jemiliano2001-blip/SMV-VISION/TOOL CRIB/PUNZONES-DE-MARCA_HOT-STAMPS/PUNZONES DE MARCA.iso.pdf

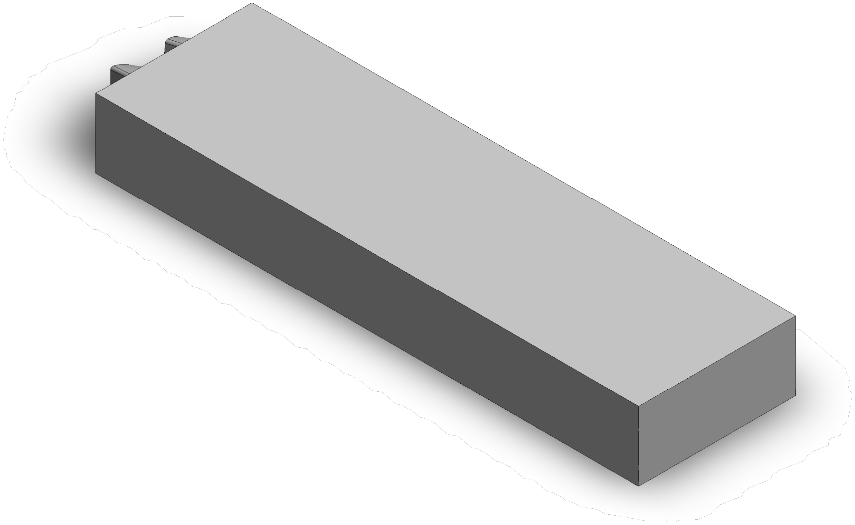
[picture p2: figure]
