jemiliano2001-blip/SMV-VISION/TOOL CRIB/SCREW-GOLDEN_CUTTING-BLADE-PORTUGUESA/SCREW GOLDEN FOR CUTTING BLADE.iso.pdf

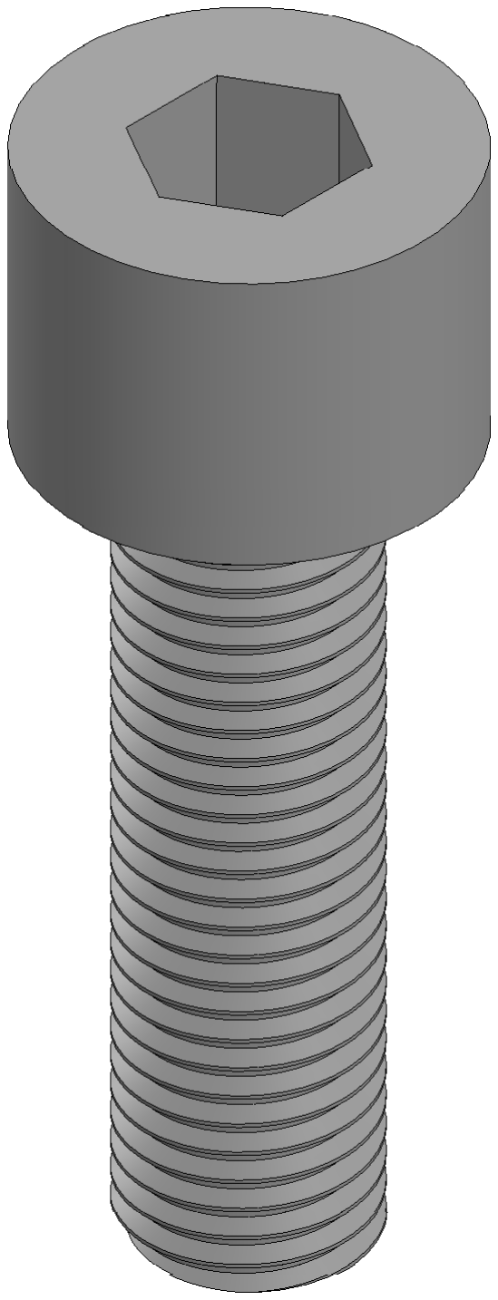
[picture p3: figure]
