jemiliano2001-blip/SMV-VISION/TOOL CRIB/_SIN-CLASIFICAR/14259-63-20-93/14259-63-20-93.iso.pdf

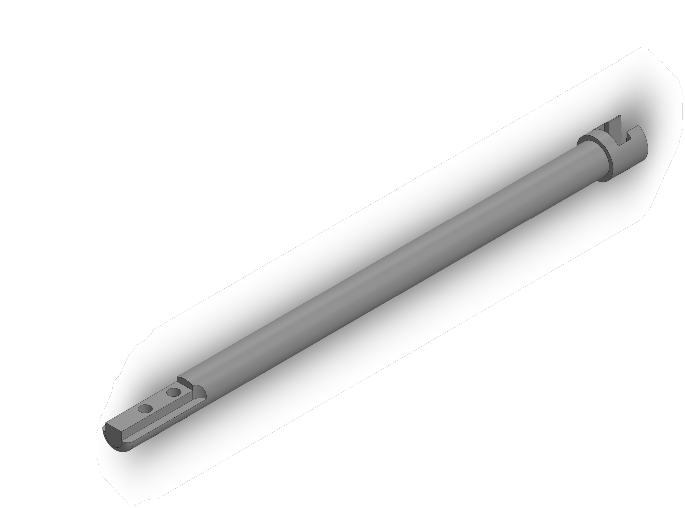
[picture p4: page 1]
