jemiliano2001-blip/SMV-VISION/TOOL CRIB/_SIN-CLASIFICAR/386306/386306.iso.pdf

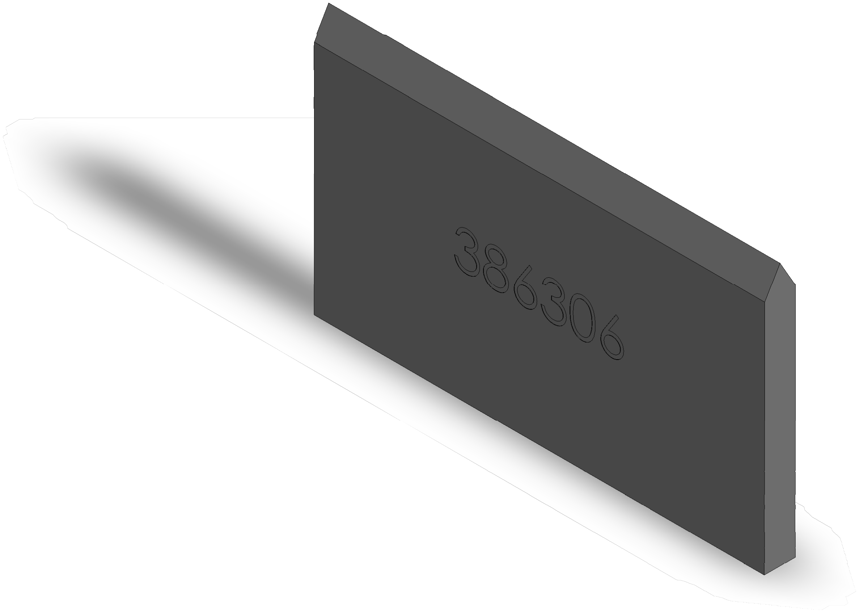
[picture p5: figure]
