jemiliano2001-blip/SMV-VISION/TOOL CRIB/_SIN-CLASIFICAR/90-1216/90-1216.iso.pdf

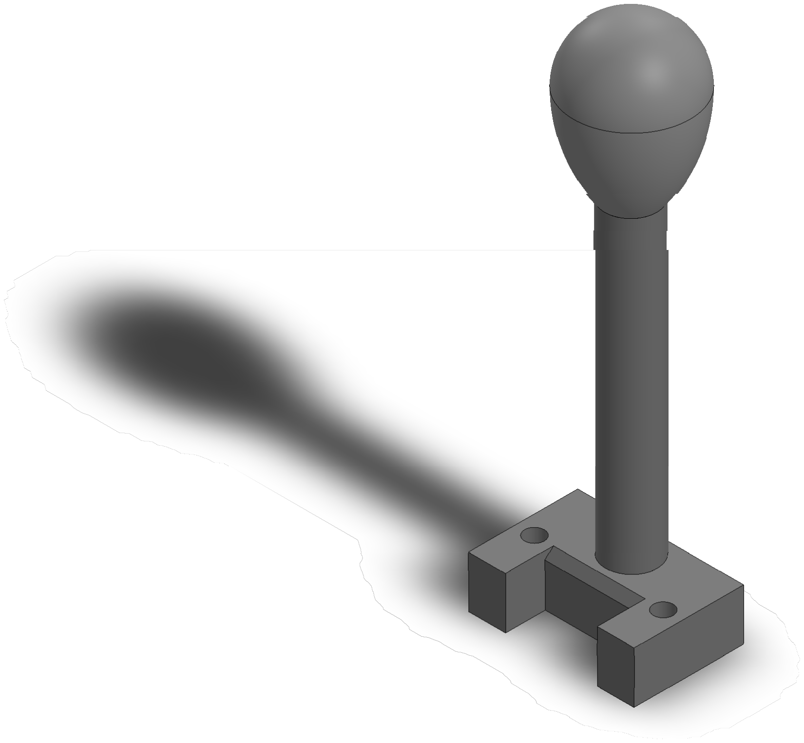
[picture p6: figure]
