jemiliano2001-blip/SMV-VISION/TOOL CRIB/_SIN-CLASIFICAR/90-3262_Rev4_UPSET-CONDUIT-CLAMP/upset-conduit-clamp.iso.pdf

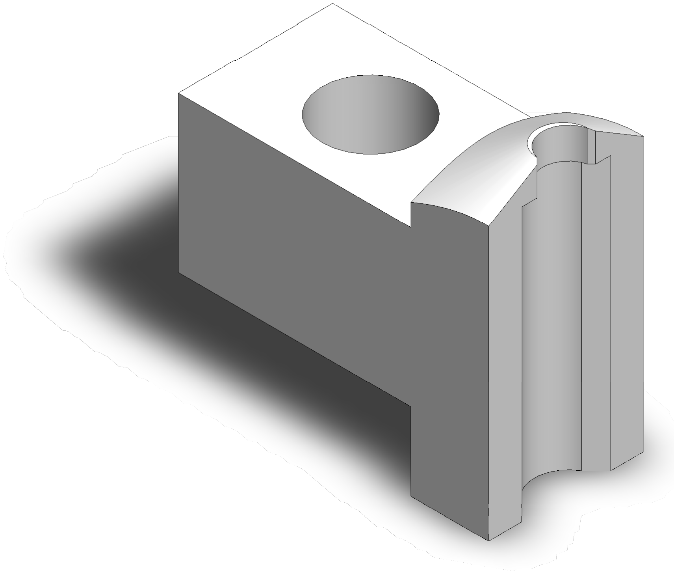
[picture p7: figure]
