jemiliano2001-blip/SMV-VISION/TOOL CRIB/_SIN-CLASIFICAR/90-3342_PIN-STRIPPER/pin stripper 90-3342.iso.pdf

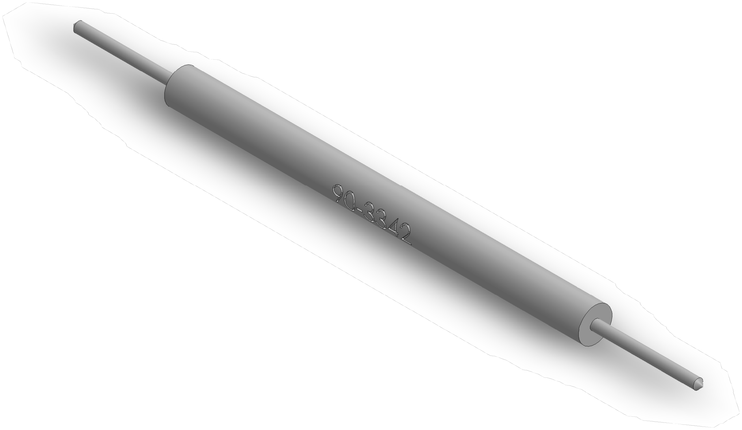
[picture p8: figure]
