jemiliano2001-blip/SMV-VISION/TOOL CRIB/BLOCKS/BLOCK-1135-2/block 1135-2.iso.pdf

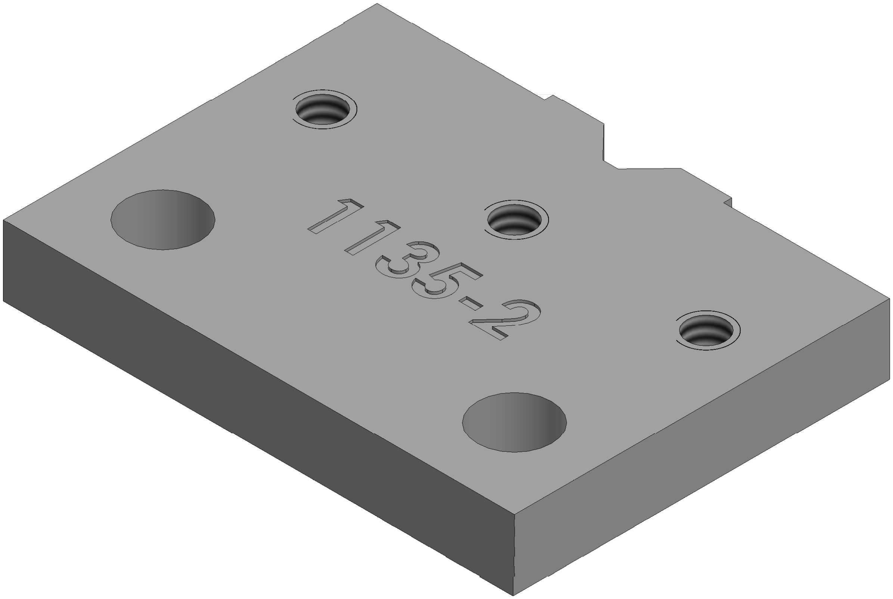
[picture p9: figure]
