jemiliano2001-blip/SMV-VISION/TOOL CRIB/BLOCKS/SWAGE-BLOCK/BLOCK-UT2035RB.iso.pdf

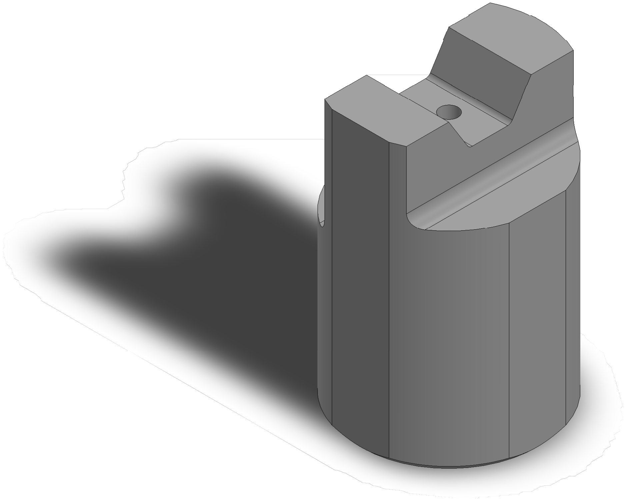
[picture p10: figure]
