jemiliano2001-blip/SMV-VISION/TOOL CRIB/BLOCKS/T-8762_BLOCK/BLOCK T-8762.iso.pdf

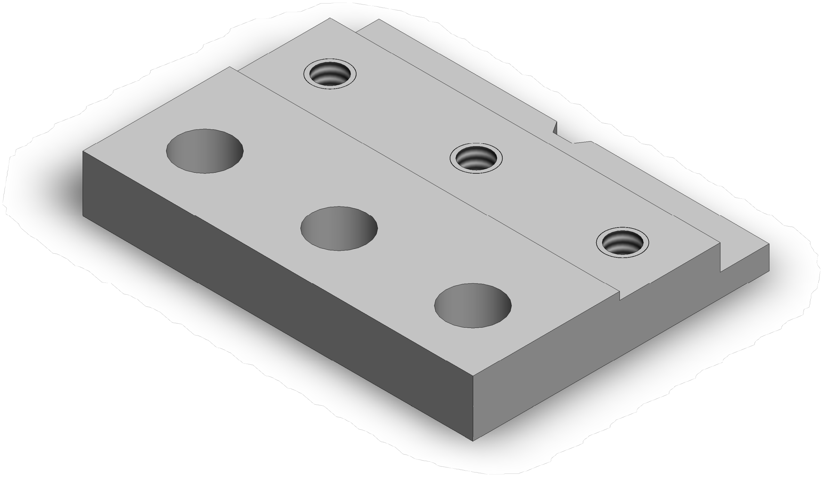
[picture p11: figure]
