jemiliano2001-blip/SMV-VISION/TOOL CRIB/NAVAJAS-SEGUNDO-CORTE/90-1012-05_Rev3_NAVAJAS-SEGUNDO-CORTE/1012-05.iso.pdf

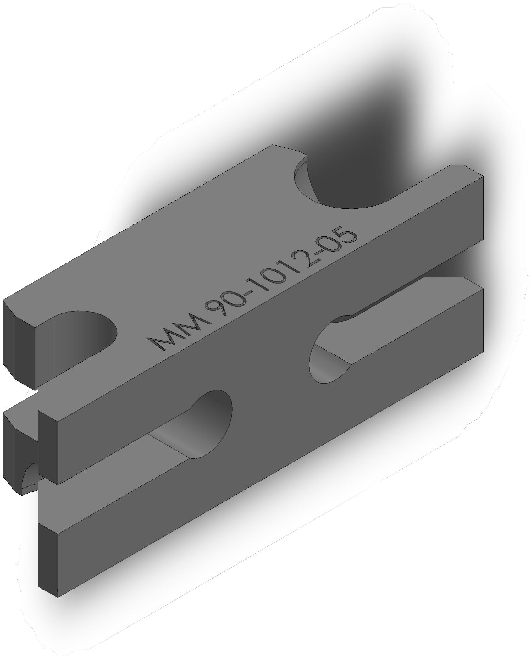
[picture p12: figure]
