jemiliano2001-blip/SMV-VISION/TOOL CRIB/NAVAJAS-SEGUNDO-CORTE/90-1012-06_NAVAJAS-SEGUNDO-CORTE/1012-06.iso.pdf

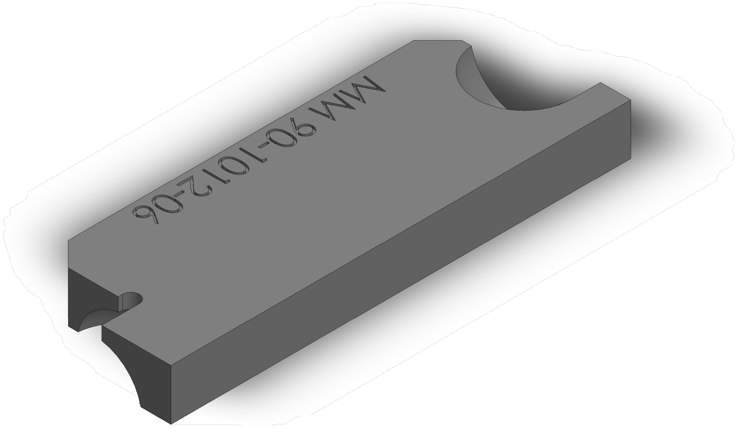
[picture p13: figure]
