jemiliano2001-blip/SMV-VISION/TOOL CRIB/NAVAJAS-SEGUNDO-CORTE/90-4150-06_NAVAJAS-SEGUNDO-CORTE/4150-06.iso.pdf

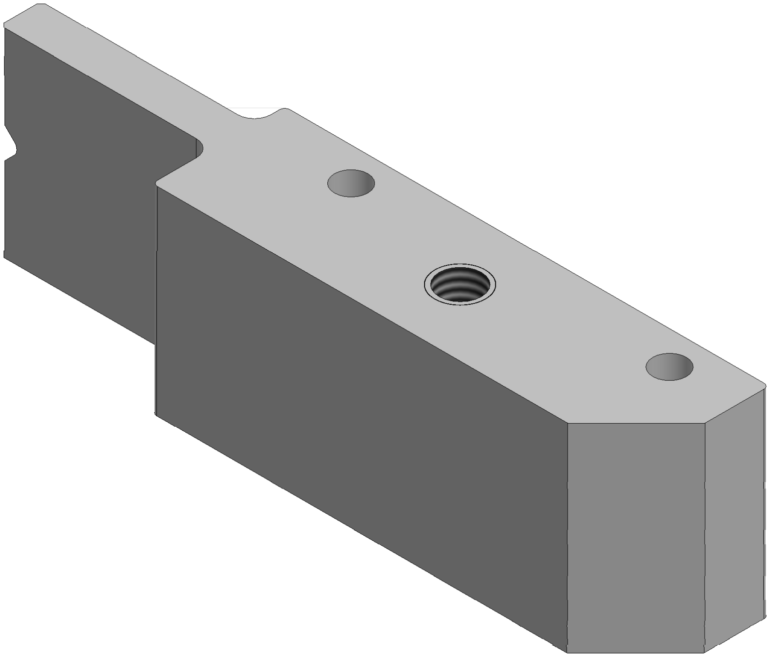
[picture p14: figure]
