jemiliano2001-blip/SMV-VISION/TOOL CRIB/WCD/WCD01-1745/WCD 01-1745-101.iso.pdf

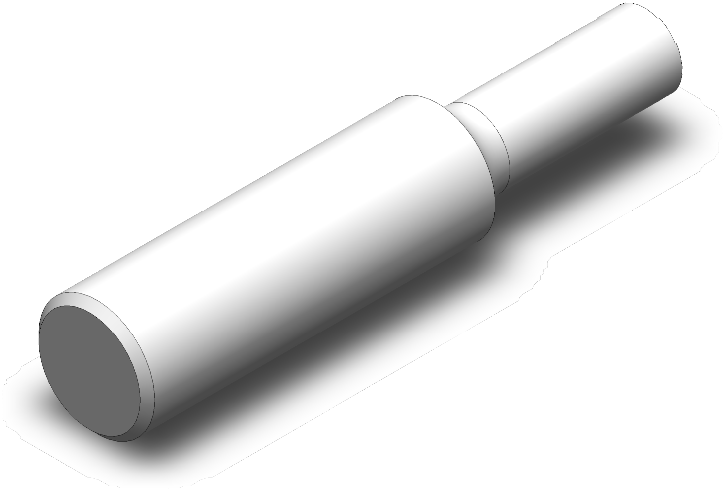
[picture p15: figure]
