jemiliano2001-blip/SMV-VISION/TOOL CRIB/WCD/WCD01-1745/WCD 01-1745-102.iso.pdf

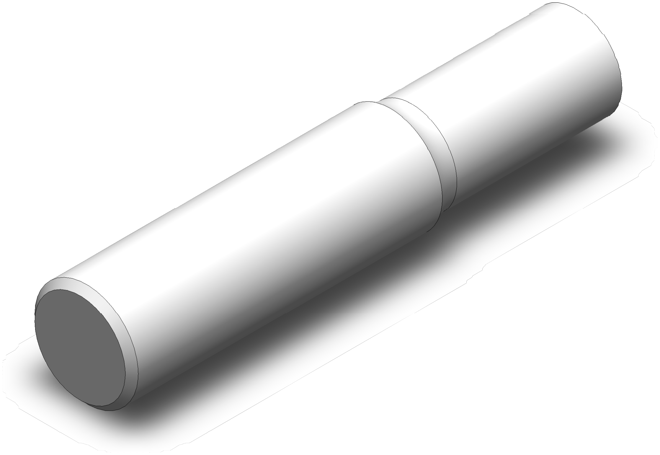
[picture p16: figure]
