jemiliano2001-blip/SMV-VISION/TOOL CRIB/WCD/WCD01-1745/WCD 01-1745-104.iso.pdf

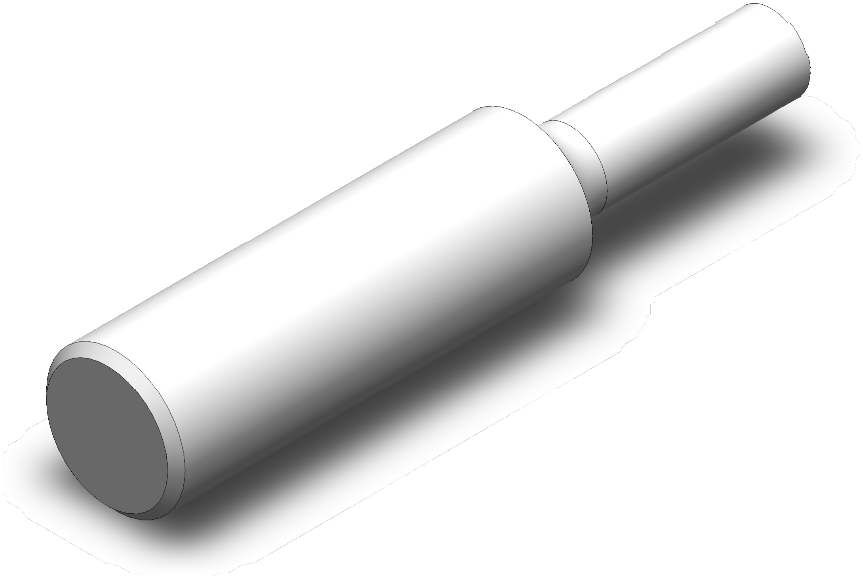
[picture p17: figure]
