jemiliano2001-blip/SMV-VISION/TOOL CRIB/WCD/WCD01-573-101/WCD 01-573-101.iso.pdf

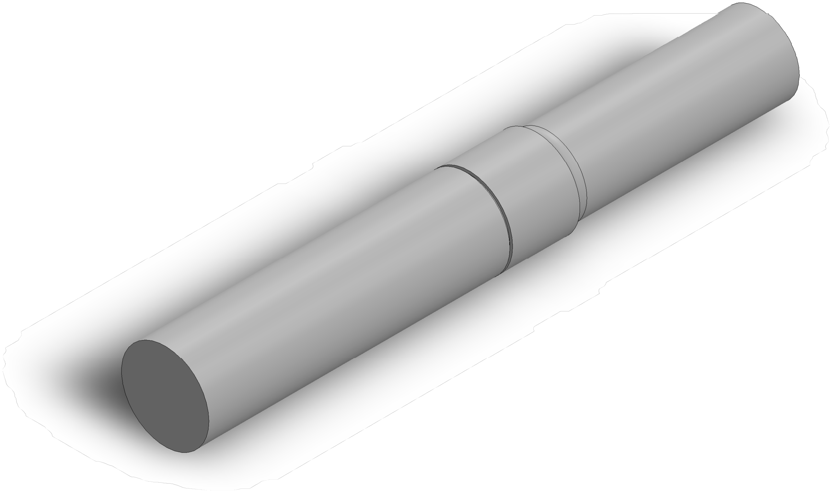
[picture p18: figure]
