jemiliano2001-blip/SMV-VISION/TOOL CRIB/WCD/WCD01-573-101/WCD 01-573-103.iso.pdf

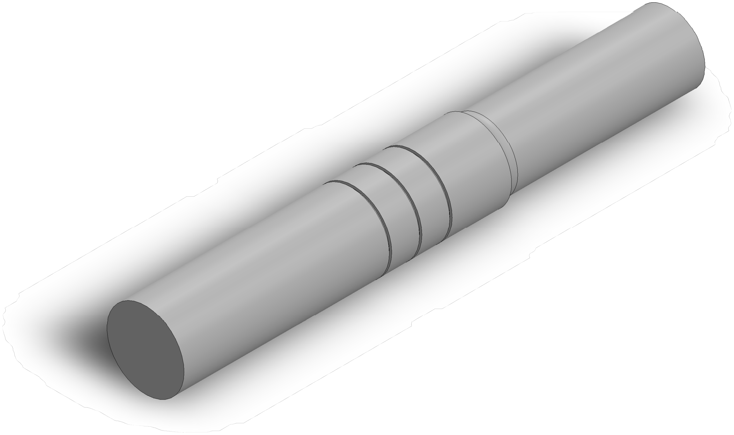
[picture p20: figure]
