jemiliano2001-blip/SMV-VISION/TOOL CRIB/WCD/WCD16-1452-01 BLOCKS/wcd16-1452-01.iso.pdf

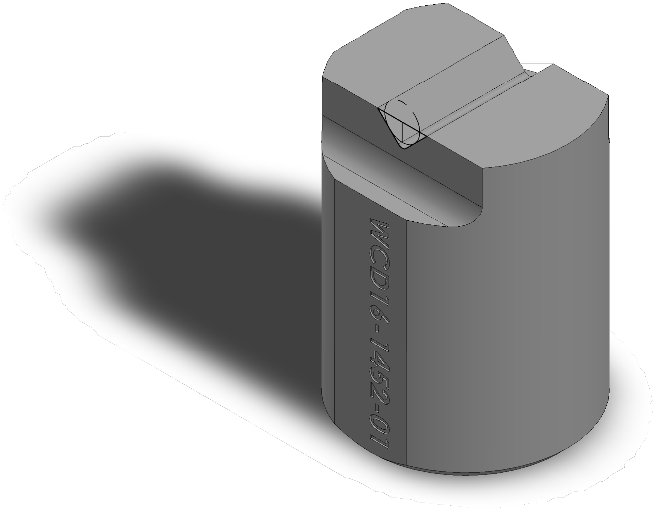
[picture p21: figure]
