jemiliano2001-blip/SMV-VISION/TOOL CRIB/_SIN-CLASIFICAR/90-0541-01B_Rev1/90-0541-01Brev1.pdf

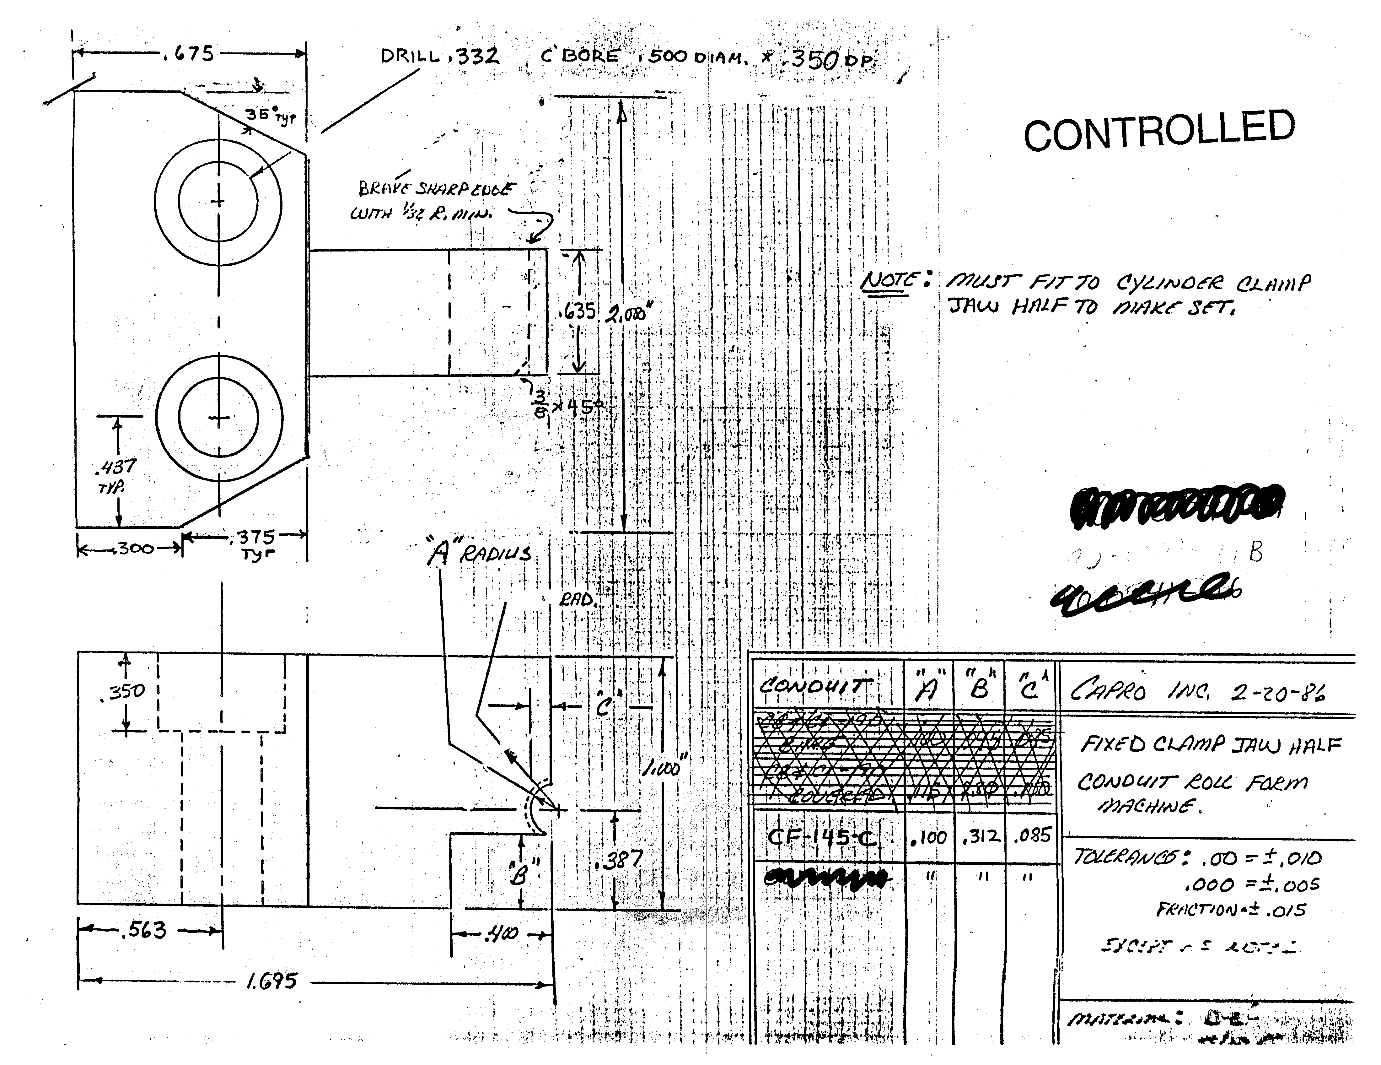
[picture p22: page 1]
