jemiliano2001-blip/SMV-VISION/TOOL CRIB/_SIN-CLASIFICAR/90-1105-01_Rev2/90-1105-01rev2.pdf

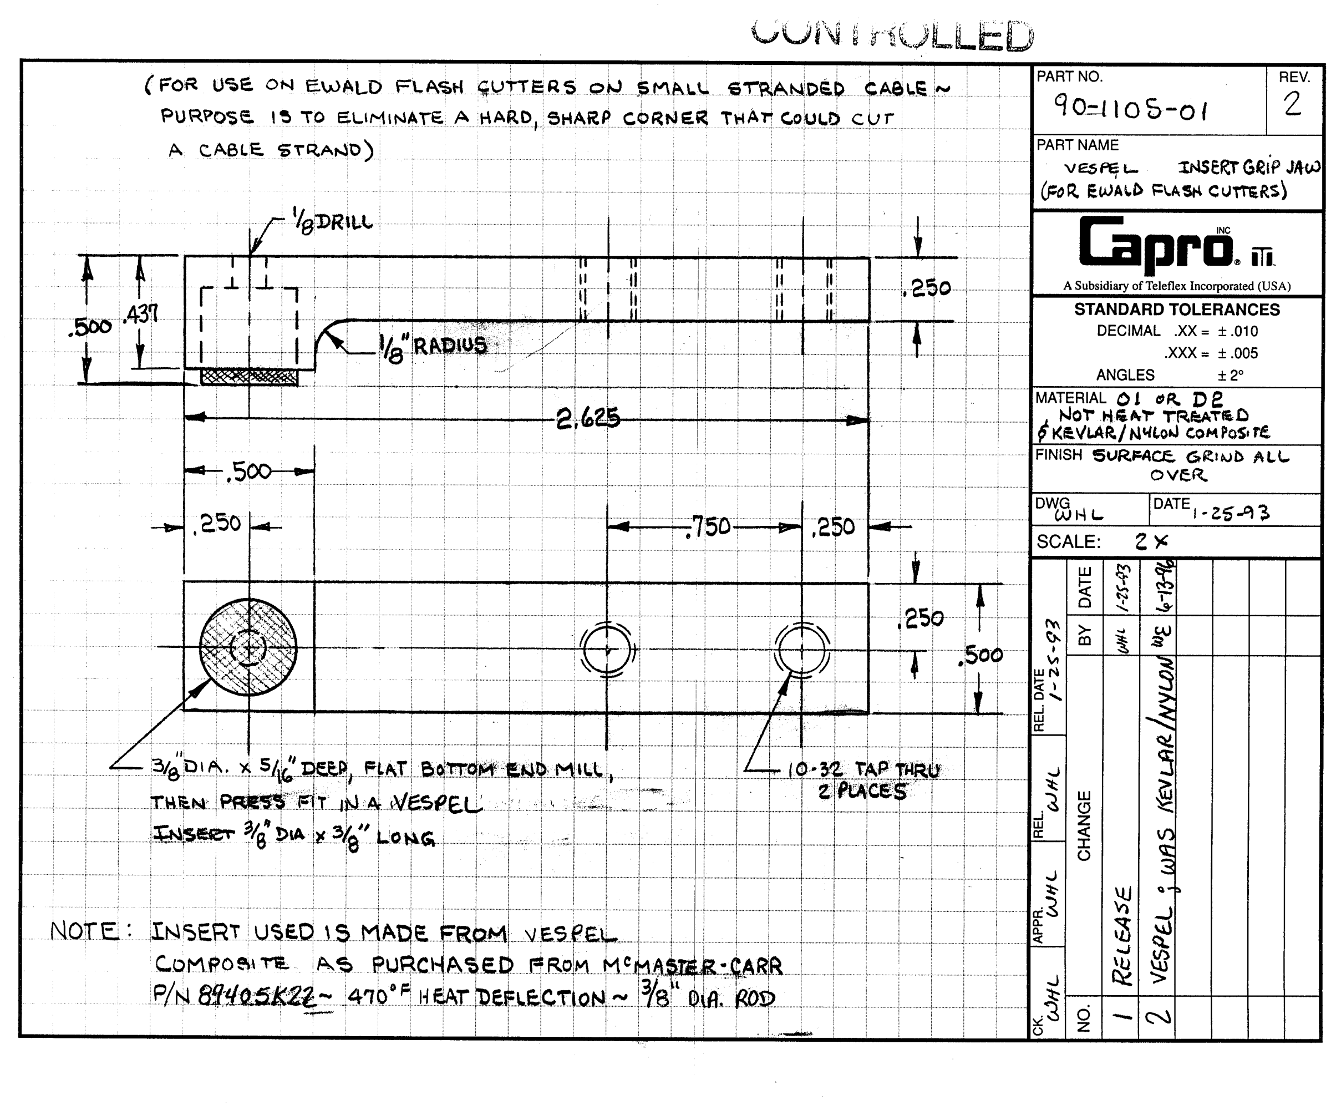
[picture p23: page 1]
