jemiliano2001-blip/SMV-VISION/TOOL CRIB/_SIN-CLASIFICAR/90-5492_90-5493/PDF Images/90-5492rev1f4b98a53.png

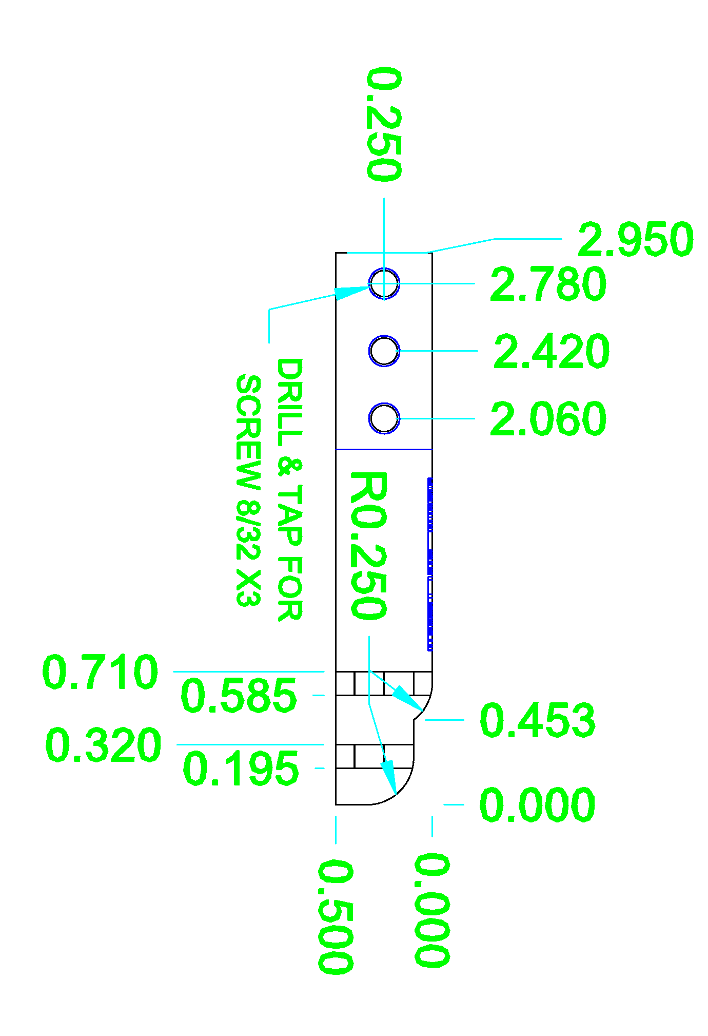
TOOL CRIB/_SIN-CLASIFICAR/90-5492_90-5493/PDF Images/90-5492rev1f4b98a53.png
