jemiliano2001-blip/SMV-VISION/TOOL CRIB/NAVAJAS-SEGUNDO-CORTE/90-4150-06_NAVAJAS-SEGUNDO-CORTE/Captura de pantalla 2024-11-08 162517.png

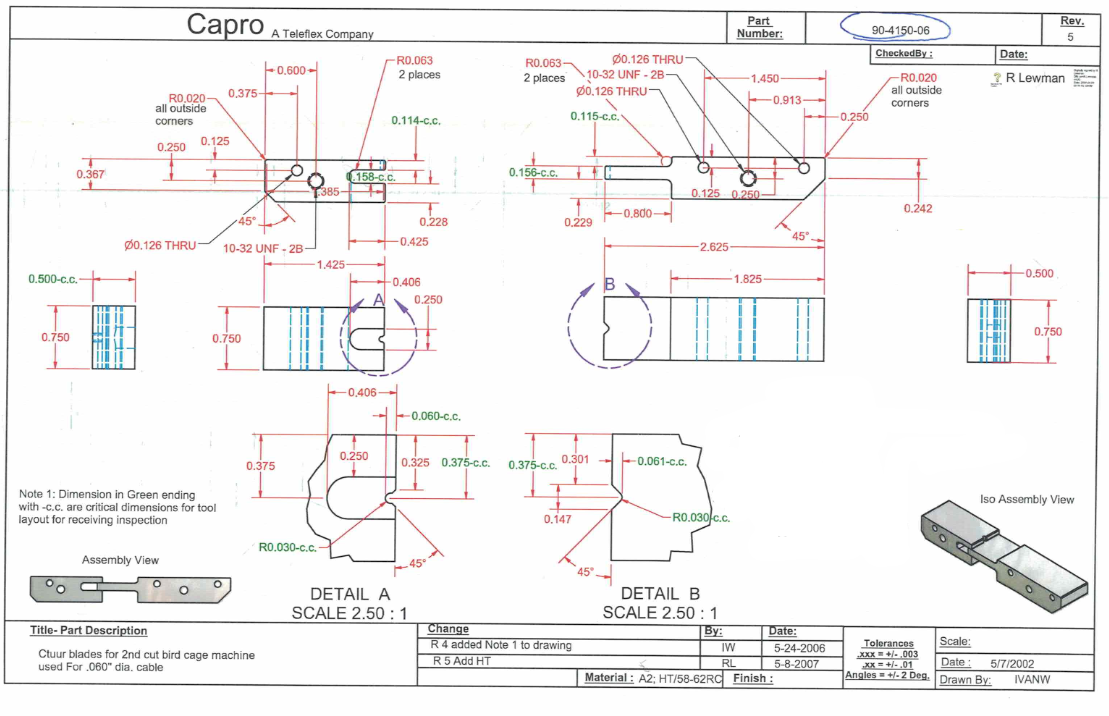
TOOL CRIB/NAVAJAS-SEGUNDO-CORTE/90-4150-06_NAVAJAS-SEGUNDO-CORTE/Captura de pantalla 2024-11-08 162517.png
