jemiliano2001-blip/SMV-VISION/TOOL CRIB/NAVAJAS-SEGUNDO-CORTE/90-4150-06_NAVAJAS-SEGUNDO-CORTE/TODAS LAS PIEZAS.SLDASM

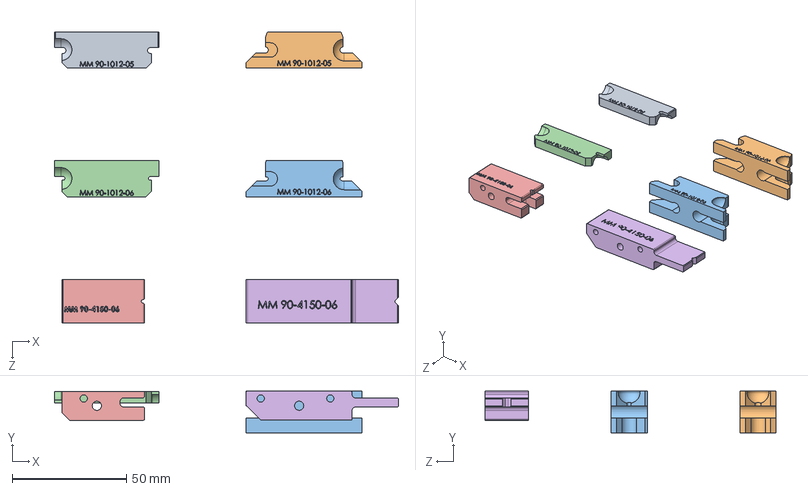
[picture p29: CAD file, 2026-05-04]
TOOL CRIB/NAVAJAS-SEGUNDO-CORTE/90-4150-06_NAVAJAS-SEGUNDO-CORTE/TODAS LAS PIEZAS.SLDASM
150.6 x 18.2 x 127.5 mm
90-4150-06 -B MOD 24-01-2025
90-4150-06 -A MOD 24-01-2025
