jemiliano2001-blip/SMV-VISION/TOOL CRIB/WCD/WCD01-1745/WCD 01-1745.SLDASM

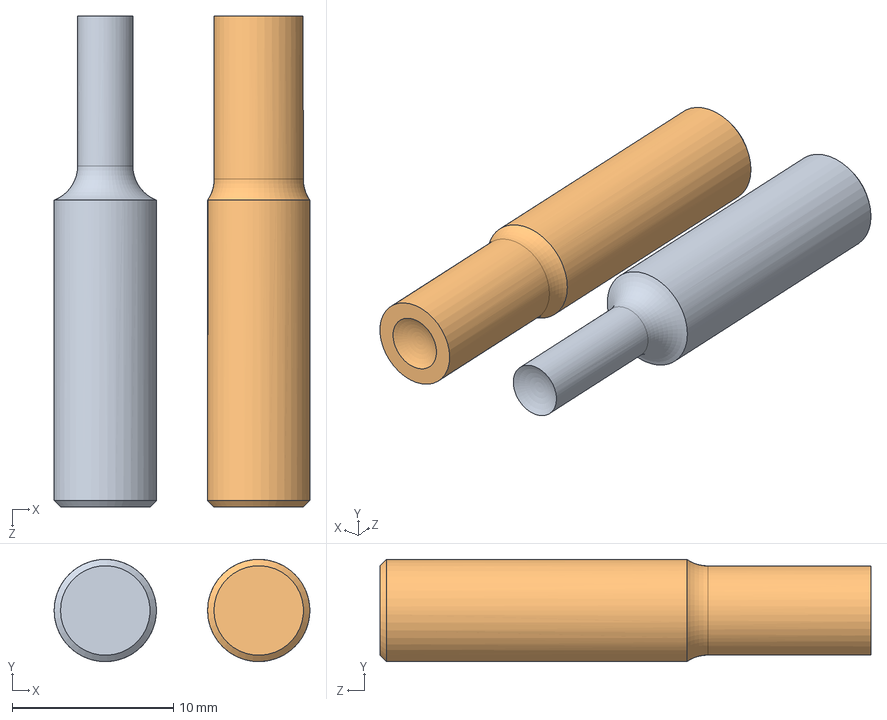
[picture p30: CAD file, 2026-05-04]
TOOL CRIB/WCD/WCD01-1745/WCD 01-1745.SLDASM
15.9 x 6.35 x 30.5 mm
WCD 01-1745-102
WCD 01-1745-104
