jemiliano2001-blip/SMV-VISION/TOOL CRIB/WCD/WCD01-573-101/WCD 01-573.SLDASM

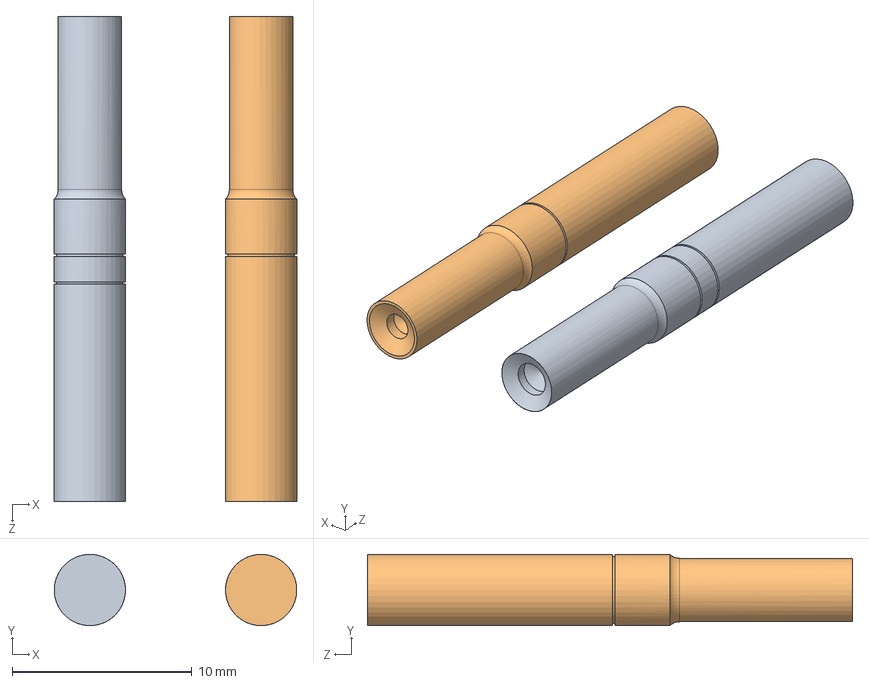
[picture p31: CAD file, 2026-05-04]
TOOL CRIB/WCD/WCD01-573-101/WCD 01-573.SLDASM
13.5 x 3.96 x 27.0 mm
WCD 01-573-101
WCD 01-573-102
