jemiliano2001-blip/SMV-VISION/TOOL CRIB/_REFERENCIA/DIBUJOS-PRACTICANTES/90+5518/90-5518.SLDPRT

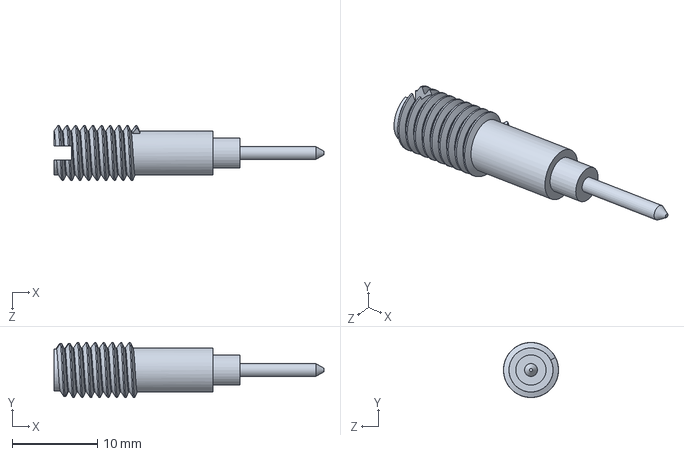
[picture p32: CAD file, 2026-06-08]
TOOL CRIB/_REFERENCIA/DIBUJOS-PRACTICANTES/90+5518/90-5518.SLDPRT
31.8 x 6.48 x 6.48 mm
