jemiliano2001-blip/SMV-VISION/TOOL CRIB/_REFERENCIA/DIBUJOS-PRACTICANTES/90-0900/90-0900.SLDPRT

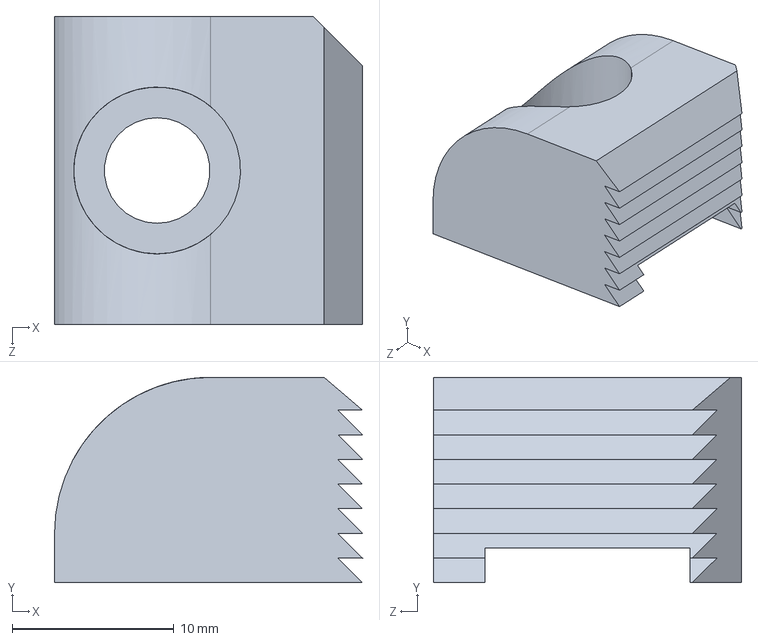
[picture p33: CAD file, 2026-06-08]
TOOL CRIB/_REFERENCIA/DIBUJOS-PRACTICANTES/90-0900/90-0900.SLDPRT
19.1 x 12.7 x 19.1 mm
