jemiliano2001-blip/SMV-VISION/TOOL CRIB/_REFERENCIA/DIBUJOS-PRACTICANTES/90-3305/90-3305.SLDPRT

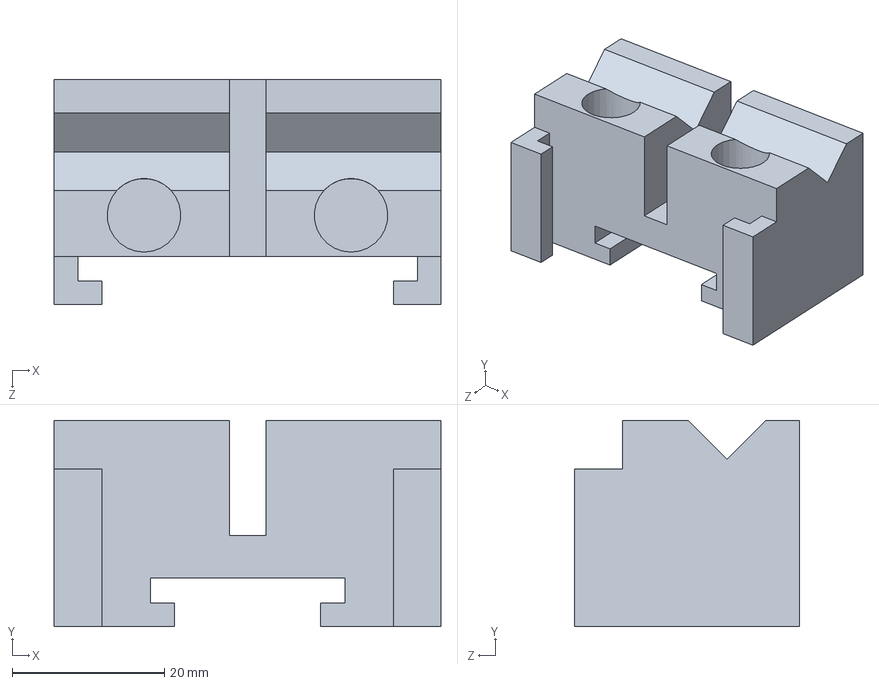
[picture p34: CAD file, 2026-06-08]
TOOL CRIB/_REFERENCIA/DIBUJOS-PRACTICANTES/90-3305/90-3305.SLDPRT
50.8 x 27.1 x 29.6 mm
