jemiliano2001-blip/SMV-VISION/TOOL CRIB/_REFERENCIA/DIBUJOS-PRACTICANTES/UT2033/UT2033.SLDPRT

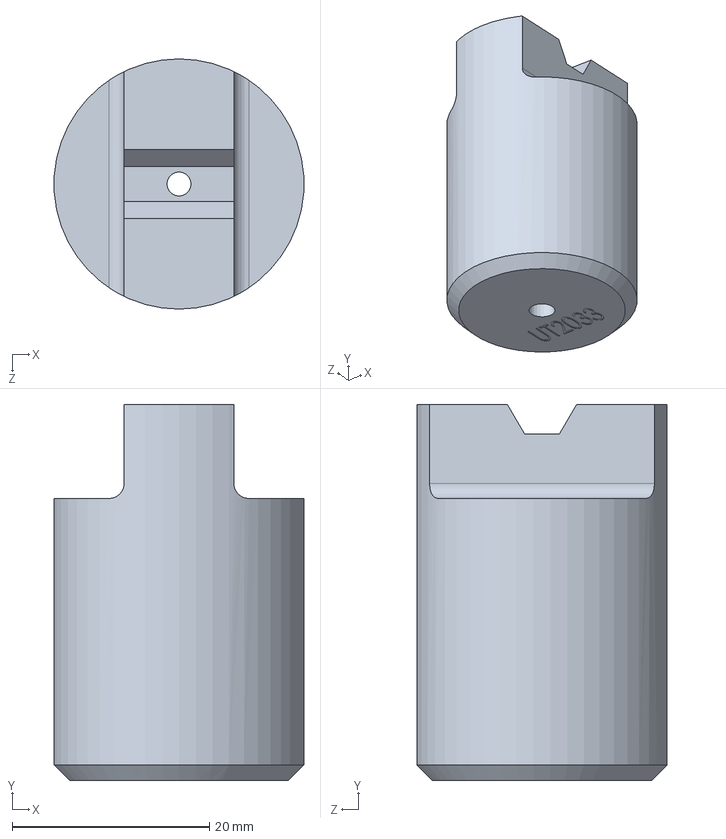
[picture p35: CAD file, 2026-06-08]
TOOL CRIB/_REFERENCIA/DIBUJOS-PRACTICANTES/UT2033/UT2033.SLDPRT
25.3 x 38.1 x 25.3 mm
