jemiliano2001-blip/SMV-VISION/TOOL CRIB/_SIN-CLASIFICAR/273-17-04167/273-17-04167.SLDPRT

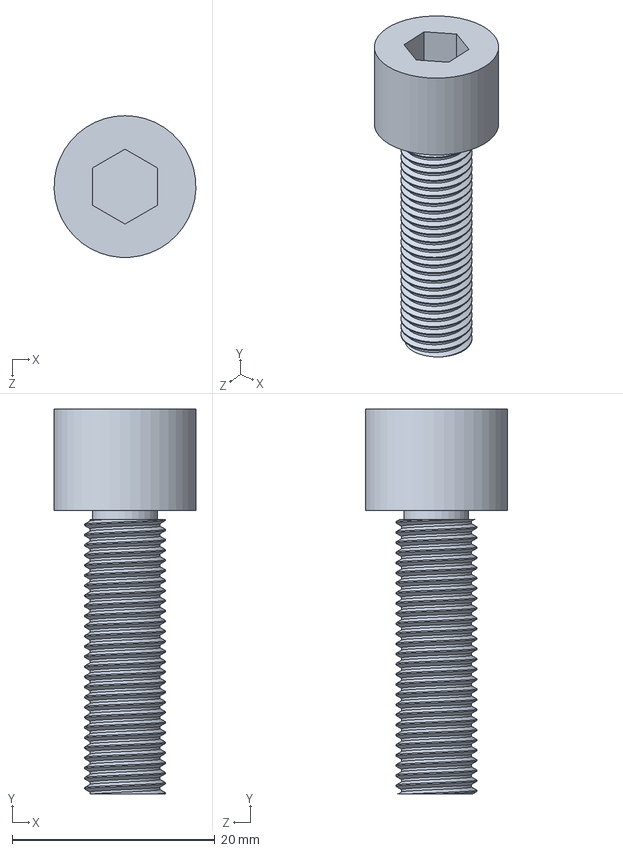
[picture p36: CAD file, 2026-05-04]
TOOL CRIB/_SIN-CLASIFICAR/273-17-04167/273-17-04167.SLDPRT
14.0 x 38.0 x 14.0 mm
