jemiliano2001-blip/SMV-VISION/TOOL CRIB/_SIN-CLASIFICAR/90-3262_Rev4_UPSET-CONDUIT-CLAMP/90-3262-Rev4.SLDPRT

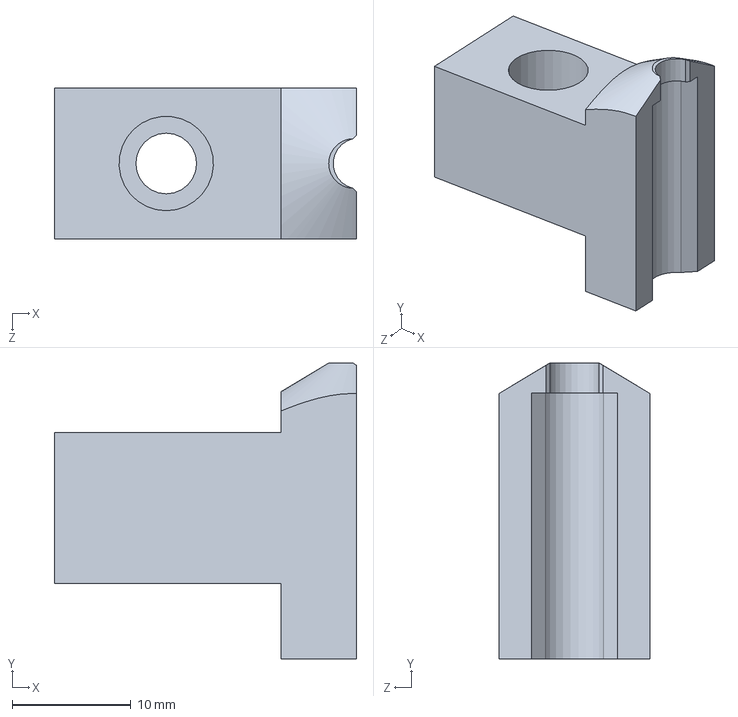
[picture p37: CAD file, 2026-05-04]
TOOL CRIB/_SIN-CLASIFICAR/90-3262_Rev4_UPSET-CONDUIT-CLAMP/90-3262-Rev4.SLDPRT
25.4 x 24.9 x 12.7 mm
