jemiliano2001-blip/SMV-VISION/TOOL CRIB/_SIN-CLASIFICAR/90-3342_PIN-STRIPPER/90-3342.SLDPRT

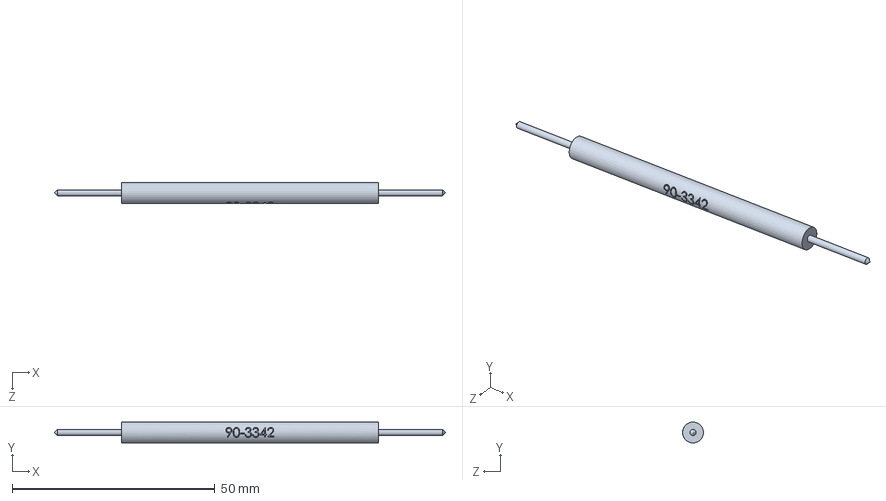
[picture p38: CAD file, 2026-05-04]
TOOL CRIB/_SIN-CLASIFICAR/90-3342_PIN-STRIPPER/90-3342.SLDPRT
96.5 x 5.16 x 5.14 mm
