jemiliano2001-blip/SMV-VISION/TOOL CRIB/_SIN-CLASIFICAR/90-5317_Rev2_BLADE-PIN/90-5317Rev2.SLDPRT

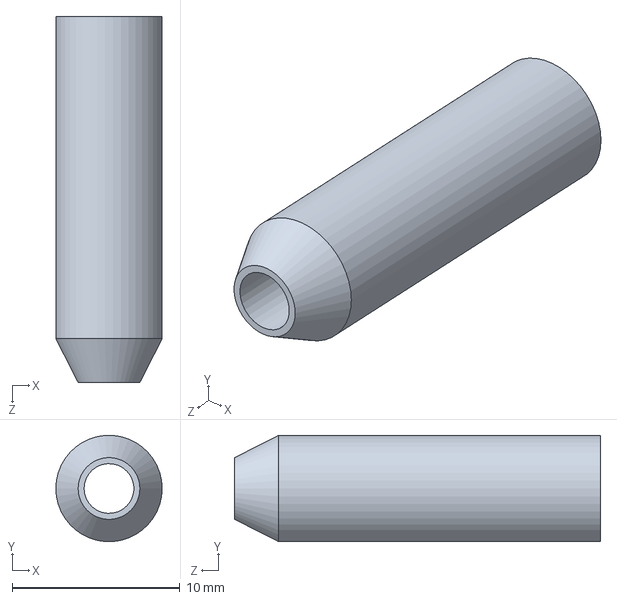
[picture p39: CAD file, 2026-06-02]
TOOL CRIB/_SIN-CLASIFICAR/90-5317_Rev2_BLADE-PIN/90-5317Rev2.SLDPRT
6.35 x 6.33 x 21.8 mm
