jemiliano2001-blip/SMV-VISION/TOOL CRIB/BLOCKS/BLOCK-1135-2/block 1135-2.SLDPRT

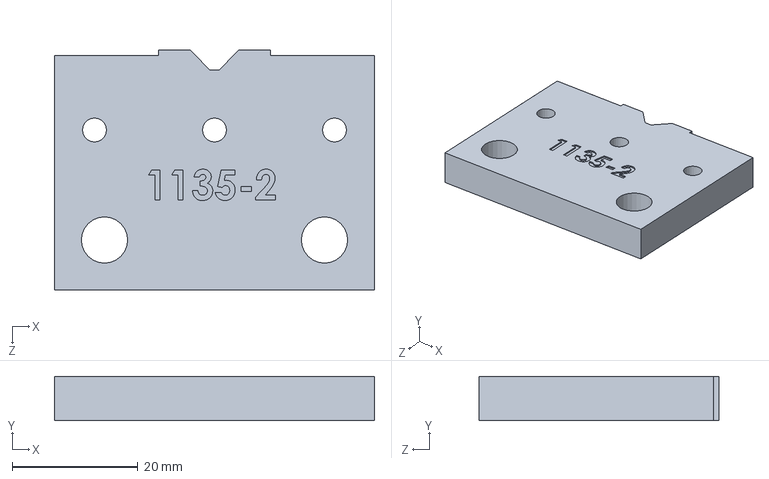
[picture p41: CAD file, 2026-05-04]
TOOL CRIB/BLOCKS/BLOCK-1135-2/block 1135-2.SLDPRT
50.8 x 6.98 x 38.1 mm
