jemiliano2001-blip/SMV-VISION/TOOL CRIB/BLOCKS/T-8762_BLOCK/BLOCK T-8762.SLDPRT

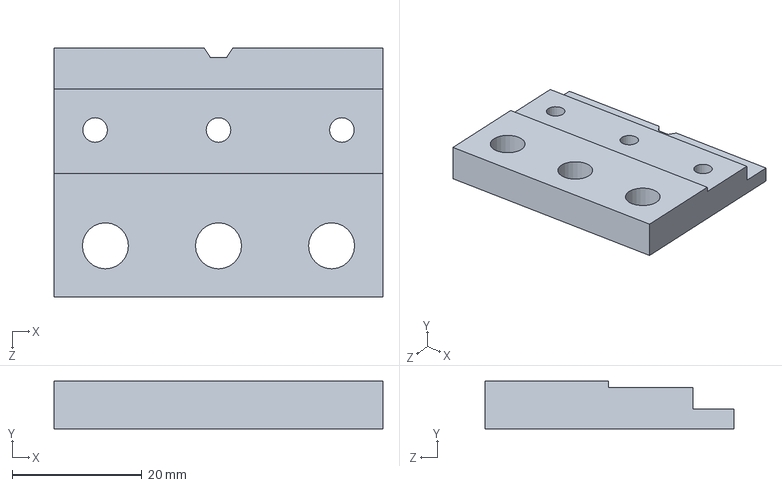
[picture p42: CAD file, 2026-05-04]
TOOL CRIB/BLOCKS/T-8762_BLOCK/BLOCK T-8762.SLDPRT
50.8 x 7.37 x 38.5 mm
