jemiliano2001-blip/SMV-VISION/TOOL CRIB/NAVAJAS-SEGUNDO-CORTE/90-1012-05_Rev3_NAVAJAS-SEGUNDO-CORTE/90-1012-05-001.SLDPRT

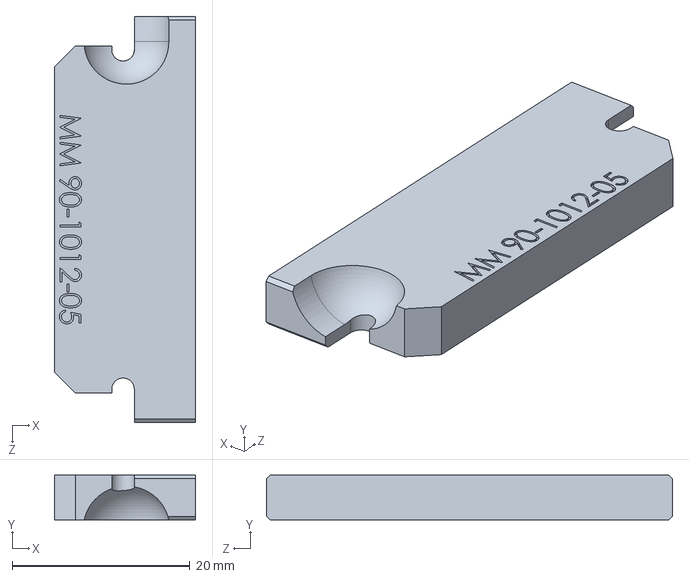
[picture p43: CAD file, 2026-05-04]
TOOL CRIB/NAVAJAS-SEGUNDO-CORTE/90-1012-05_Rev3_NAVAJAS-SEGUNDO-CORTE/90-1012-05-001.SLDPRT
15.9 x 5.05 x 45.7 mm
