jemiliano2001-blip/SMV-VISION/TOOL CRIB/PUNZONES-DE-MARCA_HOT-STAMPS/PUNZONES DE MARCA-SUPRAJIT SMV-003.SLDPRT

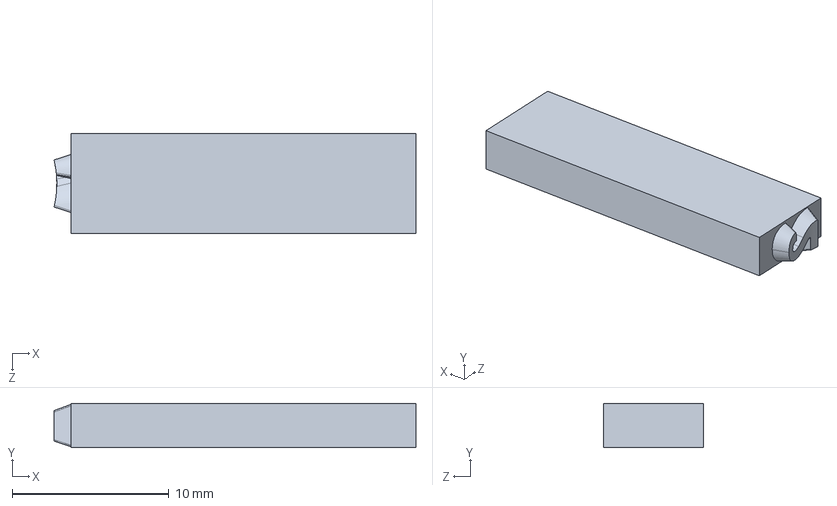
[picture p45: CAD file, 2026-05-04]
TOOL CRIB/PUNZONES-DE-MARCA_HOT-STAMPS/PUNZONES DE MARCA-SUPRAJIT SMV-003.SLDPRT
23.1 x 2.81 x 6.35 mm
