jemiliano2001-blip/SMV-VISION/TOOL CRIB/WCD/WCD01-1745/WCD 01-1745-104.SLDPRT

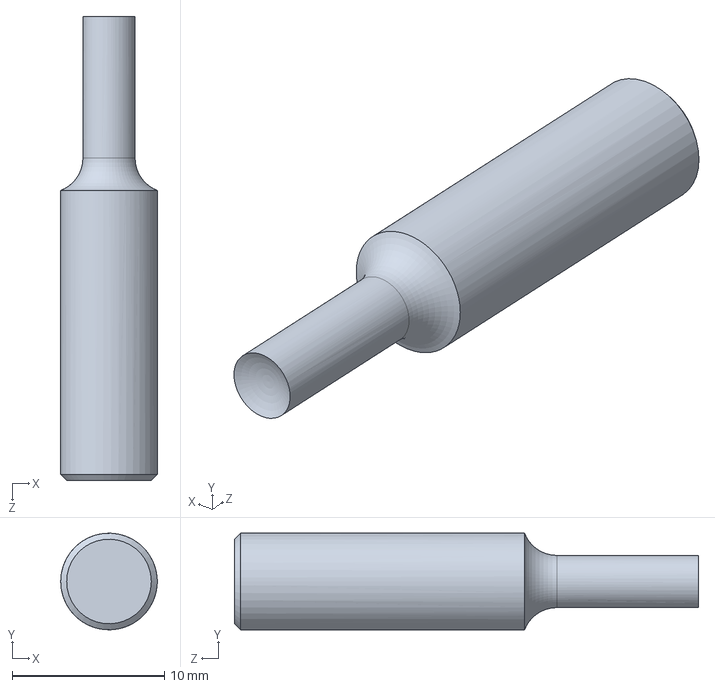
[picture p48: CAD file, 2026-05-04]
TOOL CRIB/WCD/WCD01-1745/WCD 01-1745-104.SLDPRT
6.35 x 6.35 x 30.5 mm
