jemiliano2001-blip/SMV-VISION/TOOL CRIB/WCD/WCD01-573-101/WCD 01-573-101.SLDPRT

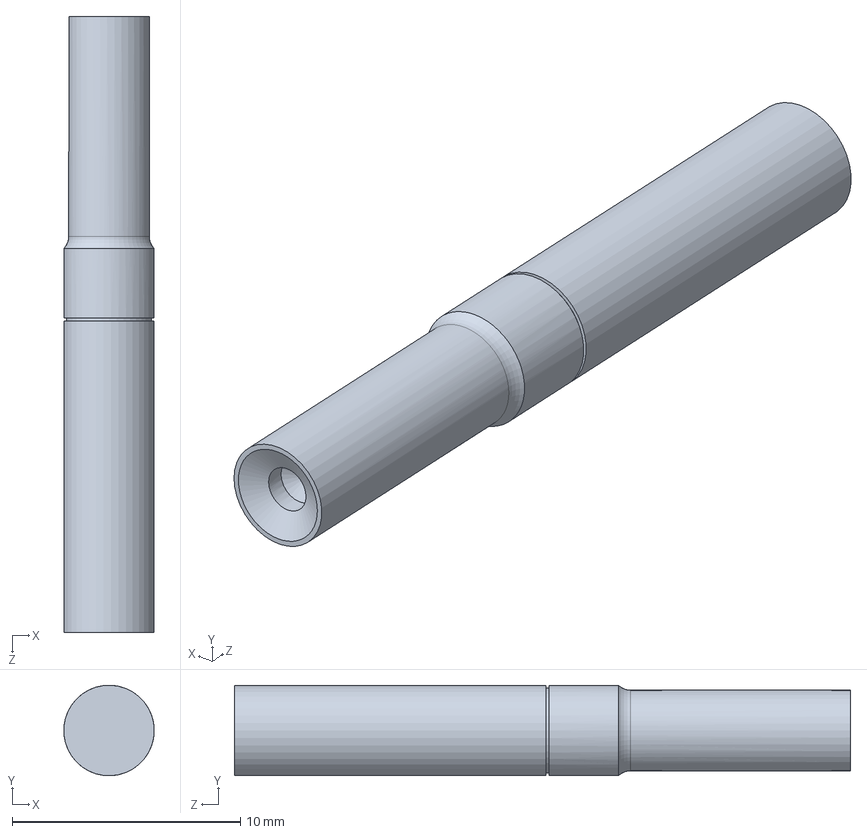
[picture p49: CAD file, 2026-05-04]
TOOL CRIB/WCD/WCD01-573-101/WCD 01-573-101.SLDPRT
3.96 x 3.96 x 27.0 mm
