jemiliano2001-blip/SMV-VISION/TOOL CRIB/WCD/WCD16-1452-01 BLOCKS/wcd16-1452-01.SLDPRT

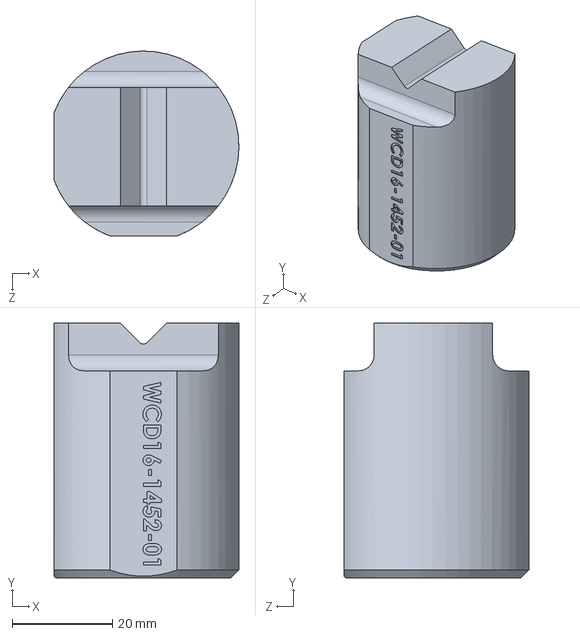
[picture p50: CAD file, 2026-06-02]
TOOL CRIB/WCD/WCD16-1452-01 BLOCKS/wcd16-1452-01.SLDPRT
36.8 x 50.8 x 36.8 mm
