jemiliano2001-blip/SMV-VISION/TOOL CRIB/WCD03-1797/WCD03-1797/ORIGINAL NO TOCAR/WCD03-1797.SLDPRT

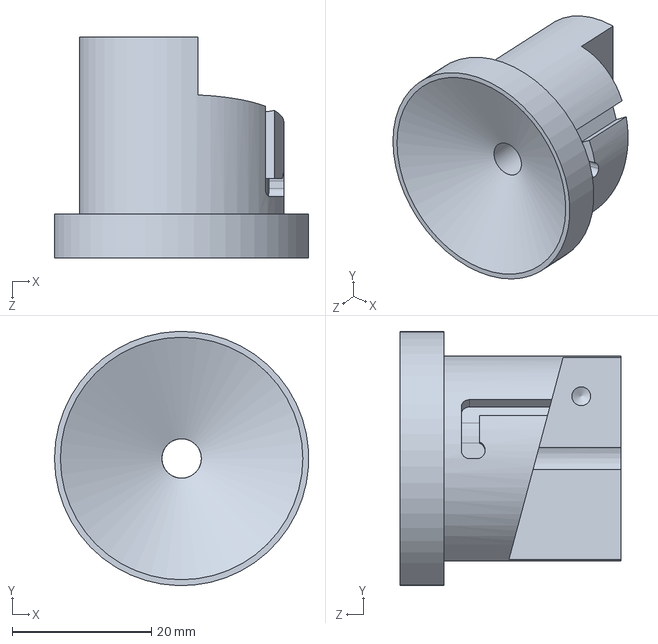
[picture p51: CAD file, 2026-06-08]
TOOL CRIB/WCD03-1797/WCD03-1797/ORIGINAL NO TOCAR/WCD03-1797.SLDPRT
36.5 x 36.5 x 31.8 mm
