jemiliano2001-blip/SMV-VISION/TOOL CRIB/WCD16-1452/ORIGINAL NO TOCAR/WCD16-1452.SLDPRT

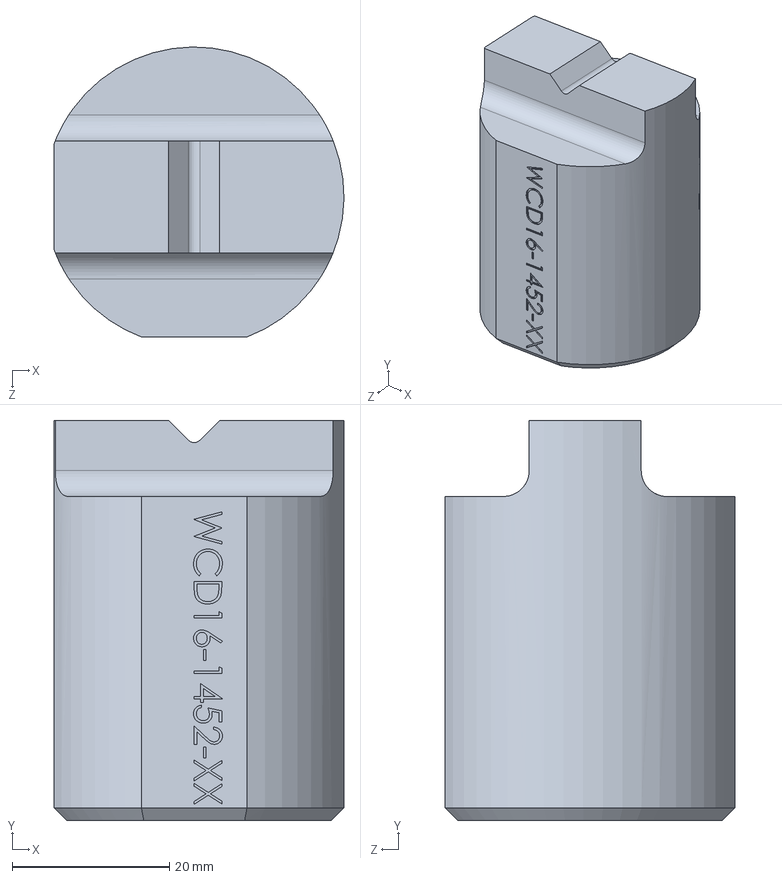
[picture p52: CAD file, 2026-06-02]
TOOL CRIB/WCD16-1452/ORIGINAL NO TOCAR/WCD16-1452.SLDPRT
36.8 x 50.8 x 36.8 mm
