jemiliano2001-blip/SMV-VISION/TOOL CRIB/_SIN-CLASIFICAR/90-1216/90-1216-01.SLDPRT

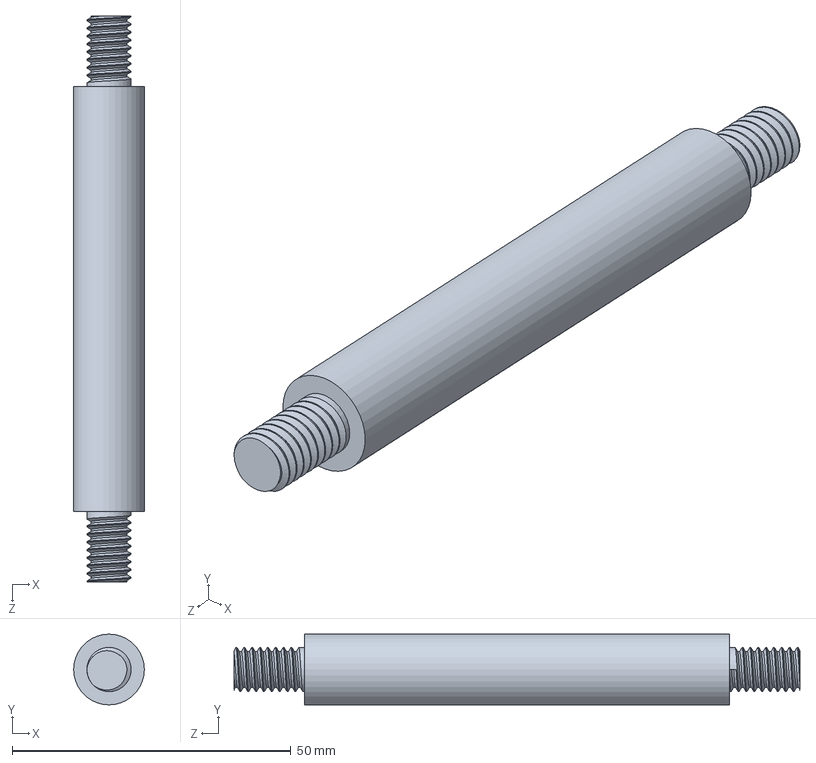
[picture p53: CAD file, 2026-05-04]
TOOL CRIB/_SIN-CLASIFICAR/90-1216/90-1216-01.SLDPRT
12.7 x 12.7 x 101.6 mm
