jemiliano2001-blip/SMV-VISION/TOOL CRIB/_SIN-CLASIFICAR/90-5492_90-5493/90-5492rev1.SLDPRT

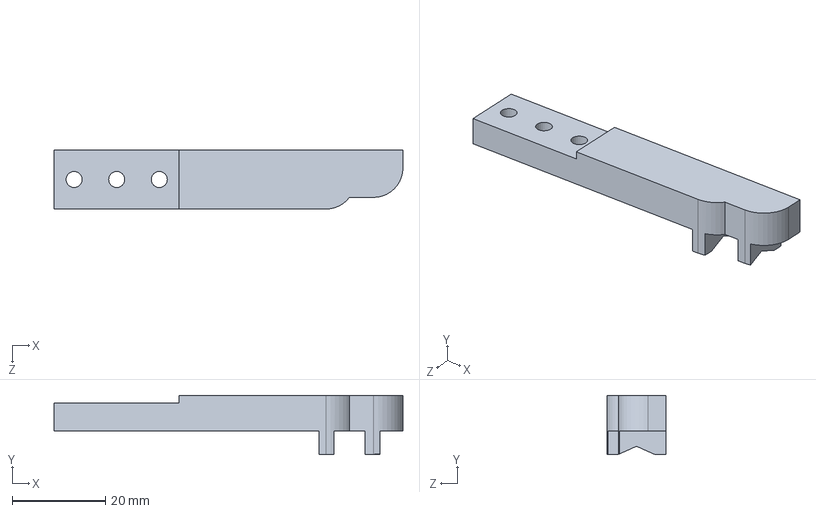
[picture p55: CAD file, 2026-05-04]
TOOL CRIB/_SIN-CLASIFICAR/90-5492_90-5493/90-5492rev1.SLDPRT
74.9 x 12.7 x 12.7 mm
