jemiliano2001-blip/SMV-VISION/TOOL CRIB/BLOCKS/SWAGE-BLOCK/PIN UT BLOCKS.SLDPRT

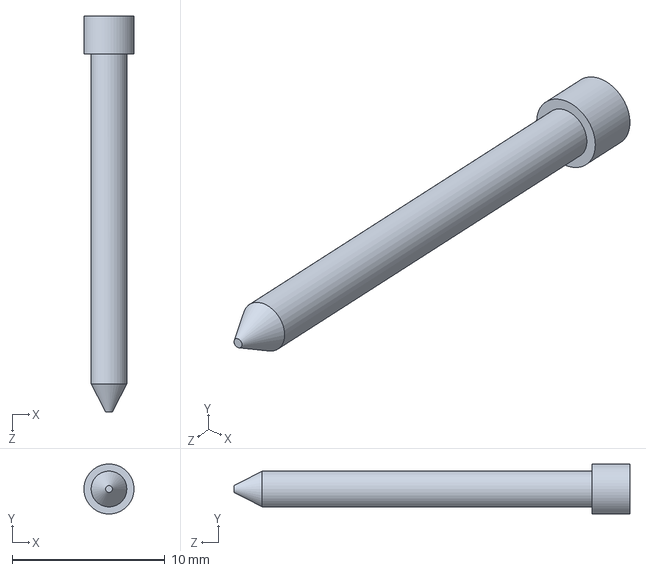
[picture p56: CAD file, 2026-05-04]
TOOL CRIB/BLOCKS/SWAGE-BLOCK/PIN UT BLOCKS.SLDPRT
3.28 x 3.27 x 25.9 mm
