jemiliano2001-blip/SMV-VISION/TOOL CRIB/NAVAJAS-SEGUNDO-CORTE/90-1012-05_Rev3_NAVAJAS-SEGUNDO-CORTE/90-1012-05.SLDPRT

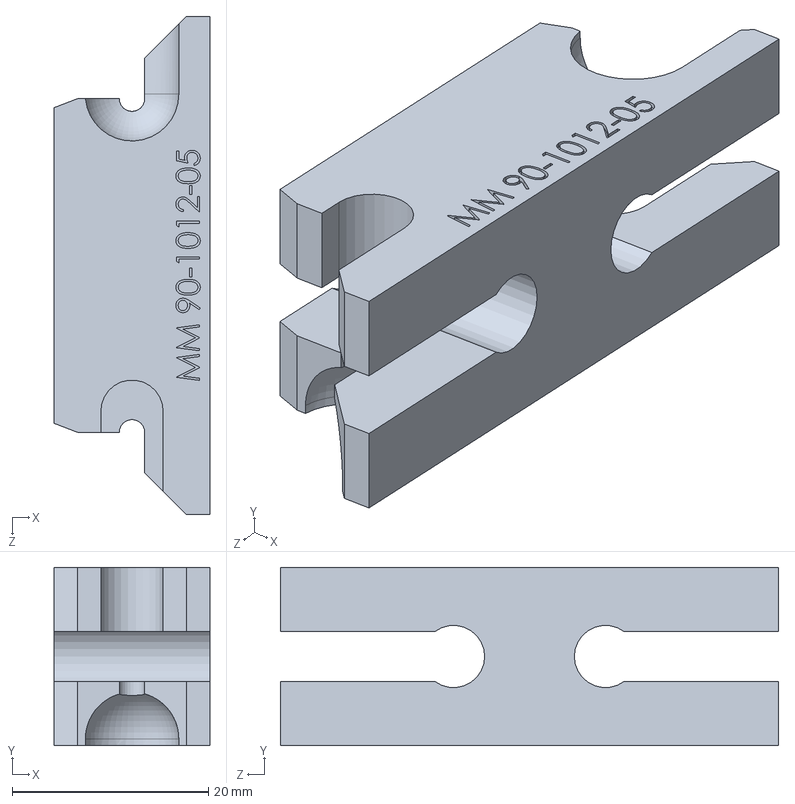
[picture p57: CAD file, 2026-05-04]
TOOL CRIB/NAVAJAS-SEGUNDO-CORTE/90-1012-05_Rev3_NAVAJAS-SEGUNDO-CORTE/90-1012-05.SLDPRT
15.9 x 18.2 x 50.8 mm
