jemiliano2001-blip/SMV-VISION/TOOL CRIB/NAVAJAS-SEGUNDO-CORTE/90-4150-06_NAVAJAS-SEGUNDO-CORTE/90-4150-06 -A MOD 24-01-2025.SLDPRT

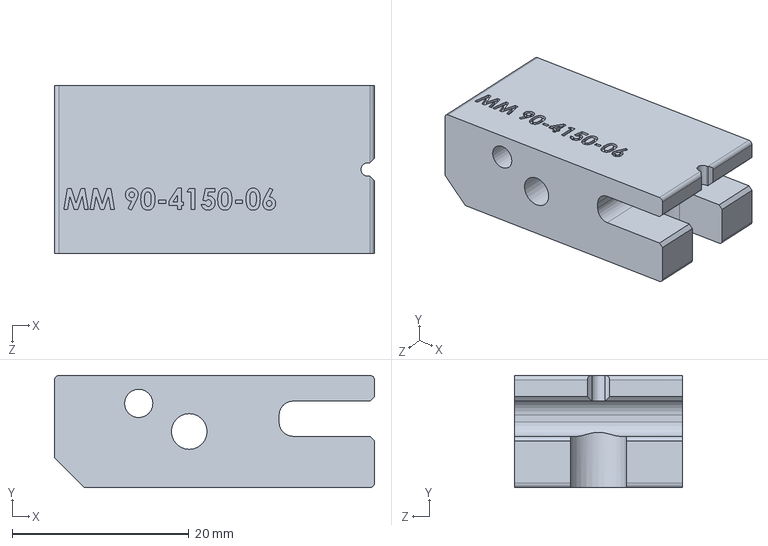
[picture p58: CAD file, 2026-05-04]
TOOL CRIB/NAVAJAS-SEGUNDO-CORTE/90-4150-06_NAVAJAS-SEGUNDO-CORTE/90-4150-06 -A MOD 24-01-2025.SLDPRT
36.2 x 12.7 x 19.1 mm
