jemiliano2001-blip/SMV-VISION/TOOL CRIB/UT2001/UT2001-041.SLDPRT

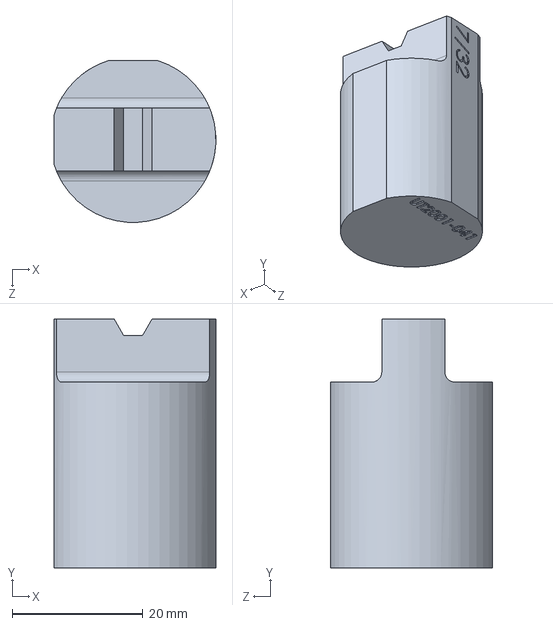
[picture p59: CAD file, 2026-06-02]
TOOL CRIB/UT2001/UT2001-041.SLDPRT
24.8 x 38.1 x 24.7 mm
