jemiliano2001-blip/SMV-VISION/TOOL CRIB/_SIN-CLASIFICAR/90-1216/90-1216-02.SLDPRT

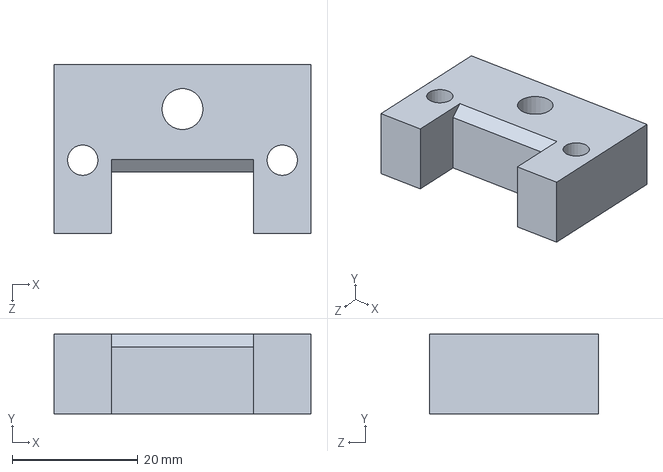
[picture p63: CAD file, 2026-05-04]
TOOL CRIB/_SIN-CLASIFICAR/90-1216/90-1216-02.SLDPRT
40.9 x 12.7 x 26.9 mm
