jemiliano2001-blip/SMV-VISION/TOOL CRIB/_SIN-CLASIFICAR/90-4516/90-4516-05/90-4516-XX SUPRAJIT-001.SLDPRT

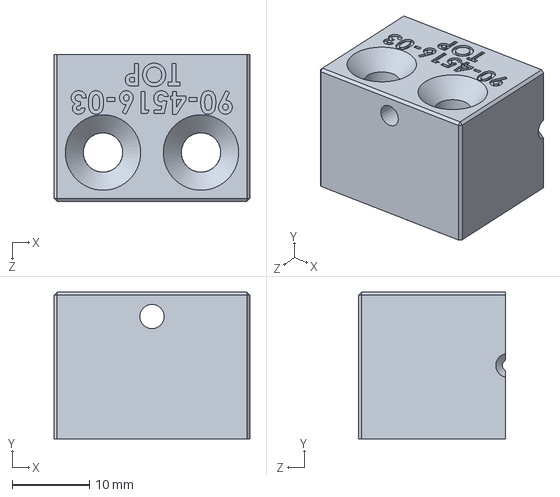
[picture p64: CAD file, 2026-05-04]
TOOL CRIB/_SIN-CLASIFICAR/90-4516/90-4516-05/90-4516-XX SUPRAJIT-001.SLDPRT
25.4 x 19.1 x 19.1 mm
