jemiliano2001-blip/SMV-VISION/TOOL CRIB/PUNZONES-DE-MARCA_HOT-STAMPS/PUNZONES DE MARCA/PUNZONES DE MARCA-SUPRAJIT SMV-033.SLDPRT

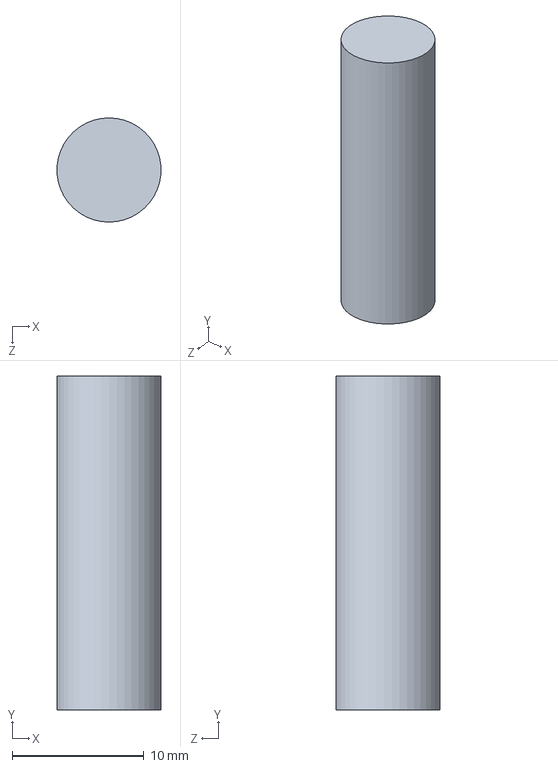
[picture p67: CAD file, 2026-05-04]
TOOL CRIB/PUNZONES-DE-MARCA_HOT-STAMPS/PUNZONES DE MARCA/PUNZONES DE MARCA-SUPRAJIT SMV-033.SLDPRT
7.90 x 25.4 x 7.92 mm
