jemiliano2001-blip/SMV-VISION/TOOL CRIB/_SIN-CLASIFICAR/90-4516/90-4516-03/90-4516-03.SLDASM

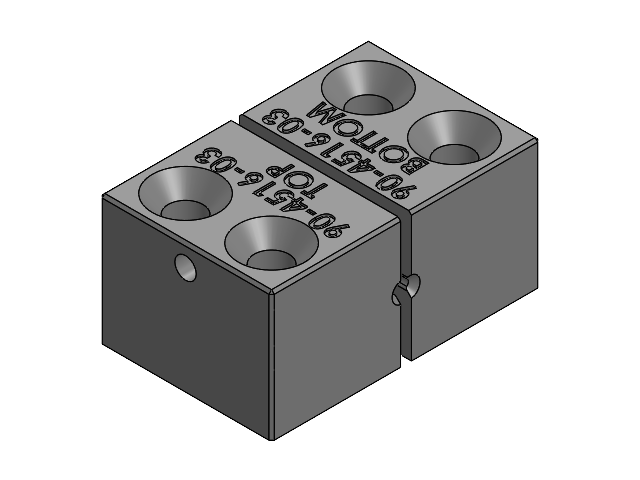
[picture p68: CAD file, 2026-05-04]
TOOL CRIB/_SIN-CLASIFICAR/90-4516/90-4516-03/90-4516-03.SLDASM
90-4516-XX SUPRAJIT-001
90-4516-XX SUPRAJIT-003
