jemiliano2001-blip/SMV-VISION/TOOL CRIB/_SIN-CLASIFICAR/90-4516/90-4516-05/90-4516-05.SLDASM

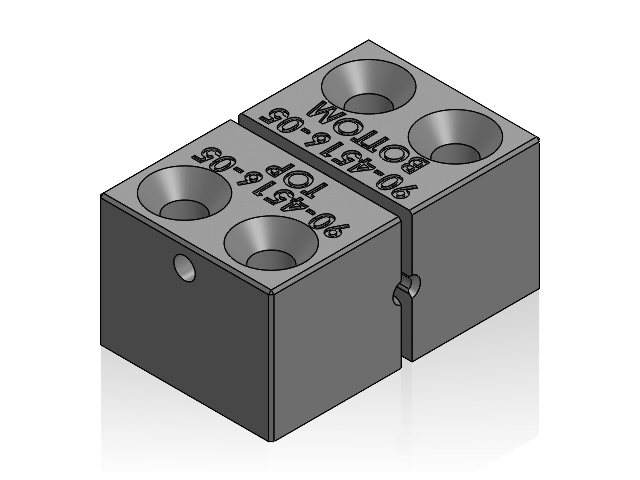
[picture p69: CAD file, 2026-05-04]
TOOL CRIB/_SIN-CLASIFICAR/90-4516/90-4516-05/90-4516-05.SLDASM
90-4516-XX SUPRAJIT-004
90-4516-XX SUPRAJIT-005
