jemiliano2001-blip/SMV-VISION/TOOL CRIB/NAVAJAS-SEGUNDO-CORTE/90-5523_TOOLING-SECOND-CUT/TOOLING FOR SECOND CUT 90-5523.SLDASM

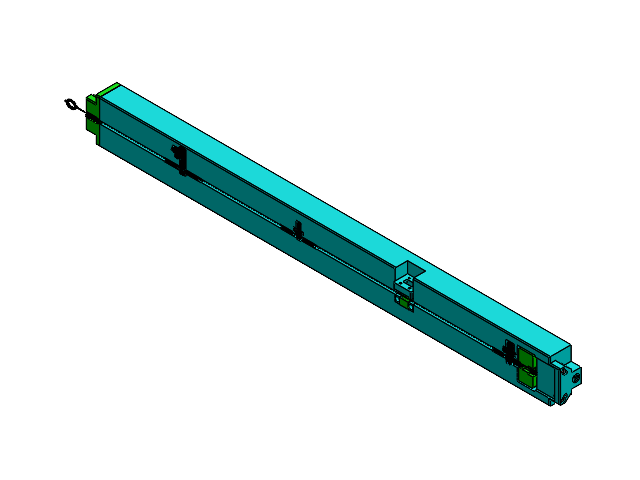
[picture p70: CAD file, 2026-06-08]
TOOL CRIB/NAVAJAS-SEGUNDO-CORTE/90-5523_TOOLING-SECOND-CUT/TOOLING FOR SECOND CUT 90-5523.SLDASM
eBom-FreeParts.dwg
28-0704.dwg
28-1051-04_PCP_000.dwg
40-5163_PCP_000.dwg
27-0001-02.dwg
10-4051_AF0.dwg
1000865276_INSTALL_PCP_000.dwg
30-0466-01_PCP_000.dwg
28-3449_INST_PCP_000.dwg
30-0466-01_PCP_000_AF0.dwg
30-0466-01_PCP_000_AF1.dwg
28-5834_INSTALLED_PCP_000.dwg
30-0466-01_PCP_000_AF2.dwg
30-0466-01_PCP_000_AF3.dwg
_U217.dwg
