jemiliano2001-blip/SMV-VISION/TOOL CRIB/_SIN-CLASIFICAR/90-1216/90-1216.SLDASM

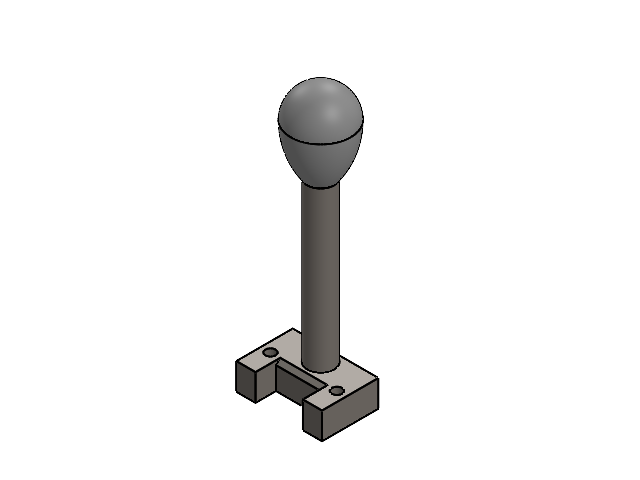
[picture p71: CAD file, 2026-05-04]
TOOL CRIB/_SIN-CLASIFICAR/90-1216/90-1216.SLDASM
6050K14_Black Phenolic Plastic Ball Knob (1)
