jemiliano2001-blip/SMV-VISION/TOOL CRIB/PUNZONES-DE-MARCA_HOT-STAMPS/PUNZONES DE MARCA.SLDASM

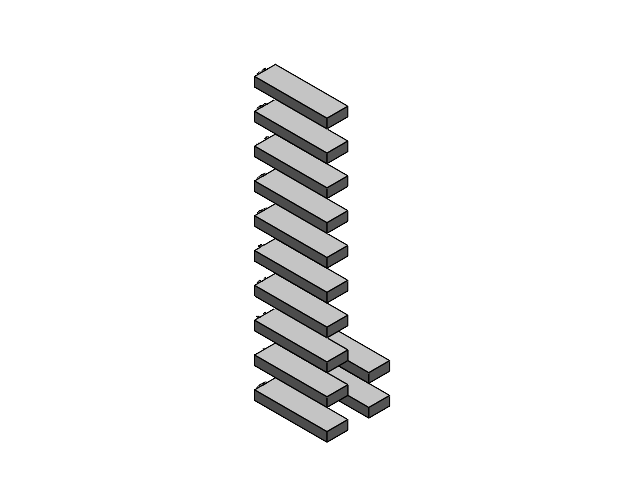
[picture p73: CAD file, 2026-05-04]
TOOL CRIB/PUNZONES-DE-MARCA_HOT-STAMPS/PUNZONES DE MARCA.SLDASM
PUNZONES DE MARCA-SUPRAJIT SMV-001
PUNZONES DE MARCA-SUPRAJIT SMV-002
PUNZONES DE MARCA-SUPRAJIT SMV-016
PUNZONES DE MARCA-SUPRAJIT SMV-007
PUNZONES DE MARCA-SUPRAJIT SMV-011
PUNZONES DE MARCA-SUPRAJIT SMV-006
PUNZONES DE MARCA-SUPRAJIT SMV-010
PUNZONES DE MARCA-SUPRAJIT SMV-009
PUNZONES DE MARCA-SUPRAJIT SMV-008
PUNZONES DE MARCA-SUPRAJIT SMV-005
PUNZONES DE MARCA-SUPRAJIT SMV-004
PUNZONES DE MARCA-SUPRAJIT SMV-003
