jemiliano2001-blip/SMV-VISION/TOOL CRIB/PUNZONES-DE-MARCA_HOT-STAMPS/PUNZONES DE MARCA/PUNZONES DE MARCA.SLDASM

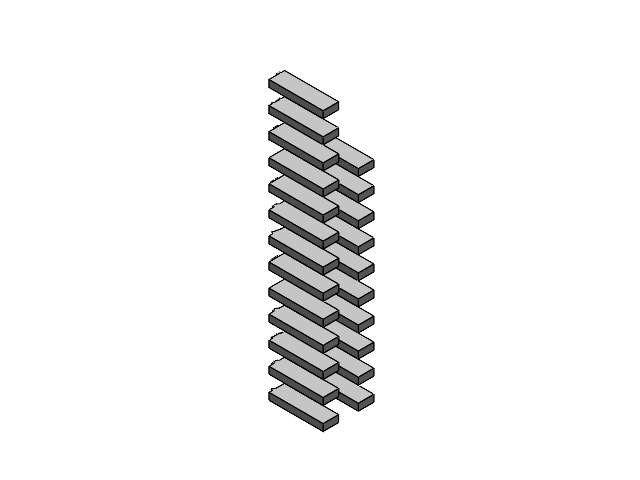
[picture p74: CAD file, 2026-05-04]
TOOL CRIB/PUNZONES-DE-MARCA_HOT-STAMPS/PUNZONES DE MARCA/PUNZONES DE MARCA.SLDASM
PUNZONES DE MARCA-SUPRAJIT SMV-011
PUNZONES DE MARCA-SUPRAJIT SMV-015
PUNZONES DE MARCA-SUPRAJIT SMV-007
PUNZONES DE MARCA-SUPRAJIT SMV-016
PUNZONES DE MARCA-SUPRAJIT SMV-020
PUNZONES DE MARCA-SUPRAJIT SMV-021
PUNZONES DE MARCA-SUPRAJIT SMV-025
PUNZONES DE MARCA-SUPRAJIT SMV-028
PUNZONES DE MARCA-SUPRAJIT SMV-027
PUNZONES DE MARCA-SUPRAJIT SMV-026
PUNZONES DE MARCA-SUPRAJIT SMV-024
PUNZONES DE MARCA-SUPRAJIT SMV-023
PUNZONES DE MARCA-SUPRAJIT SMV-022
PUNZONES DE MARCA-SUPRAJIT SMV-019
PUNZONES DE MARCA-SUPRAJIT SMV-018
PUNZONES DE MARCA-SUPRAJIT SMV-017
PUNZONES DE MARCA-SUPRAJIT SMV-006
PUNZONES DE MARCA-SUPRAJIT SMV-010
PUNZONES DE MARCA-SUPRAJIT SMV-009
PUNZONES DE MARCA-SUPRAJIT SMV-008
PUNZONES DE MARCA-SUPRAJIT SMV-013
PUNZONES DE MARCA-SUPRAJIT SMV-004
PUNZONES DE MARCA-SUPRAJIT SMV-003
