jemiliano2001-blip/SMV-VISION/TOOL CRIB/PUNZONES-DE-MARCA_HOT-STAMPS/PUNZONES DE MARCA/PUNZO DE MARCA -LETRAS -.SLDASM

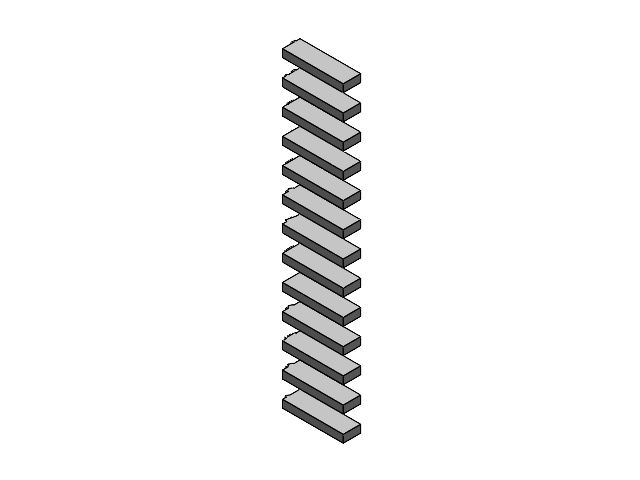
[picture p75: CAD file, 2026-05-04]
TOOL CRIB/PUNZONES-DE-MARCA_HOT-STAMPS/PUNZONES DE MARCA/PUNZO DE MARCA -LETRAS -.SLDASM
PUNZONES DE MARCA-SUPRAJIT SMV-016
PUNZONES DE MARCA-SUPRAJIT SMV-020
PUNZONES DE MARCA-SUPRAJIT SMV-021
PUNZONES DE MARCA-SUPRAJIT SMV-025
PUNZONES DE MARCA-SUPRAJIT SMV-028
PUNZONES DE MARCA-SUPRAJIT SMV-027
PUNZONES DE MARCA-SUPRAJIT SMV-026
PUNZONES DE MARCA-SUPRAJIT SMV-024
PUNZONES DE MARCA-SUPRAJIT SMV-023
PUNZONES DE MARCA-SUPRAJIT SMV-022
PUNZONES DE MARCA-SUPRAJIT SMV-019
PUNZONES DE MARCA-SUPRAJIT SMV-018
PUNZONES DE MARCA-SUPRAJIT SMV-017
