jemiliano2001-blip/SMV-VISION/(list of files, cad)

Other CAD files:
TOOL CRIB/BLOCKS/SWAGE-BLOCK/BLOCK-UT2035RB.SLDPRT
TOOL CRIB/NAVAJAS-SEGUNDO-CORTE/90-1012-06_NAVAJAS-SEGUNDO-CORTE/90-1012-06.SLDPRT
TOOL CRIB/PUNZONES-DE-MARCA_HOT-STAMPS/PUNZONES DE MARCA/PUNZONES DE MARCA-SUPRAJIT SMV-004.SLDPRT
TOOL CRIB/UT2001/ORIGINAL NO TOCAR/UT2001.SLDPRT
TOOL CRIB/UT2033/UT2033.SLDPRT
TOOL CRIB/WCD03-1797/WCD03-1797/WCD03-1797-02.SLDPRT
TOOL CRIB/WCD16-1452/WCD16-1452-02.SLDPRT
TOOL CRIB/NAVAJAS-SEGUNDO-CORTE/90-1012-06_NAVAJAS-SEGUNDO-CORTE/90-1012-06-2.SLDPRT
TOOL CRIB/PUNZONES-DE-MARCA_HOT-STAMPS/PUNZONES DE MARCA-SUPRAJIT SMV-005.SLDPRT
TOOL CRIB/PUNZONES-DE-MARCA_HOT-STAMPS/PUNZONES DE MARCA/PUNZONES DE MARCA-SUPRAJIT SMV-011.SLDPRT
TOOL CRIB/WCD03-1797/WCD03-1797/WCD03-1797-08.SLDPRT
TOOL CRIB/WCD16-1452/WCD16-1452-01.SLDPRT
TOOL CRIB/_SIN-CLASIFICAR/90-4516/90-4516-05/90-4516-XX SUPRAJIT-003.SLDPRT
TOOL CRIB/PUNZONES-DE-MARCA_HOT-STAMPS/PUNZONES DE MARCA-SUPRAJIT SMV-004.SLDPRT
TOOL CRIB/PUNZONES-DE-MARCA_HOT-STAMPS/PUNZONES DE MARCA/PUNZONES DE MARCA-SUPRAJIT SMV-012.SLDPRT
TOOL CRIB/WCD/WCD01-573-101/WCD 01-573-103.SLDPRT
TOOL CRIB/WCD03-1797/WCD03-1797/WCD03-1797-09.SLDPRT
TOOL CRIB/WCD16-1452/WCD16-1452-05.SLDPRT
TOOL CRIB/PUNZONES-DE-MARCA_HOT-STAMPS/PUNZONES DE MARCA-SUPRAJIT SMV-009.SLDPRT
TOOL CRIB/PUNZONES-DE-MARCA_HOT-STAMPS/PUNZONES DE MARCA/PUNZONES DE MARCA-SUPRAJIT SMV-032.SLDPRT
TOOL CRIB/UT2001/UT2001-082.SLDPRT
TOOL CRIB/WCD03-1797/WCD03-1797/WCD03-1797-06.SLDPRT
TOOL CRIB/_SIN-CLASIFICAR/90-4516/90-4516-05/90-4516-XX SUPRAJIT-004.SLDPRT
TOOL CRIB/PUNZONES-DE-MARCA_HOT-STAMPS/PUNZONES DE MARCA-SUPRAJIT SMV-007.SLDPRT
TOOL CRIB/UT2001/UT2001-061.SLDPRT
TOOL CRIB/WCD03-1797/WCD03-1797/WCD03-1797-03.SLDPRT
TOOL CRIB/PUNZONES-DE-MARCA_HOT-STAMPS/PUNZONES DE MARCA-SUPRAJIT SMV-010.SLDPRT
TOOL CRIB/PUNZONES-DE-MARCA_HOT-STAMPS/PUNZONES DE MARCA/PUNZONES DE MARCA-SUPRAJIT SMV-025.SLDPRT
TOOL CRIB/UT2001/UT2001-123.SLDPRT
TOOL CRIB/PUNZONES-DE-MARCA_HOT-STAMPS/PUNZONES DE MARCA-SUPRAJIT SMV-002.SLDPRT
TOOL CRIB/PUNZONES-DE-MARCA_HOT-STAMPS/PUNZONES DE MARCA/PUNZONES DE MARCA-SUPRAJIT SMV-022.SLDPRT
TOOL CRIB/UT2001/UT2001-125.SLDPRT
TOOL CRIB/PUNZONES-DE-MARCA_HOT-STAMPS/PUNZONES DE MARCA/PUNZONES DE MARCA-SUPRAJIT SMV-021.SLDPRT
TOOL CRIB/UT2001/UT2001-124.SLDPRT
TOOL CRIB/PUNZONES-DE-MARCA_HOT-STAMPS/PUNZONES DE MARCA-SUPRAJIT SMV-006.SLDPRT
TOOL CRIB/PUNZONES-DE-MARCA_HOT-STAMPS/PUNZONES DE MARCA/PUNZONES DE MARCA-SUPRAJIT SMV-031.SLDPRT
TOOL CRIB/PUNZONES-DE-MARCA_HOT-STAMPS/PUNZONES DE MARCA-SUPRAJIT SMV-016.SLDPRT
TOOL CRIB/PUNZONES-DE-MARCA_HOT-STAMPS/PUNZONES DE MARCA/PUNZONES DE MARCA-SUPRAJIT SMV-013.SLDPRT
TOOL CRIB/PUNZONES-DE-MARCA_HOT-STAMPS/PUNZONES DE MARCA-SUPRAJIT SMV-011.SLDPRT
TOOL CRIB/PUNZONES-DE-MARCA_HOT-STAMPS/PUNZONES DE MARCA/PUNZONES DE MARCA-SUPRAJIT SMV-019.SLDPRT
TOOL CRIB/PUNZONES-DE-MARCA_HOT-STAMPS/PUNZONES DE MARCA-SUPRAJIT SMV-008.SLDPRT
TOOL CRIB/PUNZONES-DE-MARCA_HOT-STAMPS/PUNZONES DE MARCA-SUPRAJIT SMV-001.SLDPRT
TOOL CRIB/PUNZONES-DE-MARCA_HOT-STAMPS/PUNZONES DE MARCA/PUNZONES DE MARCA-SUPRAJIT SMV-029.SLDPRT
TOOL CRIB/PUNZONES-DE-MARCA_HOT-STAMPS/PUNZONES DE MARCA/PUNZONES DE MARCA-SUPRAJIT SMV-007.SLDPRT
TOOL CRIB/PUNZONES-DE-MARCA_HOT-STAMPS/PUNZONES DE MARCA/PUNZONES DE MARCA-SUPRAJIT SMV-008.SLDPRT
TOOL CRIB/PUNZONES-DE-MARCA_HOT-STAMPS/PUNZONES DE MARCA/PUNZONES DE MARCA-SUPRAJIT SMV-028.SLDPRT
TOOL CRIB/PUNZONES-DE-MARCA_HOT-STAMPS/PUNZONES DE MARCA/PUNZONES DE MARCA-SUPRAJIT SMV-015.SLDPRT
TOOL CRIB/PUNZONES-DE-MARCA_HOT-STAMPS/PUNZONES DE MARCA/PUNZONES DE MARCA-SUPRAJIT SMV-016.SLDPRT
TOOL CRIB/PUNZONES-DE-MARCA_HOT-STAMPS/PUNZONES DE MARCA/PUNZONES DE MARCA-SUPRAJIT SMV-030.SLDPRT
TOOL CRIB/PUNZONES-DE-MARCA_HOT-STAMPS/PUNZONES DE MARCA/PUNZONES DE MARCA-SUPRAJIT SMV-027.SLDPRT
TOOL CRIB/PUNZONES-DE-MARCA_HOT-STAMPS/PUNZONES DE MARCA/PUNZONES DE MARCA-SUPRAJIT SMV-006.SLDPRT
TOOL CRIB/PUNZONES-DE-MARCA_HOT-STAMPS/PUNZONES DE MARCA/PUNZONES DE MARCA-SUPRAJIT SMV-001.SLDPRT
TOOL CRIB/PUNZONES-DE-MARCA_HOT-STAMPS/PUNZONES DE MARCA/PUNZONES DE MARCA-SUPRAJIT SMV-026.SLDPRT
TOOL CRIB/PUNZONES-DE-MARCA_HOT-STAMPS/PUNZONES DE MARCA/PUNZONES DE MARCA-SUPRAJIT SMV-003.SLDPRT
TOOL CRIB/PUNZONES-DE-MARCA_HOT-STAMPS/PUNZONES DE MARCA/PUNZONES DE MARCA-SUPRAJIT SMV-018.SLDPRT
TOOL CRIB/PUNZONES-DE-MARCA_HOT-STAMPS/PUNZONES DE MARCA/PUNZONES DE MARCA-SUPRAJIT SMV-023.SLDPRT
TOOL CRIB/PUNZONES-DE-MARCA_HOT-STAMPS/PUNZONES DE MARCA/PUNZONES DE MARCA-SUPRAJIT SMV-009.SLDPRT
TOOL CRIB/PUNZONES-DE-MARCA_HOT-STAMPS/PUNZONES DE MARCA/PUNZONES DE MARCA-SUPRAJIT SMV-005.SLDPRT
TOOL CRIB/PUNZONES-DE-MARCA_HOT-STAMPS/PUNZONES DE MARCA/PUNZONES DE MARCA-SUPRAJIT SMV-024.SLDPRT
TOOL CRIB/PUNZONES-DE-MARCA_HOT-STAMPS/PUNZONES DE MARCA/PUNZONES DE MARCA-SUPRAJIT SMV-017.SLDPRT
TOOL CRIB/PUNZONES-DE-MARCA_HOT-STAMPS/PUNZONES DE MARCA/PUNZONES DE MARCA-SUPRAJIT SMV-010.SLDPRT
TOOL CRIB/PUNZONES-DE-MARCA_HOT-STAMPS/PUNZONES DE MARCA/PUNZONES DE MARCA-SUPRAJIT SMV-002.SLDPRT
TOOL CRIB - copia/BLOCKS/BLOCK-1135-2/block 1135-2.SLDDRW
TOOL CRIB - copia/BLOCKS/SWAGE-BLOCK/BLOCK-UT2035RB.SLDDRW
TOOL CRIB - copia/BLOCKS/SWAGE-BLOCK/BLOCK-UT2035RB.SLDPRT
TOOL CRIB - copia/BLOCKS/SWAGE-BLOCK/PIN UT BLOCKS.SLDDRW
TOOL CRIB - copia/BLOCKS/T-8762_BLOCK/BLOCK T-8762.SLDDRW
TOOL CRIB - copia/NAVAJAS-SEGUNDO-CORTE/90-1012-05_Rev3_NAVAJAS-SEGUNDO-CORTE/90-1012-05-001.SLDDRW
TOOL CRIB - copia/NAVAJAS-SEGUNDO-CORTE/90-1012-05_Rev3_NAVAJAS-SEGUNDO-CORTE/90-1012-05.SLDDRW
TOOL CRIB - copia/NAVAJAS-SEGUNDO-CORTE/90-1012-06_NAVAJAS-SEGUNDO-CORTE/90-1012-06-2.SLDDRW
TOOL CRIB - copia/NAVAJAS-SEGUNDO-CORTE/90-1012-06_NAVAJAS-SEGUNDO-CORTE/90-1012-06-2.SLDPRT
TOOL CRIB - copia/NAVAJAS-SEGUNDO-CORTE/90-1012-06_NAVAJAS-SEGUNDO-CORTE/90-1012-06.SLDDRW
TOOL CRIB - copia/NAVAJAS-SEGUNDO-CORTE/90-1012-06_NAVAJAS-SEGUNDO-CORTE/90-1012-06.SLDPRT
TOOL CRIB - copia/NAVAJAS-SEGUNDO-CORTE/90-4150-06_NAVAJAS-SEGUNDO-CORTE/90-4150-06 -A MOD 24-01-2025.SLDDRW
TOOL CRIB - copia/NAVAJAS-SEGUNDO-CORTE/90-4150-06_NAVAJAS-SEGUNDO-CORTE/90-4150-06 -B MOD 24-01-2025.SLDDRW
TOOL CRIB - copia/NAVAJAS-SEGUNDO-CORTE/90-4150-06_NAVAJAS-SEGUNDO-CORTE/OLD/90-4150-06 -A.SLDDRW
TOOL CRIB - copia/NAVAJAS-SEGUNDO-CORTE/90-4150-06_NAVAJAS-SEGUNDO-CORTE/OLD/90-4150-06 -A.SLDPRT
TOOL CRIB - copia/NAVAJAS-SEGUNDO-CORTE/90-4150-06_NAVAJAS-SEGUNDO-CORTE/OLD/90-4150-06 -B.SLDDRW
TOOL CRIB - copia/NAVAJAS-SEGUNDO-CORTE/90-4150-06_NAVAJAS-SEGUNDO-CORTE/OLD/90-4150-06 -B.SLDPRT
TOOL CRIB - copia/NAVAJAS-SEGUNDO-CORTE/90-4150-06_NAVAJAS-SEGUNDO-CORTE/piezas.SLDDRW
TOOL CRIB - copia/PUNZONES-DE-MARCA_HOT-STAMPS/PUNZONES DE MARCA-SUPRAJIT SMV-001.SLDDRW
TOOL CRIB - copia/PUNZONES-DE-MARCA_HOT-STAMPS/PUNZONES DE MARCA-SUPRAJIT SMV-001.SLDPRT
TOOL CRIB - copia/PUNZONES-DE-MARCA_HOT-STAMPS/PUNZONES DE MARCA-SUPRAJIT SMV-002.SLDDRW
TOOL CRIB - copia/PUNZONES-DE-MARCA_HOT-STAMPS/PUNZONES DE MARCA-SUPRAJIT SMV-002.SLDPRT
TOOL CRIB - copia/PUNZONES-DE-MARCA_HOT-STAMPS/PUNZONES DE MARCA-SUPRAJIT SMV-004.SLDPRT
TOOL CRIB - copia/PUNZONES-DE-MARCA_HOT-STAMPS/PUNZONES DE MARCA-SUPRAJIT SMV-005.SLDPRT
TOOL CRIB - copia/PUNZONES-DE-MARCA_HOT-STAMPS/PUNZONES DE MARCA-SUPRAJIT SMV-006.SLDPRT
TOOL CRIB - copia/PUNZONES-DE-MARCA_HOT-STAMPS/PUNZONES DE MARCA-SUPRAJIT SMV-007.SLDPRT
TOOL CRIB - copia/PUNZONES-DE-MARCA_HOT-STAMPS/PUNZONES DE MARCA-SUPRAJIT SMV-008.SLDPRT
TOOL CRIB - copia/PUNZONES-DE-MARCA_HOT-STAMPS/PUNZONES DE MARCA-SUPRAJIT SMV-009.SLDPRT
TOOL CRIB - copia/PUNZONES-DE-MARCA_HOT-STAMPS/PUNZONES DE MARCA-SUPRAJIT SMV-010.SLDPRT
TOOL CRIB - copia/PUNZONES-DE-MARCA_HOT-STAMPS/PUNZONES DE MARCA-SUPRAJIT SMV-011.SLDPRT
TOOL CRIB - copia/PUNZONES-DE-MARCA_HOT-STAMPS/PUNZONES DE MARCA-SUPRAJIT SMV-016.SLDPRT
TOOL CRIB - copia/PUNZONES-DE-MARCA_HOT-STAMPS/PUNZONES DE MARCA.SLDDRW
TOOL CRIB - copia/PUNZONES-DE-MARCA_HOT-STAMPS/PUNZONES DE MARCA/PUNZO DE MARCA -LETRAS -.SLDDRW
TOOL CRIB - copia/PUNZONES-DE-MARCA_HOT-STAMPS/PUNZONES DE MARCA/PUNZONES DE MARCA-SUPRAJIT SMV-001.SLDDRW
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
