jemiliano2001-blip/SMV-VISION/TOOL CRIB/UT2001/UT2001-041.pdf

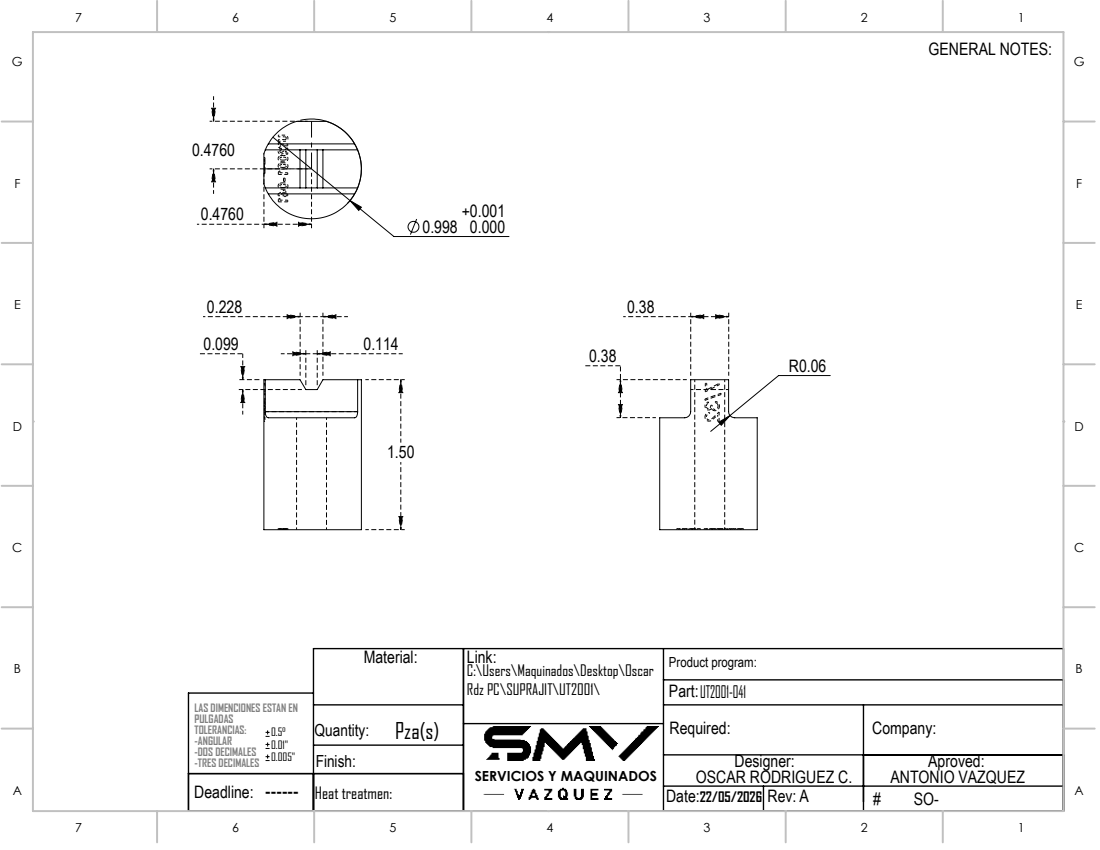
[picture p77: page 1]
Product program:; SERVICIOS Y MAQUINADOS; GENERAL NOTES:

Link:
C:\Users\Maquinados\Desktop\Oscar
Rdz PC\SUPRAJIT\UT2001\
Pza(s)

LAS DIMENCIONES ESTAN EN
PULGADAS
TOLERANCIAS:
-ANGULAR
-DOS DECIMALES
-TRES DECIMALES

Designer: OSCAR RODRIGUEZ C. | Aproved: ANTONIO VAZQUEZ

22/05/2026 Date: | A Rev: | # SO-

Deadline: ------ | Heat treatmen:
