jemiliano2001-blip/SMV-VISION/TOOL CRIB/SCREW-GOLDEN_CUTTING-BLADE-PORTUGUESA/SCREW GOLDEN FOR CUTTING BLADE.pdf

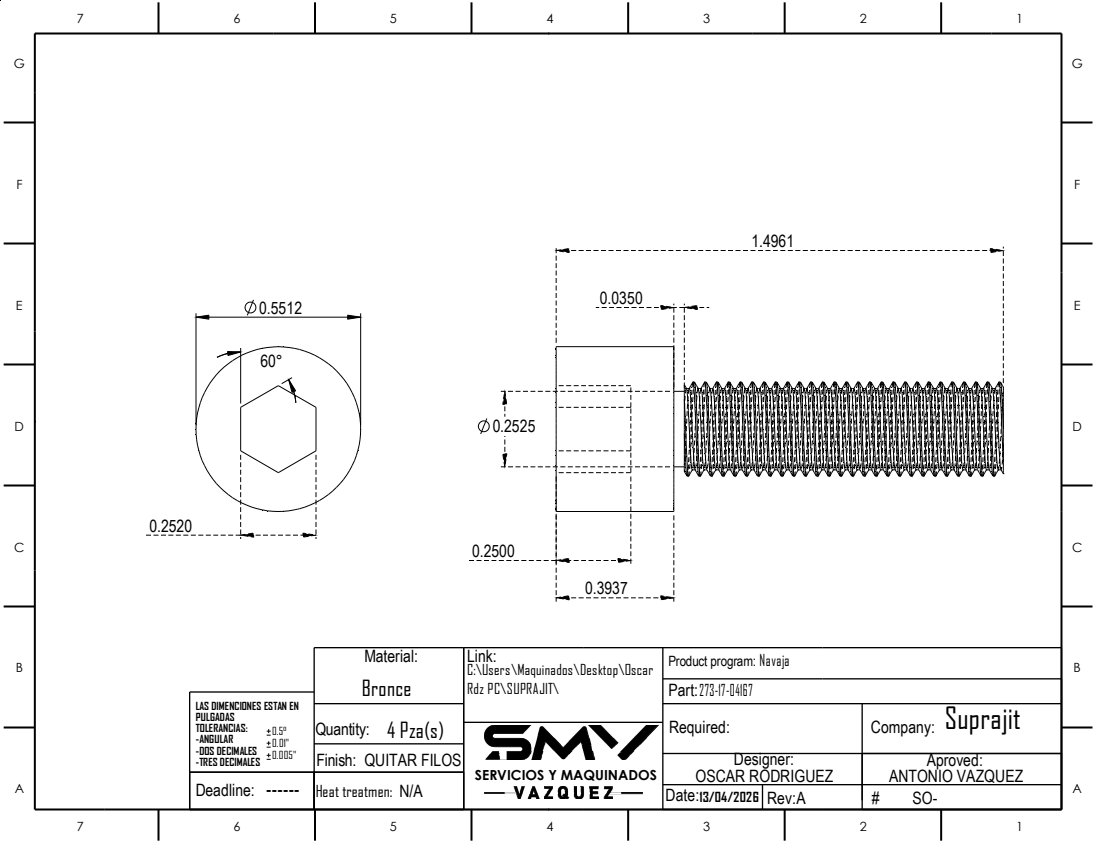
[picture p79: page 1]
QUITAR FILOS; Material:; Required:; Part:; Company:; Product program:; Suprajit; Finish:; Quantity:; Navaja; 4 Pza(s); Bronce; SERVICIOS Y MAQUINADOS

Link:
C:\Users\Maquinados\Desktop\Oscar
Rdz PC\SUPRAJIT\

LAS DIMENCIONES ESTAN EN
PULGADAS
TOLERANCIAS:
-ANGULAR
-DOS DECIMALES
-TRES DECIMALES

Designer: OSCAR RODRIGUEZ | Aproved: ANTONIO VAZQUEZ

Deadline: ------ | Heat treatmen:

Date: 13/04/2026 | Rev: A | # SO- N/A
