jemiliano2001-blip/SMV-VISION/TOOL CRIB/_SIN-CLASIFICAR/90-5317_Rev2_BLADE-PIN/90-5317Rev2.pdf

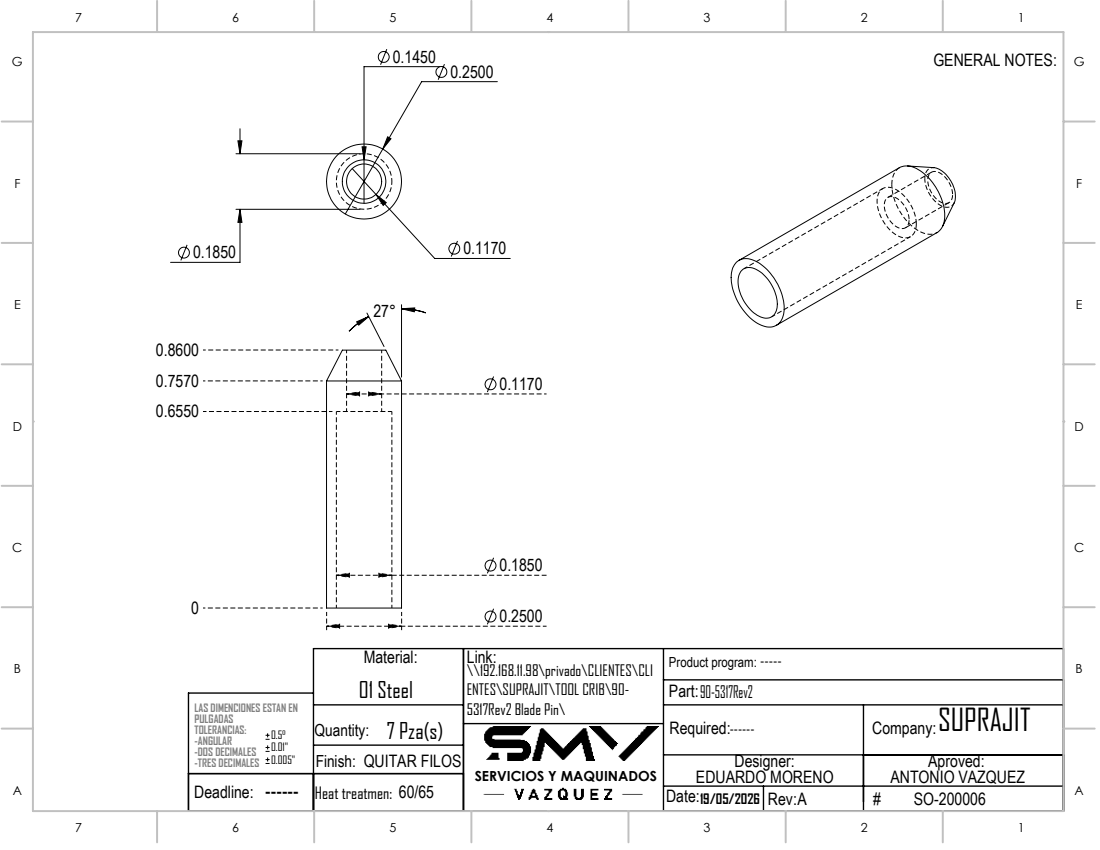
[picture p80: page 1]
Product program:; SERVICIOS Y MAQUINADOS; GENERAL NOTES:; O1 Steel; QUITAR FILOS; 7 Pza(s)

Link:
\\192.168.11.98\privado\CLIENTES\CLI
ENTES\SUPRAJIT\TOOL CRIB\90-
5317Rev2 Blade Pin\

LAS DIMENCIONES ESTAN EN
PULGADAS
TOLERANCIAS:
-ANGULAR
-DOS DECIMALES
-TRES DECIMALES

Designer: EDUARDO MORENO | Aproved: ANTONIO VAZQUEZ

19/05/2026 Date: | A Rev: | # SO-200006

Deadline: ------ | 60/65 Heat treatmen:
