jemiliano2001-blip/SMV-VISION/TOOL CRIB/_SIN-CLASIFICAR/90-5492_90-5493/90-5492rev1.pdf

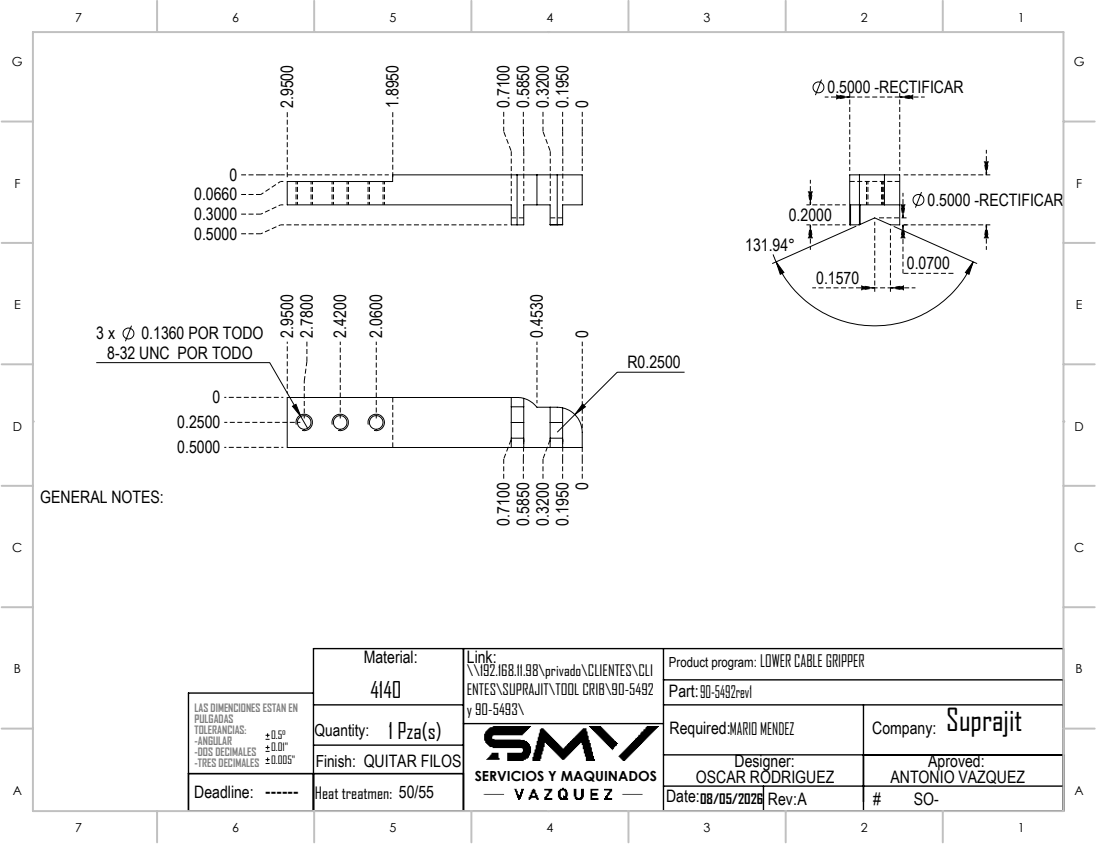
[picture p81: page 1]
0.5000 -RECTIFICAR; Product program:; SERVICIOS Y MAQUINADOS; GENERAL NOTES:; MARIO MENDEZ

3 x 0.1360 POR TODO
8-32 UNC POR TODO

Link:
\\192.168.11.98\privado\CLIENTES\CLI
ENTES\SUPRAJIT\TOOL CRIB\90-5492
1 Pza(s)
QUITAR FILOS
Finish:

LOWER CABLE GRIPPER

LAS DIMENCIONES ESTAN EN
PULGADAS
TOLERANCIAS:
-ANGULAR
-DOS DECIMALES
-TRES DECIMALES

Designer: OSCAR RODRIGUEZ | Aproved: ANTONIO VAZQUEZ

08/05/2026 Date: | A Rev: | # SO-

Deadline: ------ | 50/55 Heat treatmen:
