jemiliano2001-blip/SMV-VISION/TOOL CRIB/WCD/WCD101-308-1_CUTTER-BLOCK-NAVAJAS/CUTTER-BLOCK-NAVAJAS.pdf

0.2490 ⁰ ⁰.1170 0.1245 0.1320 0.2490

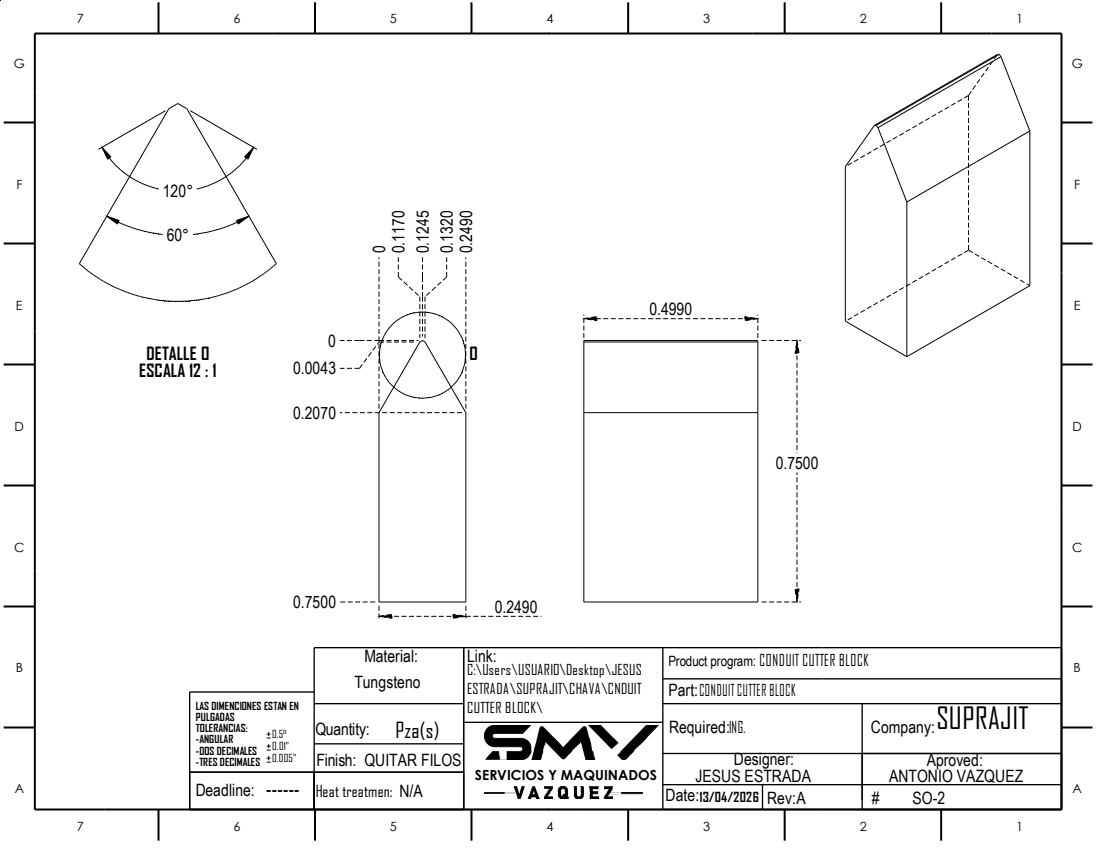
[picture p82: page 1]
QUITAR FILOS; Material:; Company:; SUPRAJIT; Finish:; Quantity:; Pza(s); SERVICIOS Y MAQUINADOS; ING.; Tungsteno; ESCALA 12 : 1; DETALLE O

Link:
C:\Users\USUARIO\Desktop\JESUS
ESTRADA\SUPRAJIT\CHAVA\CNDUIT
CUTTER BLOCK\

Product program:
Part:
CONDUIT CUTTER BLOCK
Required:

LAS DIMENCIONES ESTAN EN
PULGADAS
TOLERANCIAS:
-ANGULAR
-DOS DECIMALES
-TRES DECIMALES

Designer: JESUS ESTRADA | Aproved: ANTONIO VAZQUEZ

Deadline: ------ | Heat treatmen:

Date: 13/04/2026 | Rev: A | # SO-2 N/A
