jemiliano2001-blip/SMV-VISION/TOOL CRIB/_SIN-CLASIFICAR/14259-63-20-93/14259-63-20-93.pdf

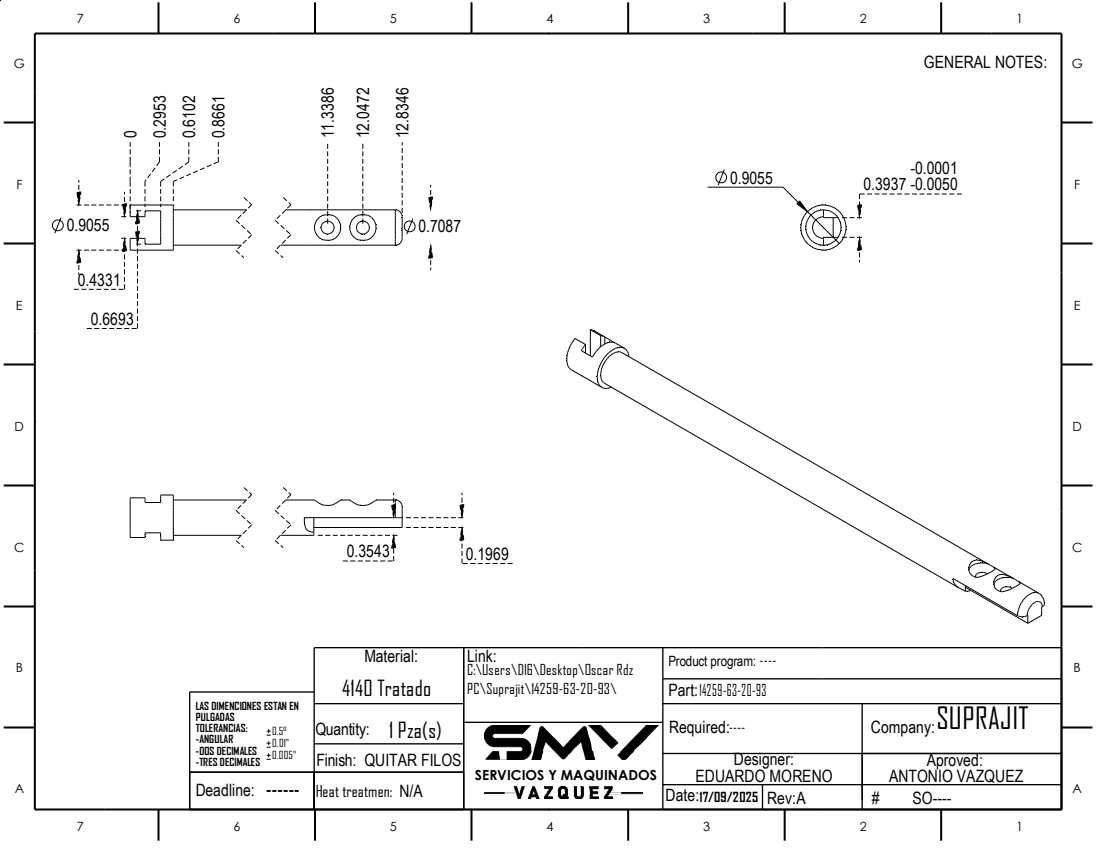
[picture p83: page 1]
QUITAR FILOS; GENERAL NOTES:; Material:; Required:; Link:; Part:; Company:; Product program:; SUPRAJIT; Finish:; Quantity:; 1 Pza(s); 4140 Tratado; SERVICIOS Y MAQUINADOS; PC\Suprajit\14259-63-20-93\; C:\Users\DI6\Desktop\Oscar Rdz

LAS DIMENCIONES ESTAN EN
PULGADAS
TOLERANCIAS:
-ANGULAR
-DOS DECIMALES
-TRES DECIMALES

Designer: EDUARDO MORENO | Aproved: ANTONIO VAZQUEZ

Deadline: ------ | Heat treatmen:

Date: 17/09/2025 | Rev: A | # SO---- N/A
