jemiliano2001-blip/SMV-VISION/TOOL CRIB/_SIN-CLASIFICAR/90-3262_Rev4_UPSET-CONDUIT-CLAMP/upset-conduit-clamp.pdf

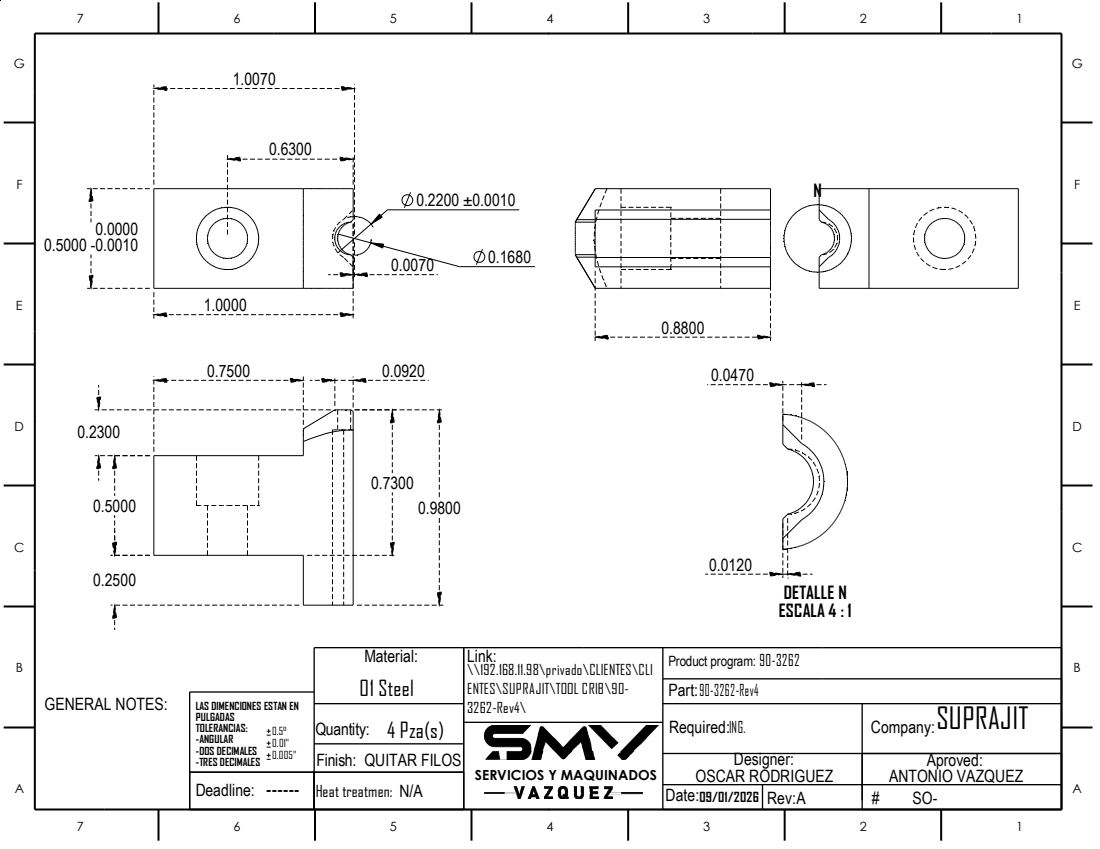
[picture p84: page 1]
QUITAR FILOS; GENERAL NOTES:; Material:; Required:; Part:; Company:; 90-3262-Rev4; Product program:; SUPRAJIT; Finish:; Quantity:; 4 Pza(s); O1 Steel; SERVICIOS Y MAQUINADOS; ING.; ESCALA 4 : 1; DETALLE N

Link:
\\192.168.11.98\privado\CLIENTES\CLI
ENTES\SUPRAJIT\TOOL CRIB\90-
3262-Rev4\

LAS DIMENCIONES ESTAN EN
PULGADAS
TOLERANCIAS:
-ANGULAR
-DOS DECIMALES
-TRES DECIMALES

Designer: OSCAR RODRIGUEZ | Aproved: ANTONIO VAZQUEZ

Deadline: ------ | Heat treatmen:

Date: 09/01/2026 | Rev: A | # SO- N/A
