jemiliano2001-blip/SMV-VISION/TOOL CRIB/_SIN-CLASIFICAR/90-3342_PIN-STRIPPER/pin stripper 90-3342.pdf

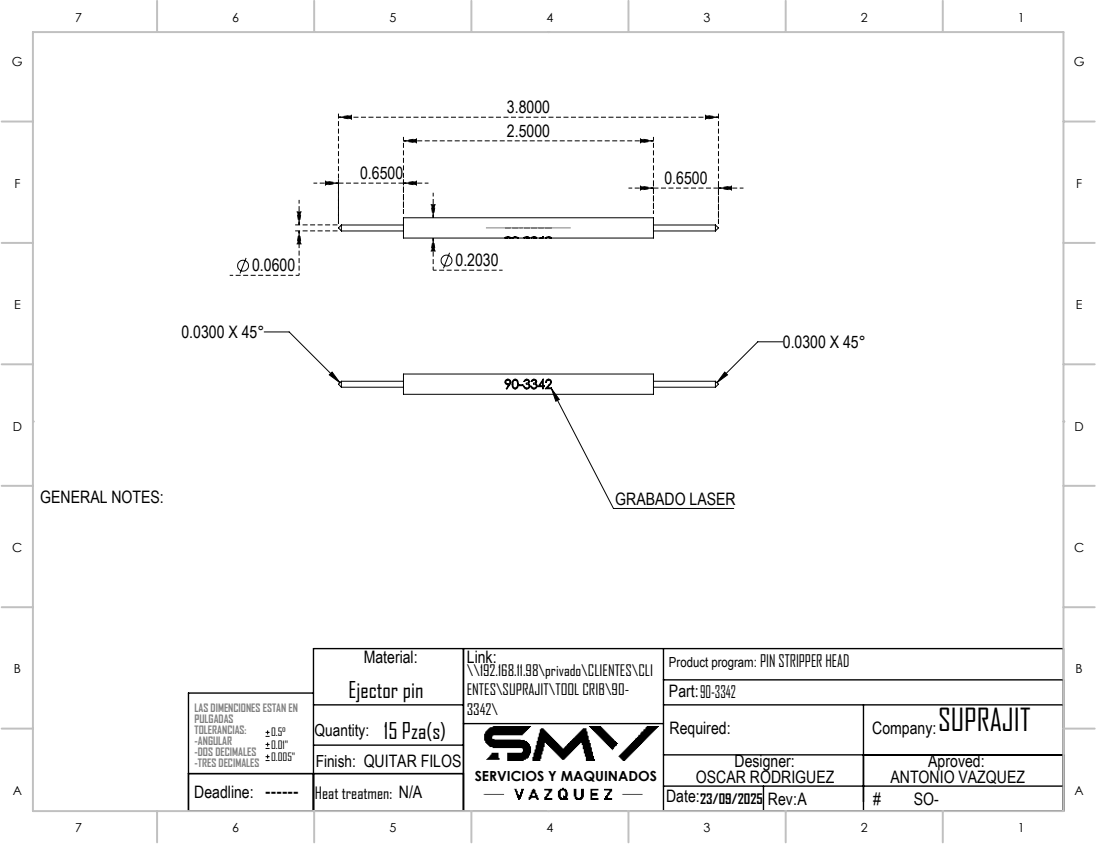
[picture p85: page 1]
GRABADO LASER; Product program:; SERVICIOS Y MAQUINADOS; GENERAL NOTES:; Ejector pin; QUITAR FILOS; 15 Pza(s)

Link:
\\192.168.11.98\privado\CLIENTES\CLI
ENTES\SUPRAJIT\TOOL CRIB\90-

PIN STRIPPER HEAD

LAS DIMENCIONES ESTAN EN
PULGADAS
TOLERANCIAS:
-ANGULAR
-DOS DECIMALES
-TRES DECIMALES

Designer: OSCAR RODRIGUEZ | Aproved: ANTONIO VAZQUEZ

23/09/2025 Date: | A Rev: | # SO-

Deadline: ------ | N/A Heat treatmen:
