jemiliano2001-blip/SMV-VISION/TOOL CRIB/BLOCKS/SWAGE-BLOCK/Block UT2033.pdf

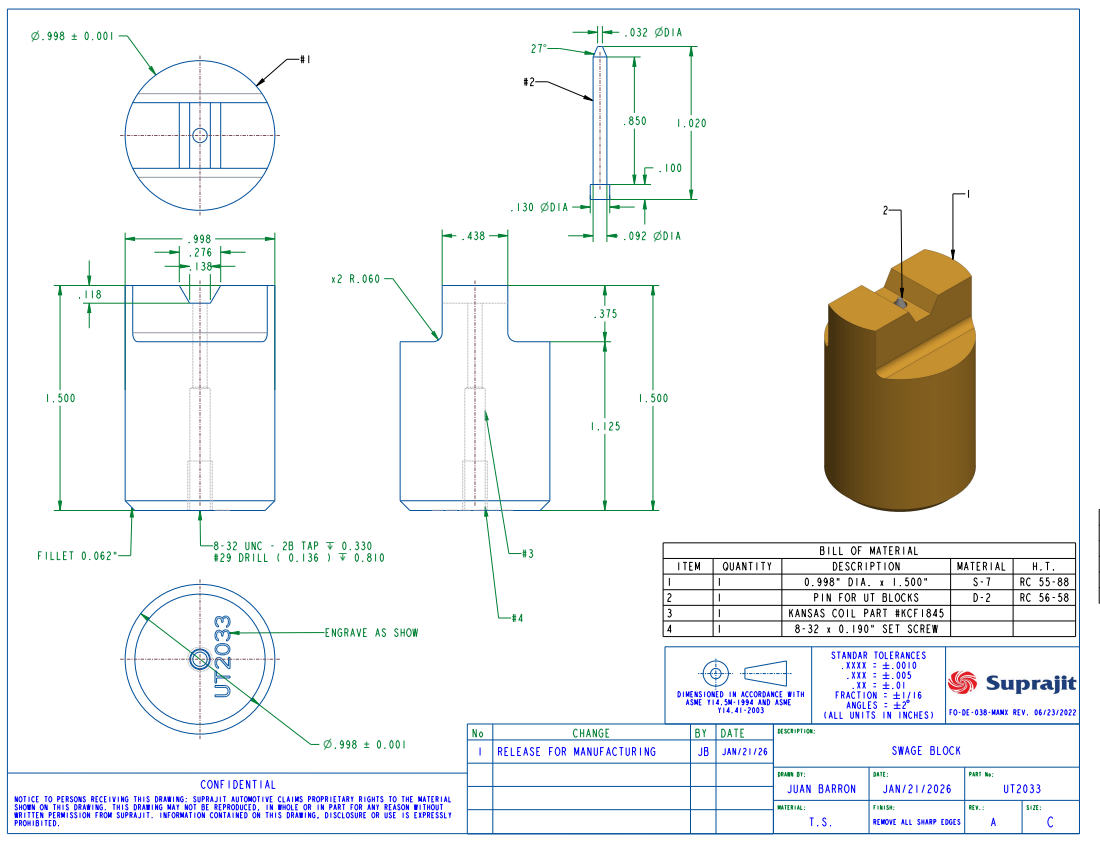
[picture p86: page 1]
.130 ⌀DIA; .032 ⌀DIA; .092 ⌀DIA; KANSAS COIL PART #KCF1845; 8-32 x 0.190" SET SCREW; 8-32 UNC - 2B TAP ↧ 0.330; FILLET 0.062"; #29 DRILL ( 0.136 ) ↧ 0.810; ENGRAVE; AS SHOW; NOTICE; TO PERSONS RECEIVING THIS DRAWING: SUPRAJIT; AUTOMOTIVE; CLAIMS PROPRIETARY RIGHTS TO THE; MATERIAL; SHOWN ON THIS DRAWING. THIS DRAWING MAY NOT; BE REPRODUCED, IN WHOLE; OR IN PART; FOR ANY REASON WITHOUT; WRITTEN PERMISSION FROM SUPRAJIT . INFORMATION CONTAINED ON THIS DRAWING, DISCLOSURE; OR USE; EXPRESSLY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

BILL OF MATERIAL

1 | | 1 | | 0.998" DIA. x 1.500" | S-7 | RC 55-88
2 | 1 | | PIN FOR UT BLOCKS | | | | D-2 | RC 56-58

STANDAR TOLERANCES (ALL UNITS IN INCHES)

ASME Y14.5M-1994 AND ASME

FO-DE-038-MAMX REV. 06/23/2022

DESCRIPTION: SWAGE BLOCK

DRAWN BY: JUAN BARRON | DATE: JAN/21/2026 | PART No: UT2033

T.S. | REMOVE ALL SHARP EDGES | A | C
