jemiliano2001-blip/SMV-VISION/TOOL CRIB/BLOCKS/SWAGE-BLOCK/PIN UT BLOCKS.pdf

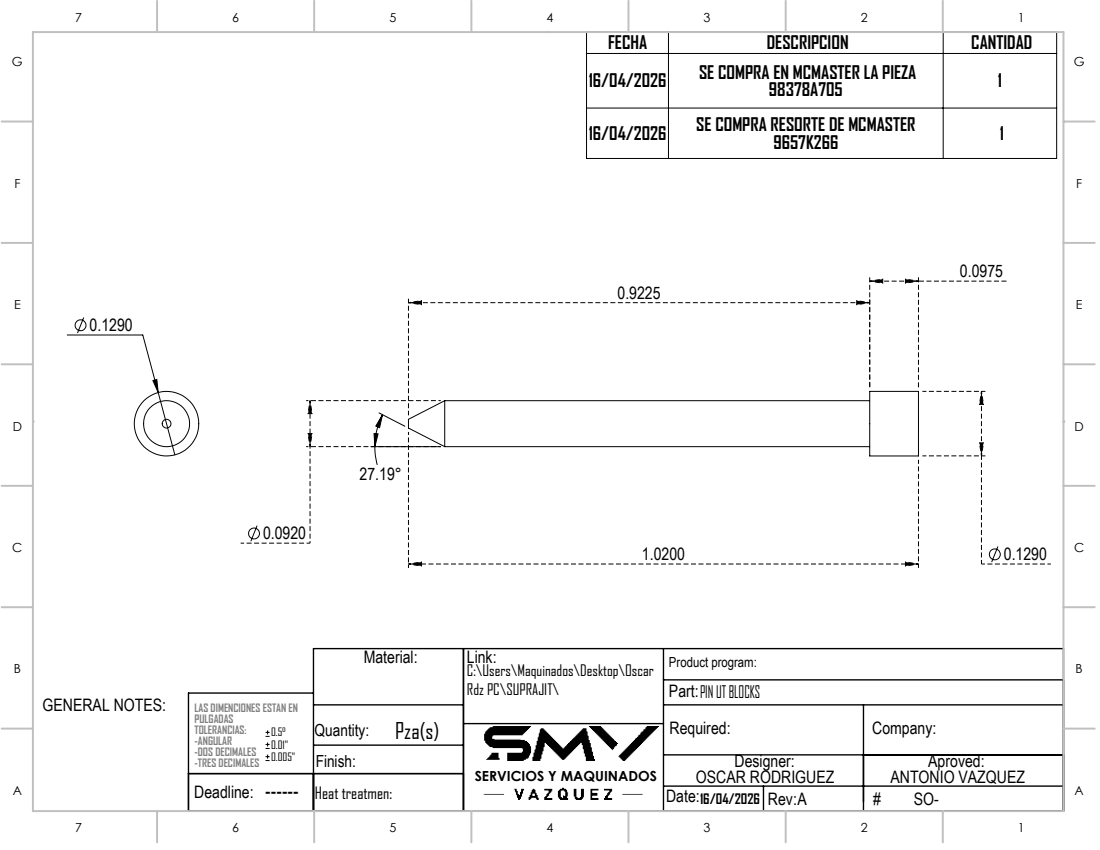
[picture p87: page 1]
SERVICIOS Y MAQUINADOS; GENERAL NOTES:

FECHA | DESCRIPCION | CANTIDAD
16/04/2026 | SE COMPRA EN MCMASTER LA PIEZA 98378A705 | 1

16/04/2026 | SE COMPRA RESORTE DE MCMASTER 9657K266 | 1

Link:
C:\Users\Maquinados\Desktop\Oscar
Rdz PC\SUPRAJIT\
Pza(s)

Product program:
Part:
PIN UT BLOCKS
Required:

LAS DIMENCIONES ESTAN EN
PULGADAS
TOLERANCIAS:
-ANGULAR
-DOS DECIMALES
-TRES DECIMALES

Designer: OSCAR RODRIGUEZ | Aproved: ANTONIO VAZQUEZ

16/04/2026 Date: | A Rev: | # SO-

Deadline: ------ | Heat treatmen:
