jemiliano2001-blip/SMV-VISION/TOOL CRIB/BLOCKS/SWAGE-BLOCK/UT2000TABrB.pdf

2

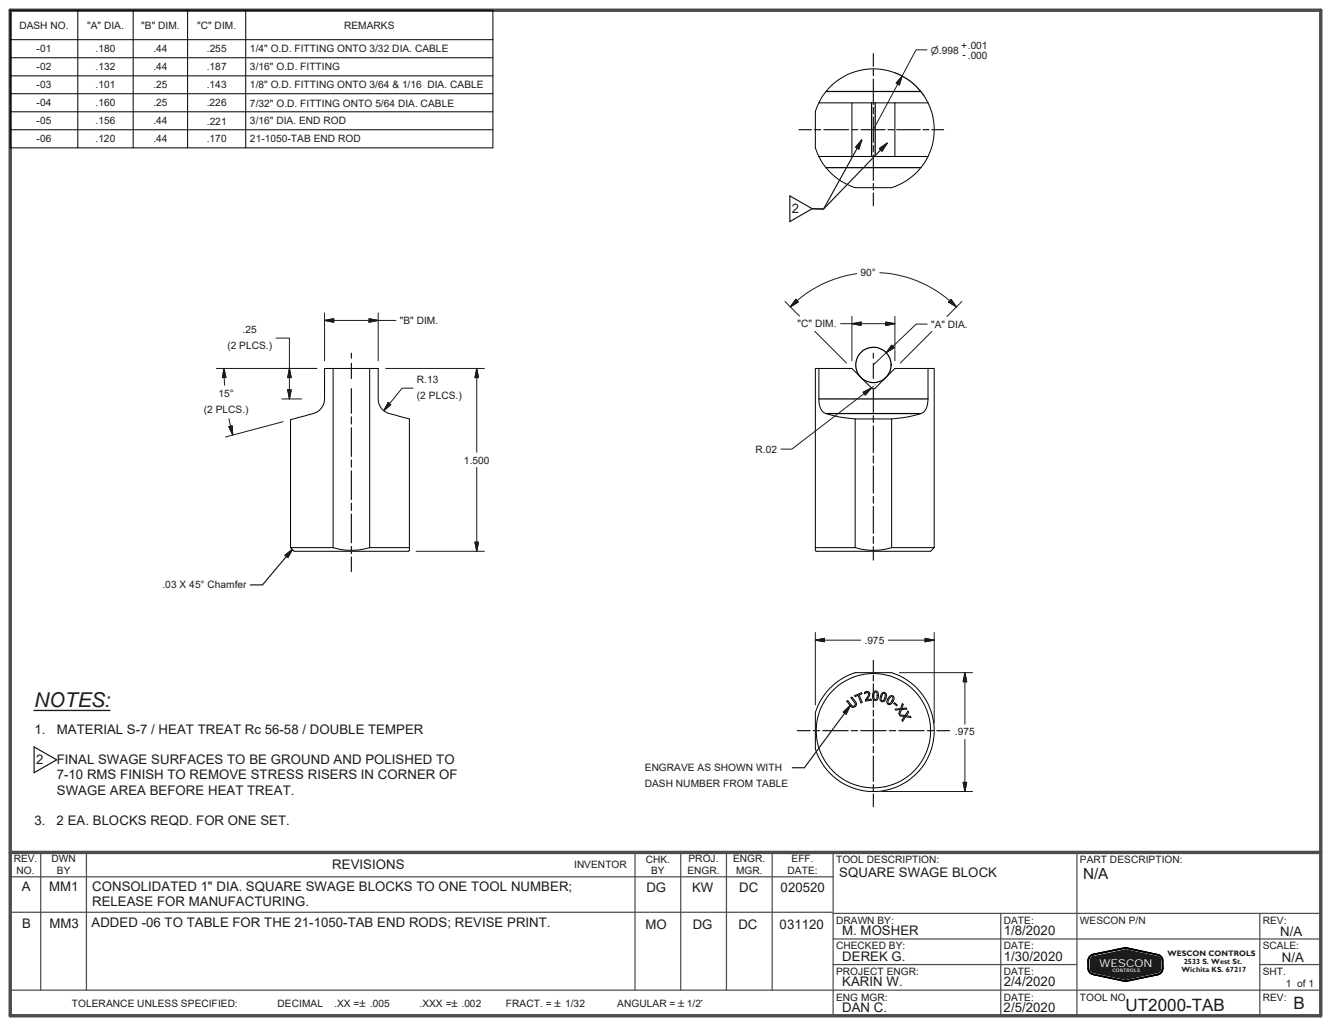
[picture p88: page 1]
WESCON; 2533 S. West St. Wichita KS. 67217; "B" DIM.; .25 (2 PLCS.); 15° (2 PLCS.); R.13 (2 PLCS.); NOTES:; "A" DIA.; "C" DIM.; .03 X 45° Chamfer

DASH NO. | "A" DIA. | "B" DIM. | "C" DIM. | REMARKS

-01 | .180 | .44 | .255 | 1/4" O.D. FITTING ONTO 3/32 DIA. CABLE
-02 | .132 | .44 | .187 | 3/16" O.D. FITTING
-03 | .101 | .25 | .143 | 1/8" O.D. FITTING ONTO 3/64 & 1/16 DIA. CABLE
-04 | .160 | .25 | .226 | 7/32" O.D. FITTING ONTO 5/64 DIA. CABLE
-05 | .156 | .44 | .221 | 3/16" DIA. END ROD
-06 | .120 | .44 | .170 | 21-1050-TAB END ROD

1. MATERIAL S-7 / HEAT TREAT Rc 56-58 / DOUBLE TEMPER

FINAL SWAGE SURFACES TO BE GROUND AND POLISHED TO
7-10 RMS FINISH TO REMOVE STRESS RISERS IN CORNER OF
SWAGE AREA BEFORE HEAT TREAT.

ENGRAVE AS SHOWN WITH
DASH NUMBER FROM TABLE

3. 2 EA. BLOCKS REQD. FOR ONE SET.

REV. NO. | DWN BY | REVISIONS INVENTOR | CHK. BY | PROJ. ENGR. | ENGR. MGR. | EFF. DATE: | TOOL DESCRIPTION: SQUARE SWAGE BLOCK | PART DESCRIPTION: N/A
A | MM1 | CONSOLIDATED 1" DIA. SQUARE SWAGE BLOCKS TO ONE TOOL NUMBER; RELEASE FOR MANUFACTURING. | DG | KW | DC | 020520

B | MM3 | ADDED -06 TO TABLE FOR THE 21-1050-TAB END RODS; REVISE PRINT. | MO | DG | DC | 031120 | DRAWN BY: M. MOSHER | DATE: 1/8/2020 | WESCON P/N | REV: N/A

CHECKED BY: DEREK G. | DATE: 1/30/2020 | WESCON CONTROLS CONTROLS | SCALE: N/A

PROJECT ENGR: KARIN W. | DATE: 2/4/2020 | | SHT.

TOLERANCE UNLESS SPECIFIED: DECIMAL .XX = .005 .XXX = .002 FRACT. = 1/32 ANGULAR = 1/2 | | | | | | | ENG MGR: DAN C. | DATE: 2/5/2020 | TOOL NO. UT2000-TAB | REV: B
