jemiliano2001-blip/SMV-VISION/TOOL CRIB/BLOCKS/SWAGE-BLOCK/UT2001rH.pdf

A

1

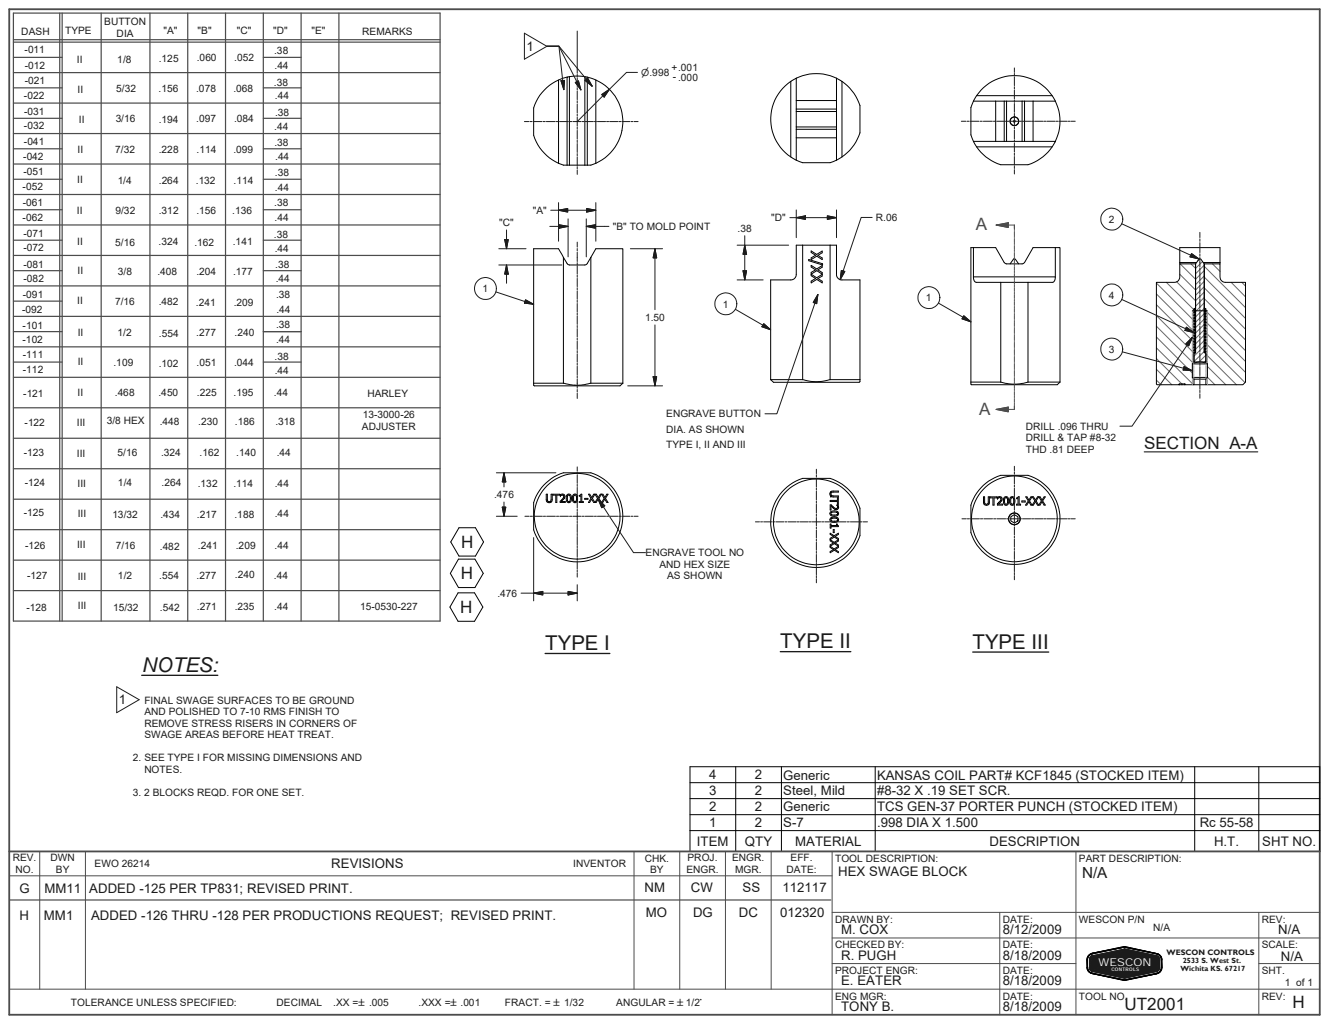
[picture p89: page 1]
SECTION A-A; WESCON; 2533 S. West St. Wichita KS. 67217; TYPE I; TYPE II; TYPE III; DRILL .096 THRU DRILL & TAP #8-32 THD .81 DEEP; NOTES:

DASH | TYPE | BUTTON DIA | "A" | "B" | "C" | "D" | "E" | REMARKS

-011 | II | 1/8 | .125 | .060 | .052 | .38
-012 | | | | | | .44

-021 | II | 5/32 | .156 | .078 | .068 | .38
-022 | | | | | | .44
-031 | II | 3/16 | .194 | .097 | .084 | .38
-032 | | | | | | .44

-041 | II | 7/32 | .228 | .114 | .099 | .38
-042 | | | | | | .44

-051 | II | 1/4 | .264 | .132 | .114 | .38
-052 | | | | | | .44

-061 | II | 9/32 | .312 | .156 | .136 | .38
-062 | | | | | | .44

-071 | II | 5/16 | .324 | .162 | .141 | .38
-072 | | | | | | .44

"B" TO MOLD POINT

-081 | II | 3/8 | .408 | .204 | .177 | .38
-082 | | | | | | .44

-101 | II | 1/2 | .554 | .277 | .240 | .38
-102 | | | | | | .44

-111 | II | .109 | .102 | .051 | .044 | .38
-112 | | | | | | .44

-121 | II | .468 | .450 | .225 | .195 | .44 | HARLEY

-122 | III | 3/8 HEX | .448 | .230 | .186 | .318 | 13-3000-26 ADJUSTER

ENGRAVE BUTTON
DIA. AS SHOWN
TYPE I, II AND III

-123 | III | 5/16 | .324 | .162 | .140 | .44

-124 | III | 1/4 | .264 | .132 | .114 | .44

-125 | III | 13/32 | .434 | .217 | .188 | .44

-126 | III | 7/16 | .482 | .241 | .209 | .44

ENGRAVE TOOL NO
AND HEX SIZE
AS SHOWN

-127 | III | 1/2 | .554 | .277 | .240 | .44

-128 | III | 15/32 | .542 | .271 | .235 | .44 | 15-0530-227

FINAL SWAGE SURFACES TO BE GROUND
AND POLISHED TO 7-10 RMS FINISH TO
REMOVE STRESS RISERS IN CORNERS OF
SWAGE AREAS BEFORE HEAT TREAT.

2. SEE TYPE I FOR MISSING DIMENSIONS AND
NOTES.

4 | 2 | Generic | KANSAS COIL PART# KCF1845 (STOCKED ITEM)
3 | 2 | Steel, Mild | #8-32 X .19 SET SCR.
2 | 2 | Generic | TCS GEN-37 PORTER PUNCH (STOCKED ITEM)
1 | 2 | S-7 | .998 DIA X 1.500 | Rc 55-58
ITEM | QTY | MATERIAL | DESCRIPTION | H.T. | SHT NO.

3. 2 BLOCKS REQD. FOR ONE SET.

REV. NO. | DWN BY | EWO 26214 REVISIONS INVENTOR | CHK. BY | PROJ. ENGR. | ENGR. MGR. | EFF. DATE: | TOOL DESCRIPTION: HEX SWAGE BLOCK | PART DESCRIPTION: N/A

G | MM11 | ADDED -125 PER TP831; REVISED PRINT. | NM | CW | SS | 112117
H | MM1 | ADDED -126 THRU -128 PER PRODUCTIONS REQUEST; REVISED PRINT. | MO | DG | DC | 012320

DRAWN BY: M. COX | DATE: 8/12/2009 | WESCON P/N N/A | REV: N/A

CHECKED BY: R. PUGH | DATE: 8/18/2009 | WESCON CONTROLS CONTROLS | SCALE: N/A

PROJECT ENGR: E. EATER | DATE: 8/18/2009 | | SHT.

TOLERANCE UNLESS SPECIFIED: DECIMAL .XX = .005 .XXX = .001 FRACT. = 1/32 ANGULAR = 1/2 | ENG MGR: TONY B. | DATE: 8/18/2009 | TOOL NO. UT2001 | REV: H
