jemiliano2001-blip/SMV-VISION/TOOL CRIB/BLOCKS/SWAGE-BLOCK/WCD161452TABrC.pdf

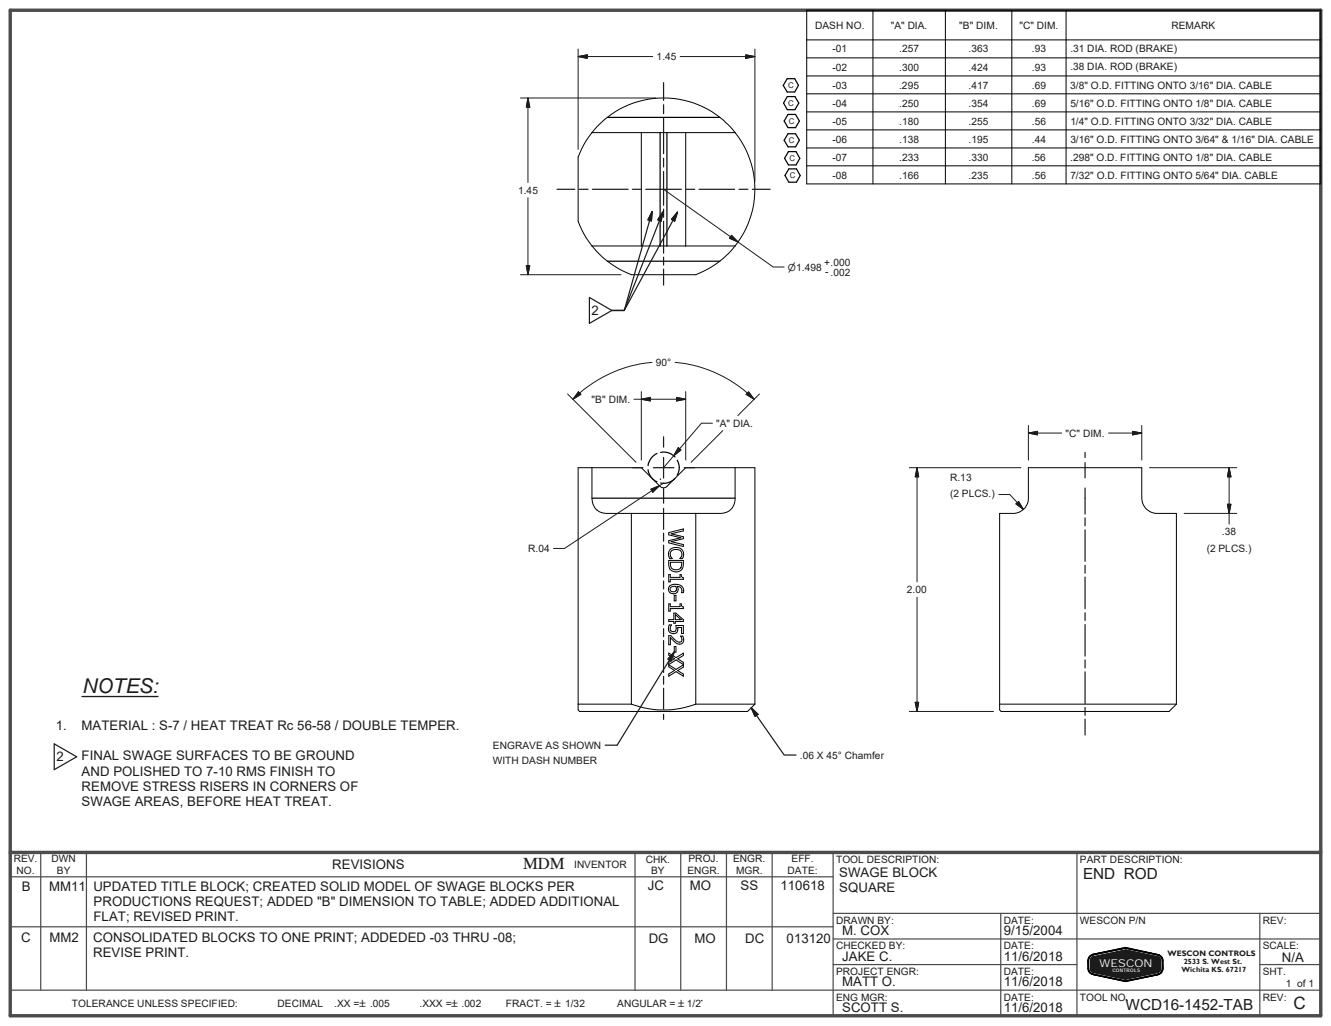
[picture p90: page 1]
WESCON; 2533 S. West St. Wichita KS. 67217; NOTES:; "A" DIA.; "B" DIM.; "C" DIM.; .38 (2 PLCS.); R.13 (2 PLCS.); .06 X 45° Chamfer

DASH NO. | "A" DIA. | "B" DIM. | "C" DIM. | REMARK

-01 | .257 | .363 | .93 | .31 DIA. ROD (BRAKE)
-02 | .300 | .424 | .93 | .38 DIA. ROD (BRAKE)
-03 | .295 | .417 | .69 | 3/8" O.D. FITTING ONTO 3/16" DIA. CABLE
-04 | .250 | .354 | .69 | 5/16" O.D. FITTING ONTO 1/8" DIA. CABLE
-05 | .180 | .255 | .56 | 1/4" O.D. FITTING ONTO 3/32" DIA. CABLE
-06 | .138 | .195 | .44 | 3/16" O.D. FITTING ONTO 3/64" & 1/16" DIA. CABLE
-07 | .233 | .330 | .56 | .298" O.D. FITTING ONTO 1/8" DIA. CABLE
-08 | .166 | .235 | .56 | 7/32" O.D. FITTING ONTO 5/64" DIA. CABLE

1. MATERIAL : S-7 / HEAT TREAT Rc 56-58 / DOUBLE TEMPER.

ENGRAVE AS SHOWN
WITH DASH NUMBER

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

REV. NO. | DWN BY | MDM REVISIONS INVENTOR | CHK. BY | PROJ. ENGR. | ENGR. MGR. | EFF. DATE: | TOOL DESCRIPTION: SWAGE BLOCK SQUARE | PART DESCRIPTION: END ROD
B | MM11 | UPDATED TITLE BLOCK; CREATED SOLID MODEL OF SWAGE BLOCKS PER PRODUCTIONS REQUEST; ADDED "B" DIMENSION TO TABLE; ADDED ADDITIONAL FLAT; REVISED PRINT. | JC | MO | SS | 110618

DRAWN BY: M. COX | DATE: 9/15/2004 | WESCON P/N | REV:

C | MM2 | CONSOLIDATED BLOCKS TO ONE PRINT; ADDEDED -03 THRU -08; REVISE PRINT. | DG | MO | DC | 013120

CHECKED BY: JAKE C. | DATE: 11/6/2018 | WESCON CONTROLS CONTROLS | SCALE: N/A

PROJECT ENGR: MATT O. | DATE: 11/6/2018 | | SHT.

TOLERANCE UNLESS SPECIFIED: DECIMAL .XX = .005 .XXX = .002 FRACT. = 1/32 ANGULAR = 1/2 | ENG MGR: SCOTT S. | DATE: 11/6/2018 | TOOL NO. WCD16-1452-TAB | REV: C
