jemiliano2001-blip/SMV-VISION/TOOL CRIB/BLOCKS/T-8762_BLOCK/BLOCK T-8762.pdf

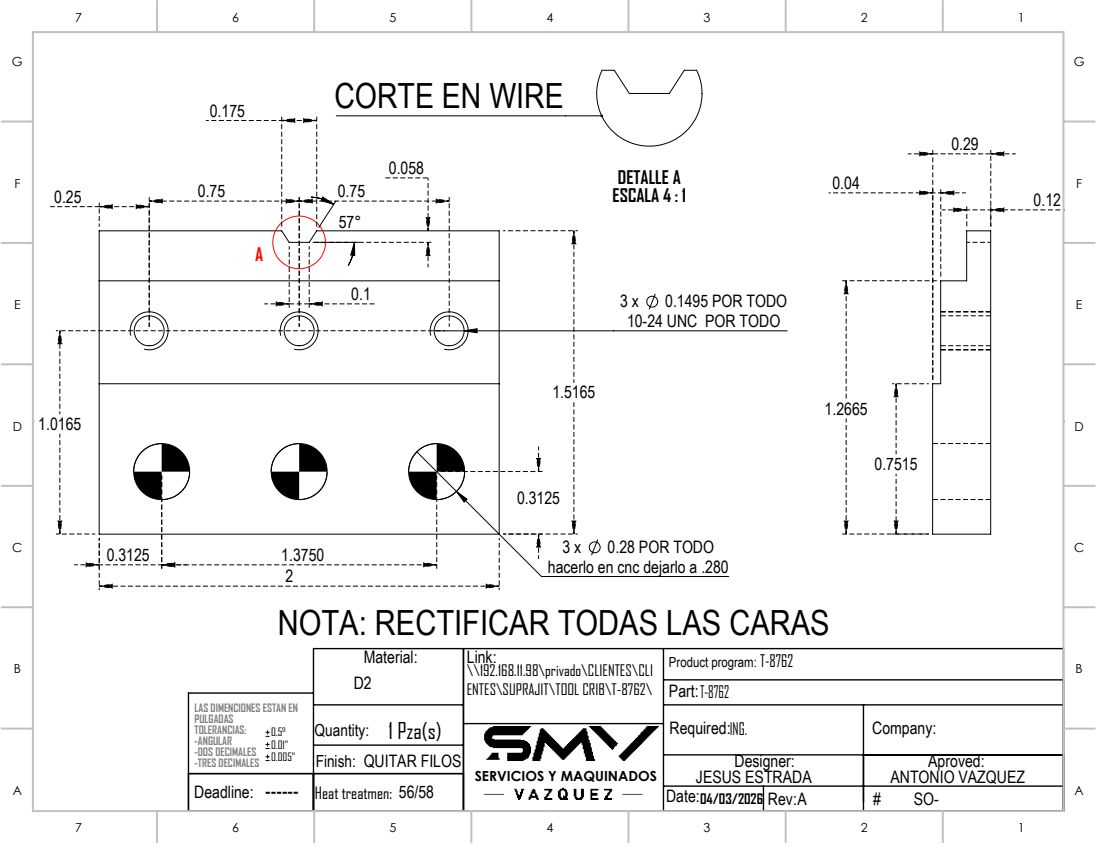
[picture p91: page 1]
DETALLE A ESCALA 4 : 1; Product program:; SERVICIOS Y MAQUINADOS

CORTE EN WIRE

3 x 0.1495 POR TODO
10-24 UNC POR TODO

3 x 0.28 POR TODO
hacerlo en cnc dejarlo a .280

NOTA: RECTIFICAR TODAS LAS CARAS

Link:
\\192.168.11.98\privado\CLIENTES\CLI
ENTES\SUPRAJIT\TOOL CRIB\T-8762\
1 Pza(s)
QUITAR FILOS
Finish:

LAS DIMENCIONES ESTAN EN
PULGADAS
TOLERANCIAS:
-ANGULAR
-DOS DECIMALES
-TRES DECIMALES

Designer: JESUS ESTRADA | Aproved: ANTONIO VAZQUEZ

04/03/2026 Date: | A Rev: | # SO-

Deadline: ------ | 56/58 Heat treatmen:
