jemiliano2001-blip/SMV-VISION/TOOL CRIB/GRIPPERS/90-4584-03_GRIPPER-26113/90-4584-03 - 26113 gripper assy R2-2.pdf

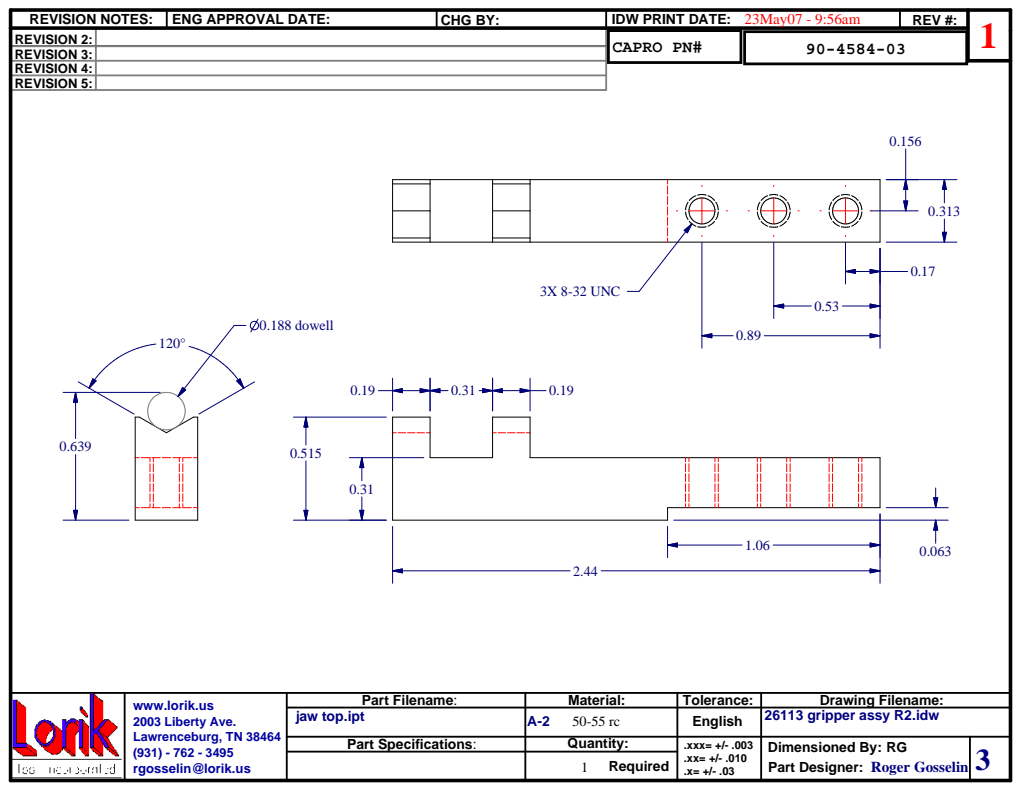
[picture p92: page 1]
0.188 dowell; 3X 8-32 UNC

REVISION NOTES: | ENG APPROVAL DATE: | CHG BY: | IDW PRINT DATE: 23May07 - 9:56am | REV #: | 1
REVISION 2: | | 0.156
REVISION 3:
REVISION 4:
REVISION 5:

www.lorik.us 2003 Liberty Ave. Lawrenceburg, TN 38464 (931) - 762 - 3495 rgosselin@lorik.us | Part Filename: | Material: | Tolerance: | Drawing Filename:

jaw top.ipt | A-2 50-55 rc | English | 26113 gripper assy R2.idw

Part Specifications: | Quantity: | .xxx= +/- .003 .xx= +/- .010 .x= +/- .03 | Dimensioned By: RG Roger Gosselin Part Designer: | 3

Required 1
