jemiliano2001-blip/SMV-VISION/TOOL CRIB/NAVAJAS-SEGUNDO-CORTE/90-1012-05_Rev3_NAVAJAS-SEGUNDO-CORTE/1012-05-chico.pdf

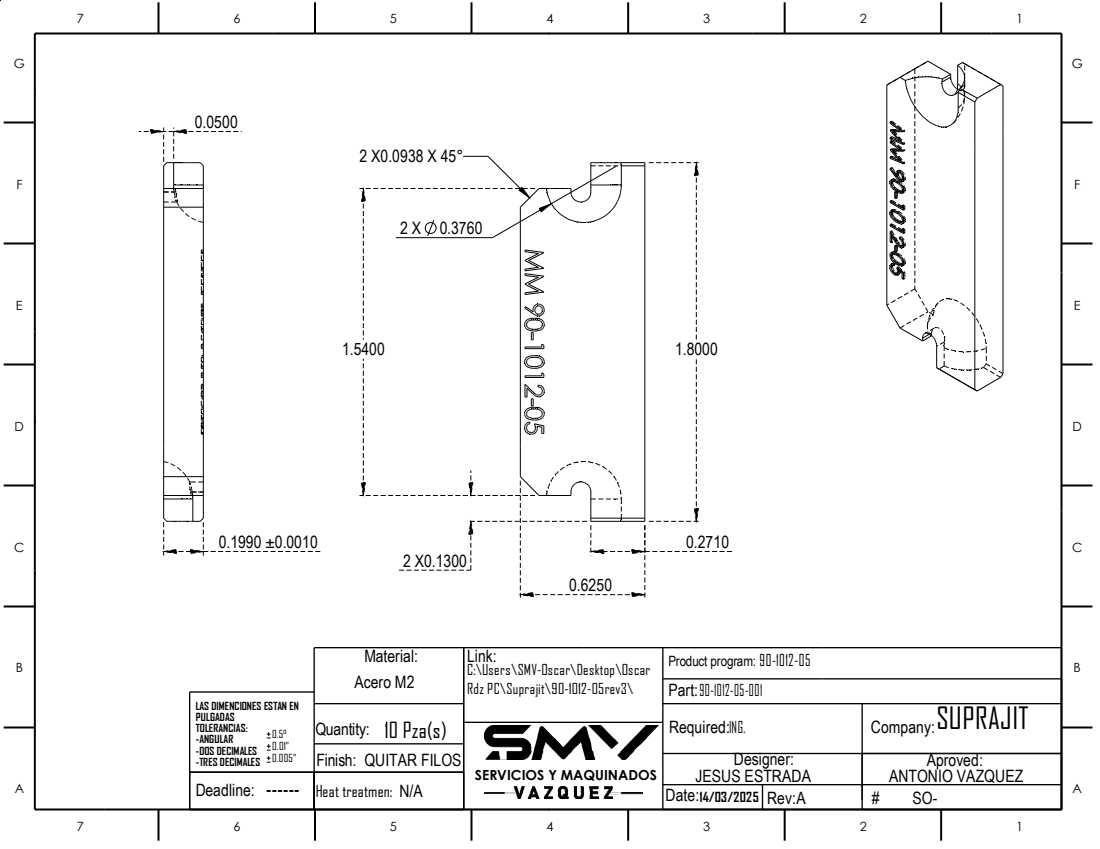
[picture p93: page 1]
QUITAR FILOS; Material:; Required:; Part:; Company:; Product program:; SUPRAJIT; Finish:; Quantity:; 10 Pza(s); SERVICIOS Y MAQUINADOS; ING.; Acero M2

Link:
C:\Users\SMV-Oscar\Desktop\Oscar
Rdz PC\Suprajit\90-1012-05rev3\

LAS DIMENCIONES ESTAN EN
PULGADAS
TOLERANCIAS:
-ANGULAR
-DOS DECIMALES
-TRES DECIMALES

Designer: JESUS ESTRADA | Aproved: ANTONIO VAZQUEZ

Deadline: ------ | Heat treatmen:

Date: 14/03/2025 | Rev: A | # SO- N/A
