jemiliano2001-blip/SMV-VISION/TOOL CRIB/NAVAJAS-SEGUNDO-CORTE/90-4150-06_NAVAJAS-SEGUNDO-CORTE/4150-06-corto.pdf

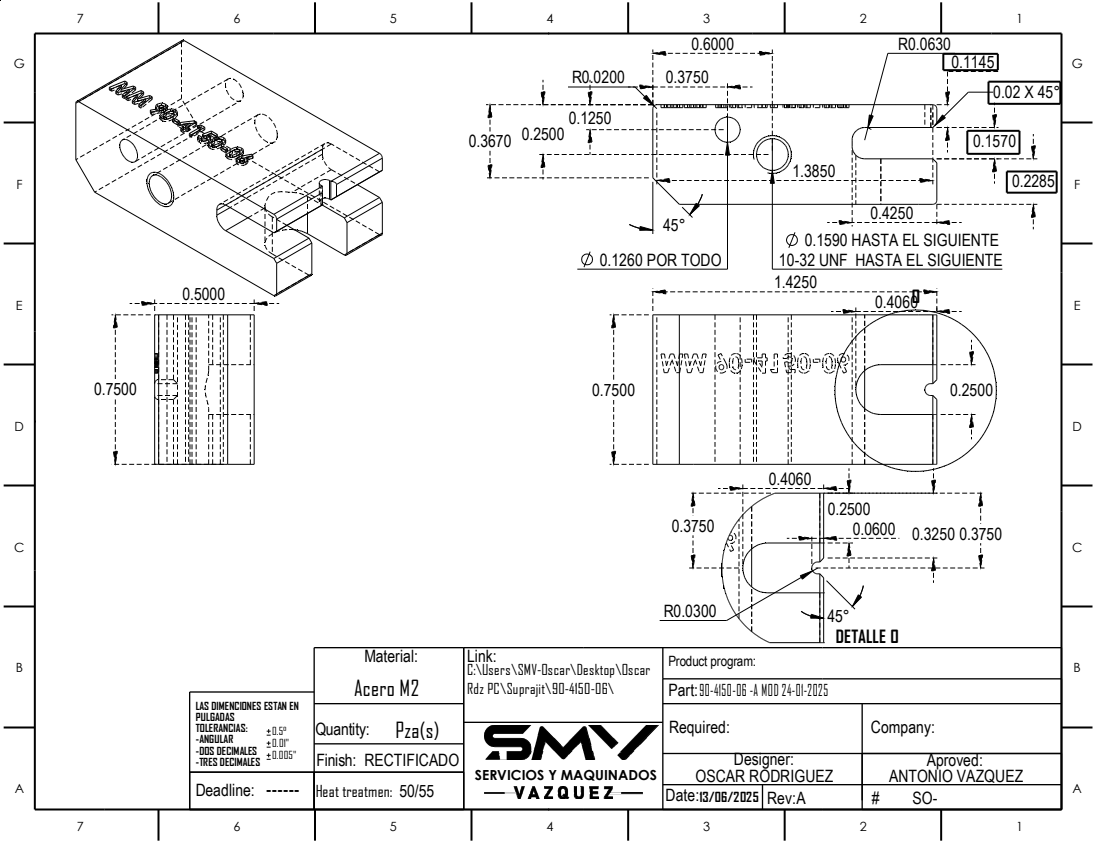
[picture p94: page 1]
RECTIFICADO; Material:; Required:; Part:; Company:; 90-4150-06 -A MOD 24-01-2025; Product program:; Finish:; Quantity:; Pza(s); Acero M2; SERVICIOS Y MAQUINADOS; 0.1260 POR TODO; 10-32 UNF HASTA EL SIGUIENTE; DETALLE O

0.1590 HASTA EL SIGUIENTE

Link:
C:\Users\SMV-Oscar\Desktop\Oscar
Rdz PC\Suprajit\90-4150-06\

LAS DIMENCIONES ESTAN EN
PULGADAS
TOLERANCIAS:
-ANGULAR
-DOS DECIMALES
-TRES DECIMALES

Designer: OSCAR RODRIGUEZ | Aproved: ANTONIO VAZQUEZ

Deadline: ------ | Heat treatmen:

Date: 13/06/2025 | Rev: A | # SO- 50/55
