jemiliano2001-blip/SMV-VISION/TOOL CRIB/NAVAJAS-SEGUNDO-CORTE/90-4150-06_NAVAJAS-SEGUNDO-CORTE/4150-06-largo.pdf

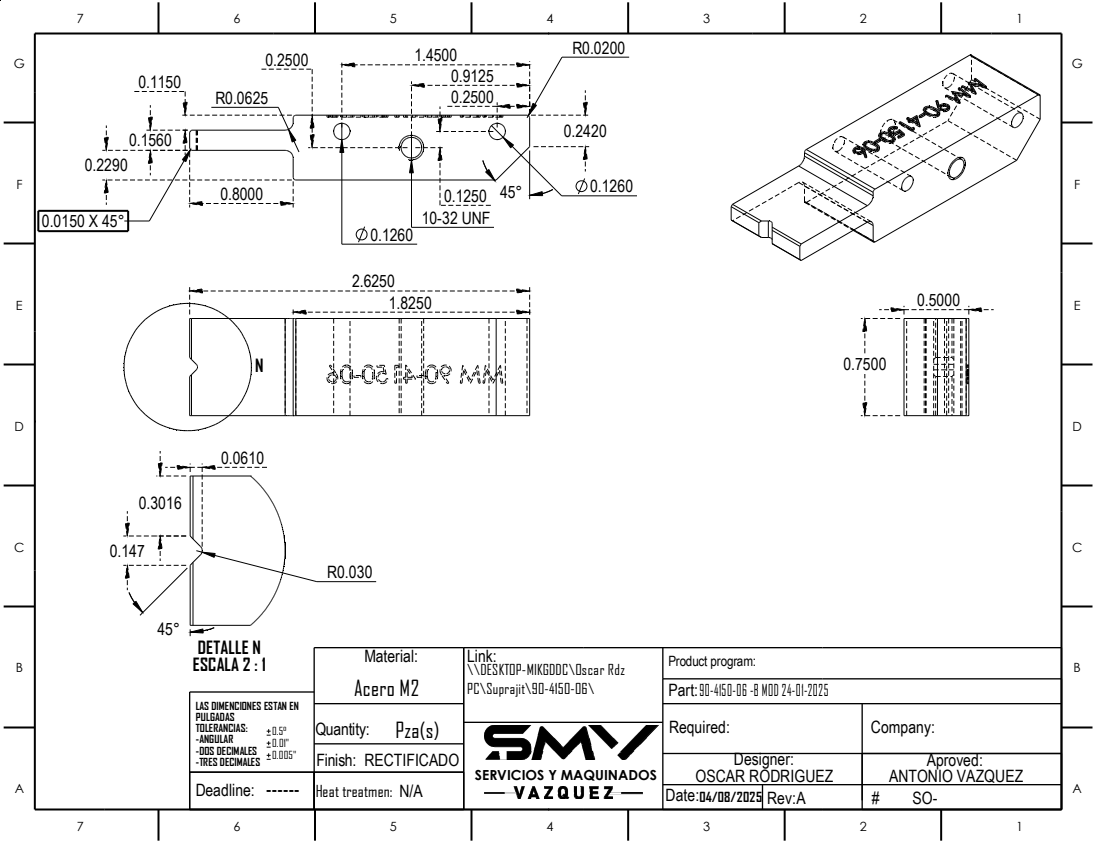
[picture p95: page 1]
RECTIFICADO; Material:; Required:; Part:; Company:; 90-4150-06 -B MOD 24-01-2025; Product program:; Finish:; Quantity:; Pza(s); Acero M2; SERVICIOS Y MAQUINADOS; 10-32 UNF; ESCALA 2 : 1; DETALLE N

Link:
\\DESKTOP-MIKGDDC\Oscar Rdz
PC\Suprajit\90-4150-06\

LAS DIMENCIONES ESTAN EN
PULGADAS
TOLERANCIAS:
-ANGULAR
-DOS DECIMALES
-TRES DECIMALES

Designer: OSCAR RODRIGUEZ | Aproved: ANTONIO VAZQUEZ

Deadline: ------ | Heat treatmen:

Date: 04/08/2025 | Rev: A | # SO- N/A
