jemiliano2001-blip/SMV-VISION/TOOL CRIB/Nido Tapon Prensa 2/Nido Tapon de Prensa2.pdf

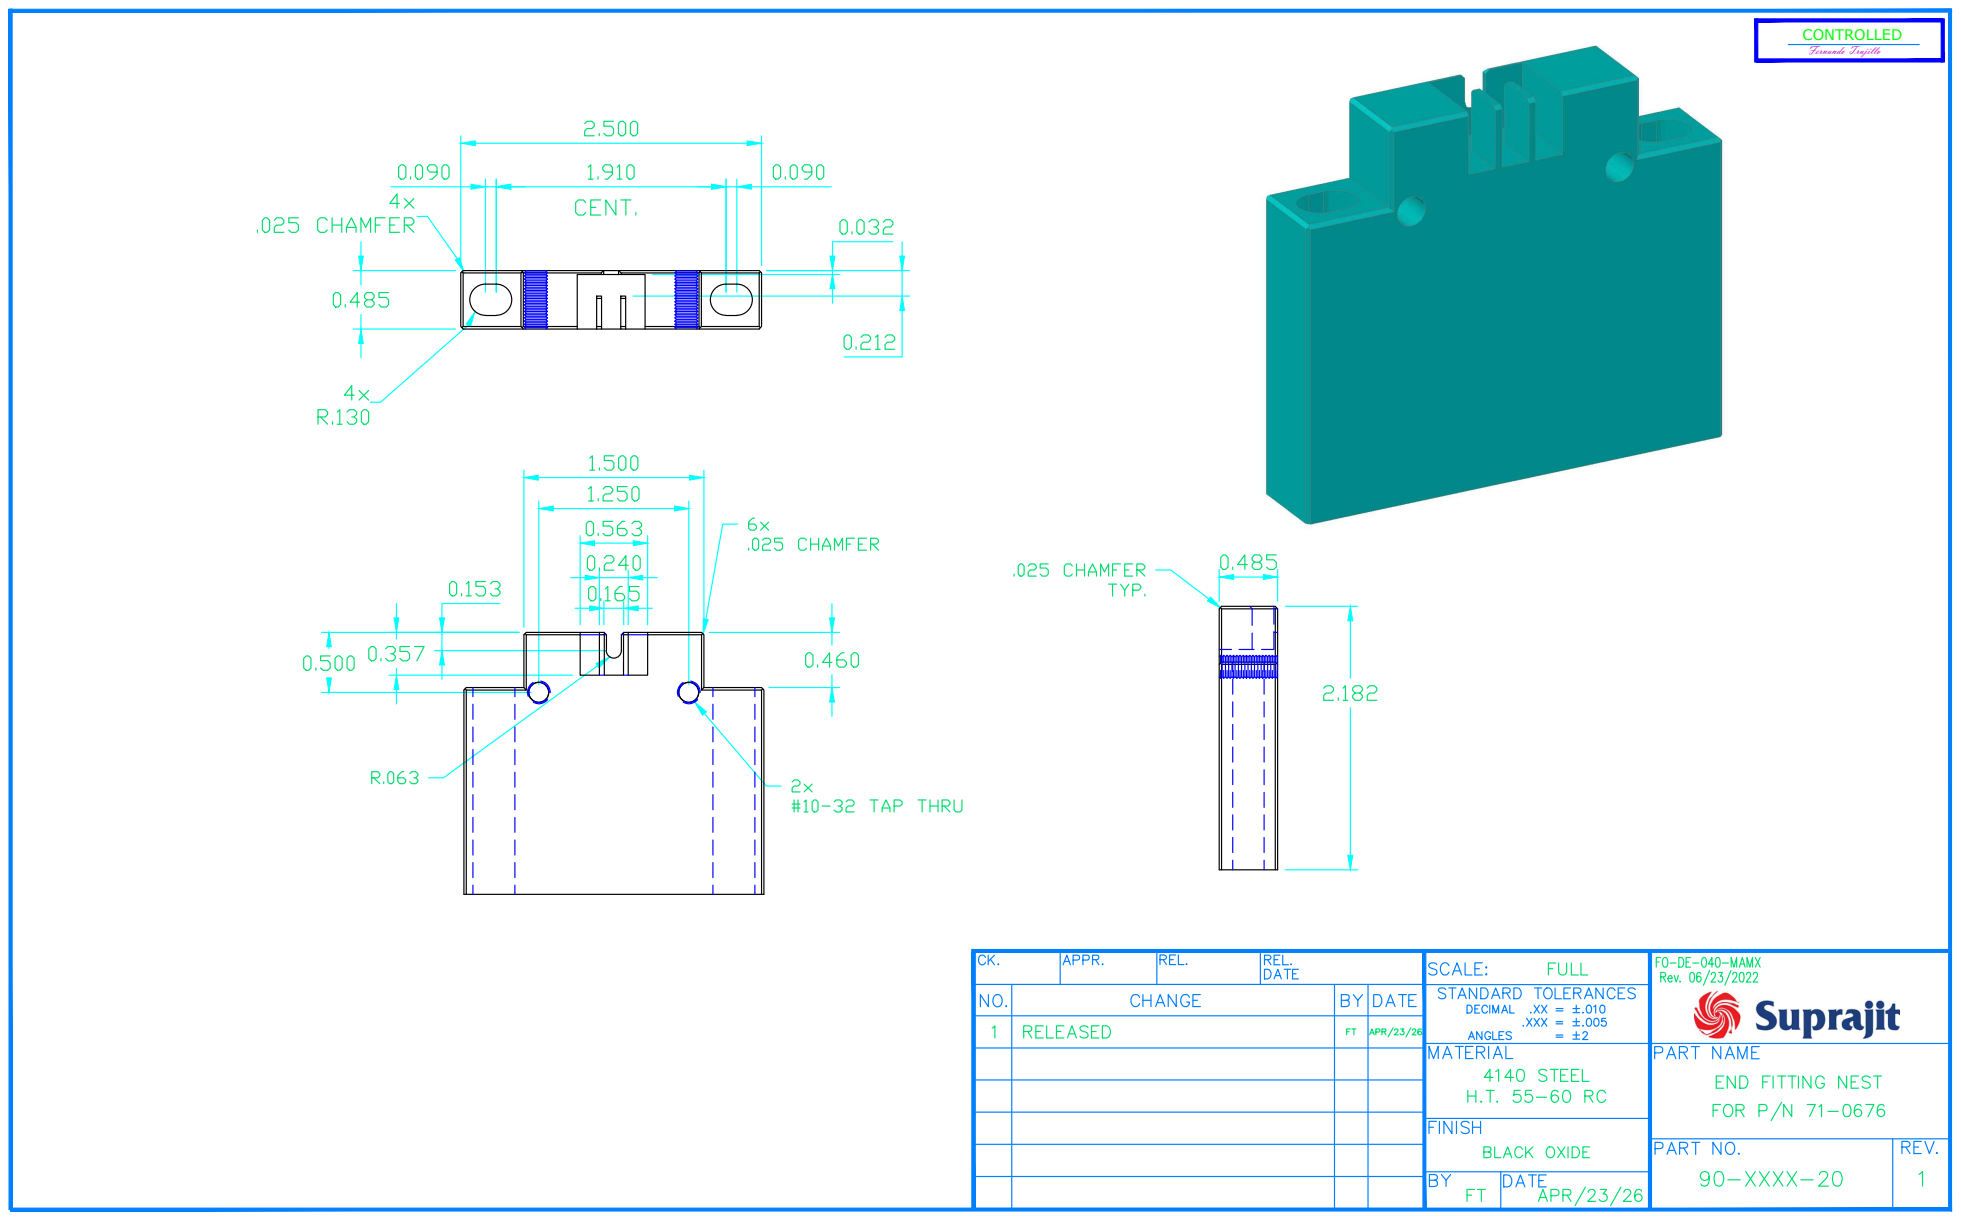
[picture p96: page 1]

Fernando Trujillo CONTROLLED
