jemiliano2001-blip/SMV-VISION/TOOL CRIB/PIn de Remache WCD01-1436-11X/Pin de Remache WCD01-1436-115.pdf

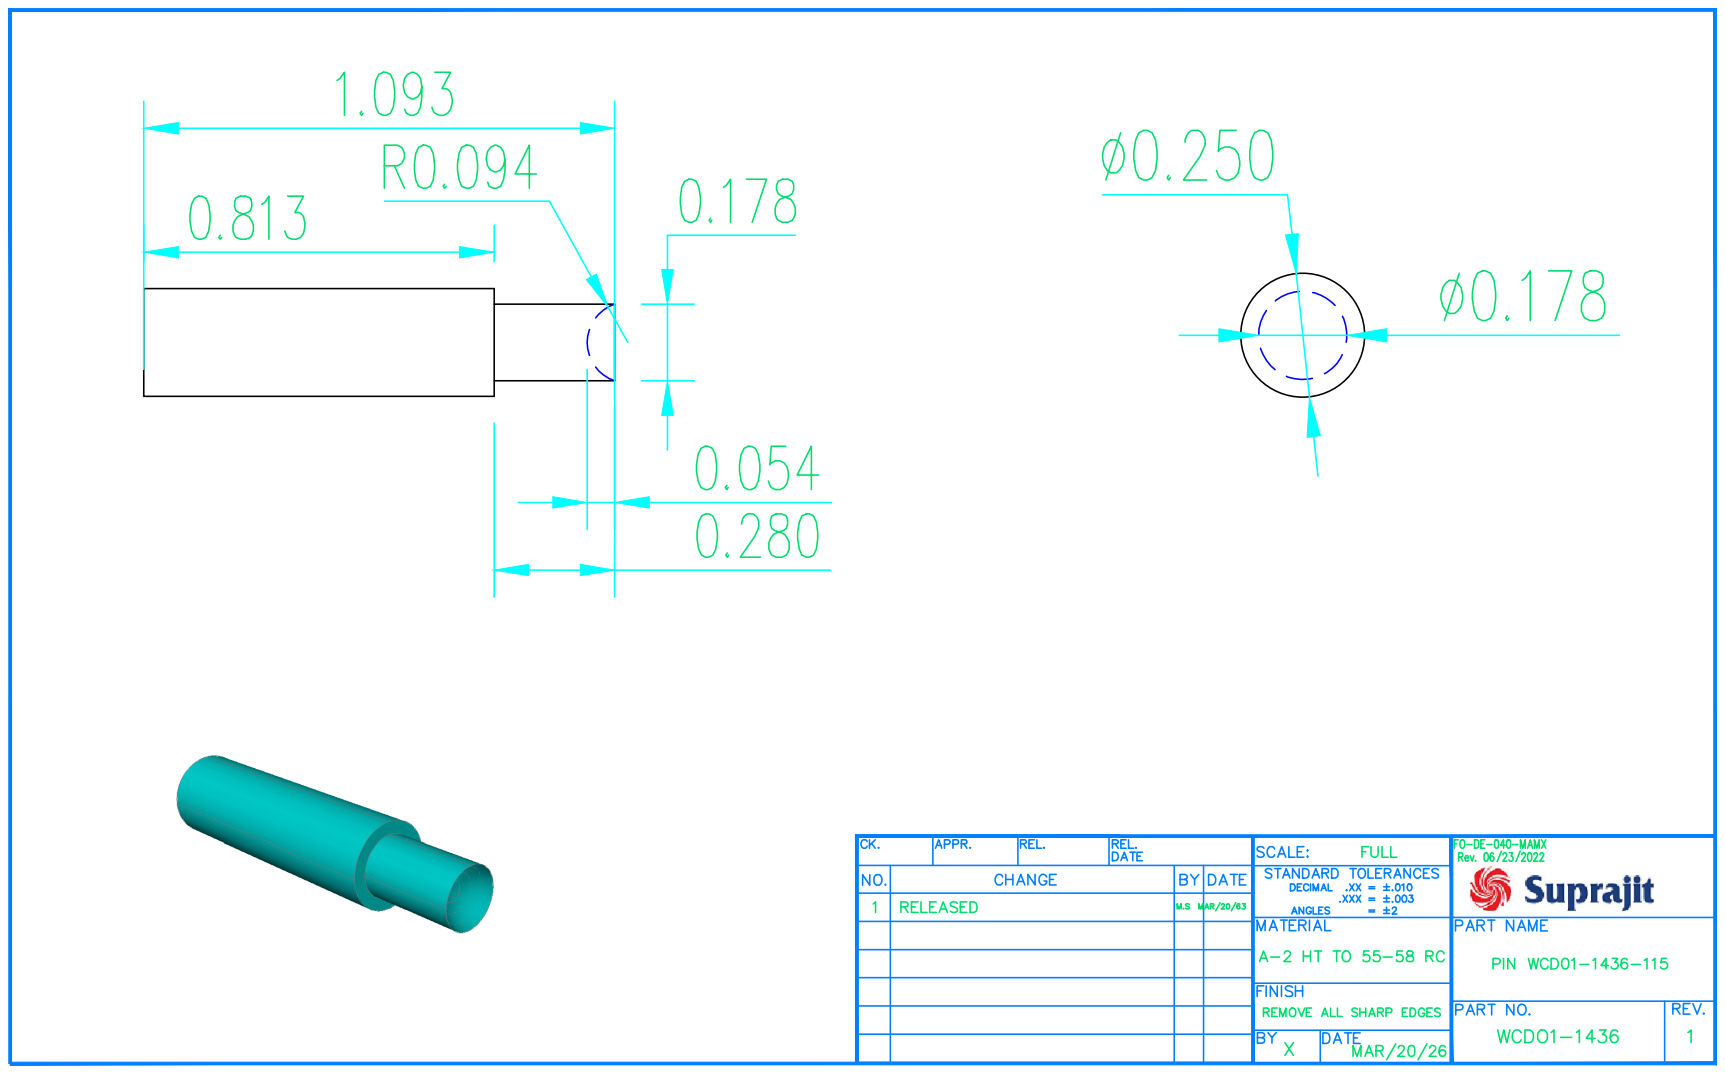
[picture p97: page 1]
