jemiliano2001-blip/SMV-VISION/TOOL CRIB/PIn de Remache WCD01-1436-11X/Pin de remache WCD01-1436-116.pdf

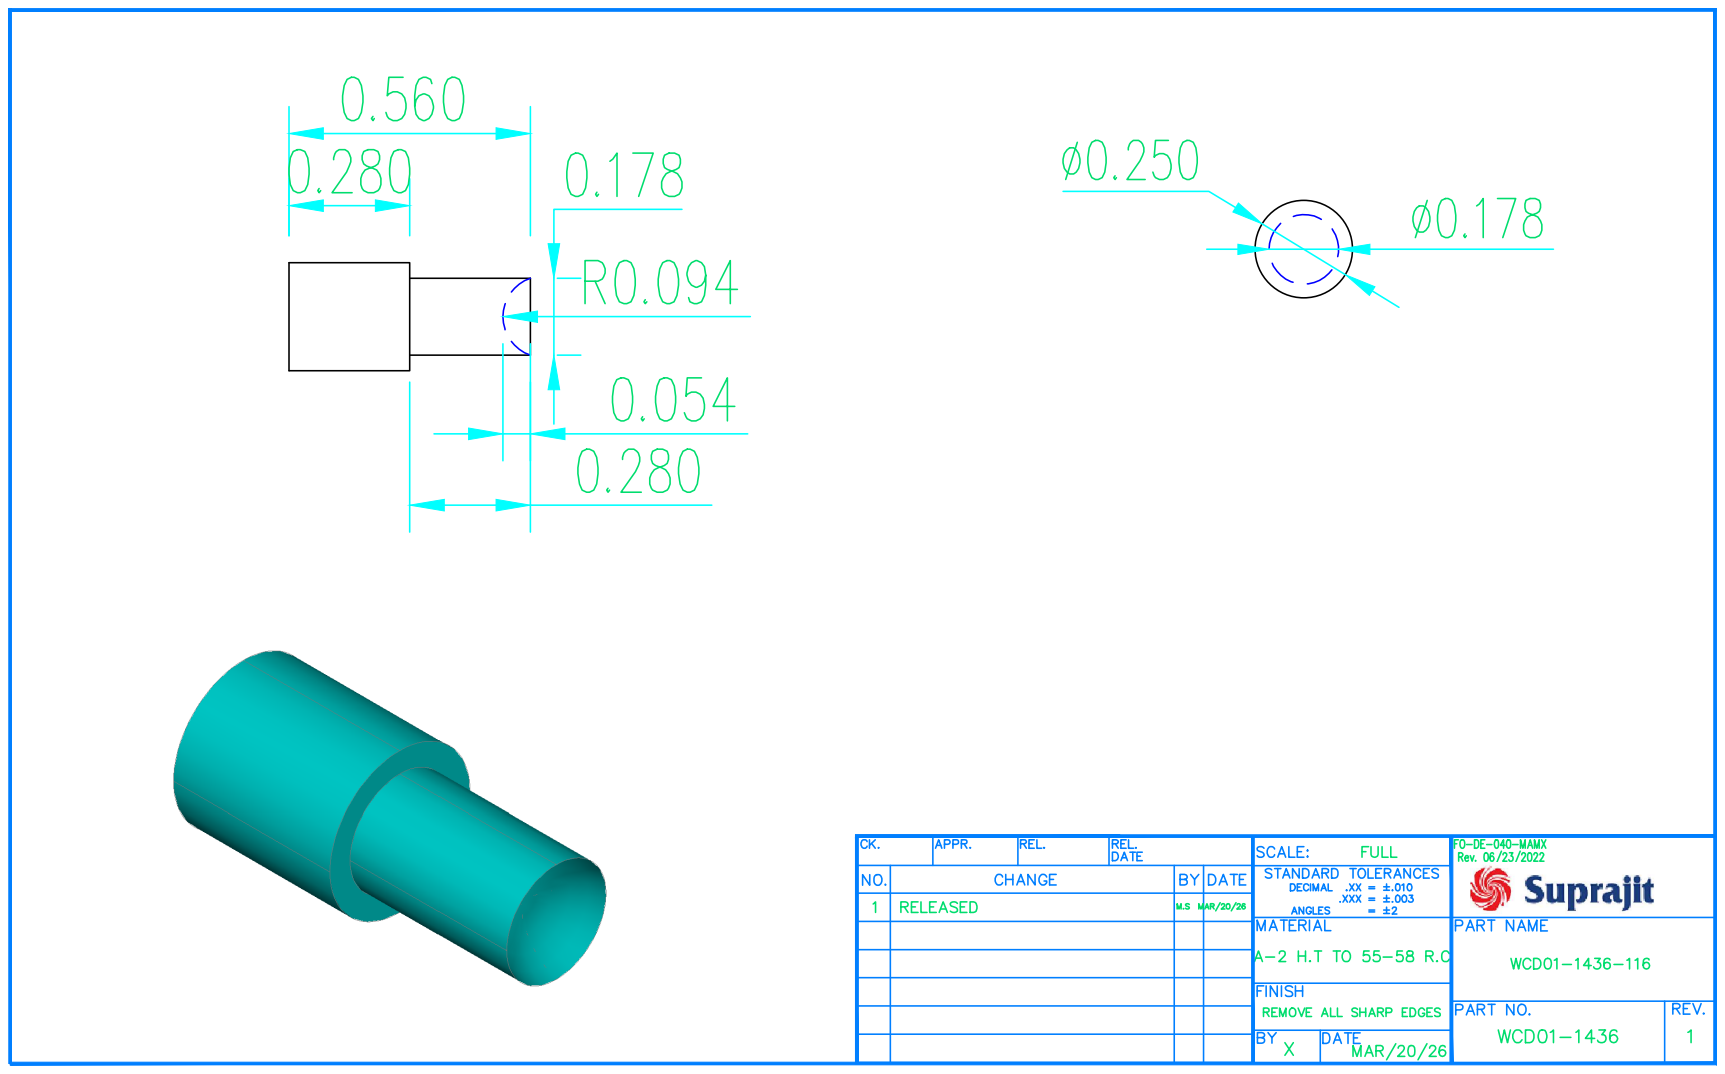
[picture p98: page 1]
