jemiliano2001-blip/SMV-VISION/TOOL CRIB/WCD16-1452/WCD16-1452-01.pdf

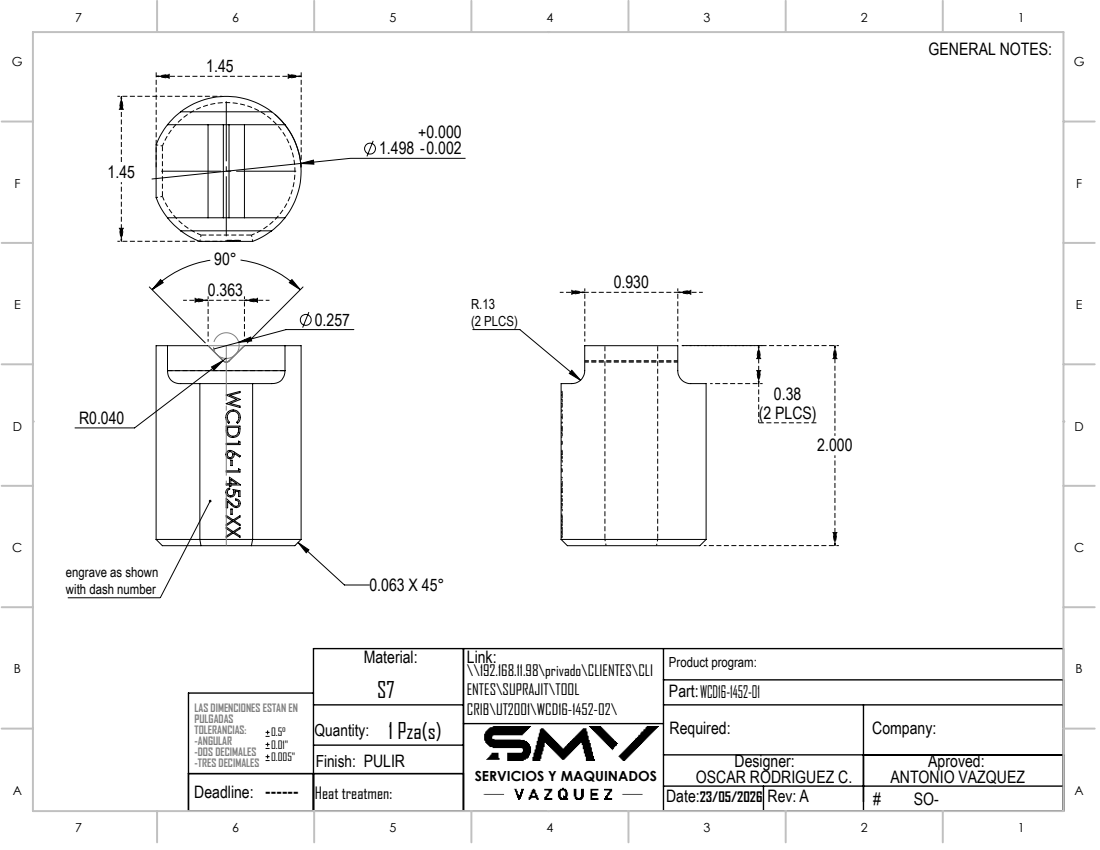
[picture p99: page 1]
(2 PLCS); Product program:; SERVICIOS Y MAQUINADOS; GENERAL NOTES:

engrave as shown
with dash number

Link:
\\192.168.11.98\privado\CLIENTES\CLI
ENTES\SUPRAJIT\TOOL
CRIB\UT2001\WCD16-1452-02\
1 Pza(s)
PULIR
Finish:

LAS DIMENCIONES ESTAN EN
PULGADAS
TOLERANCIAS:
-ANGULAR
-DOS DECIMALES
-TRES DECIMALES

Designer: OSCAR RODRIGUEZ C. | Aproved: ANTONIO VAZQUEZ

23/05/2026 Date: | A Rev: | # SO-

Deadline: ------ | Heat treatmen:
