jemiliano2001-blip/SMV-VISION/TOOL CRIB/WCD16-1452/WCD16-1452-02.pdf

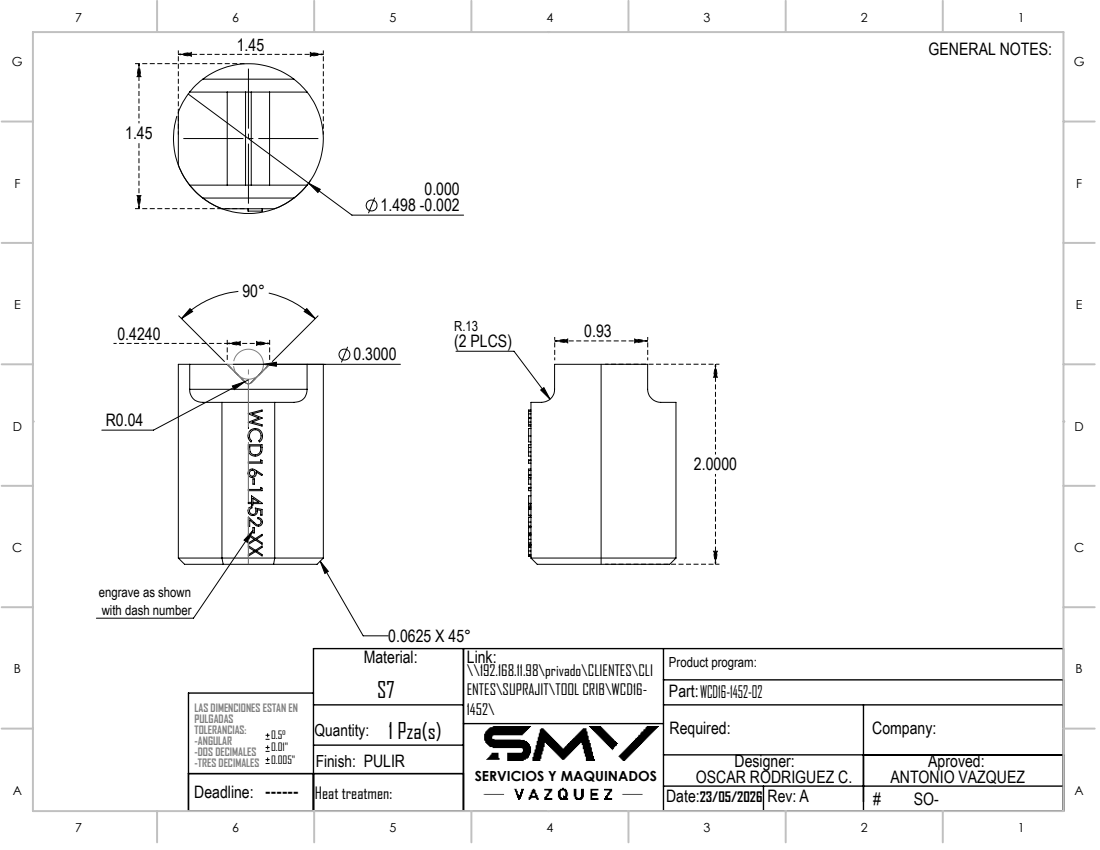
[picture p100: page 1]
(2 PLCS); Product program:; SERVICIOS Y MAQUINADOS; GENERAL NOTES:; 1 Pza(s)

engrave as shown
with dash number

Link:
\\192.168.11.98\privado\CLIENTES\CLI
ENTES\SUPRAJIT\TOOL CRIB\WCD16-

LAS DIMENCIONES ESTAN EN
PULGADAS
TOLERANCIAS:
-ANGULAR
-DOS DECIMALES
-TRES DECIMALES

Designer: OSCAR RODRIGUEZ C. | Aproved: ANTONIO VAZQUEZ

23/05/2026 Date: | A Rev: | # SO-

Deadline: ------ | Heat treatmen:
