jemiliano2001-blip/SMV-VISION/TOOL CRIB/BLOCKS/SWAGE-BLOCK/UT2033BLOCK.pdf

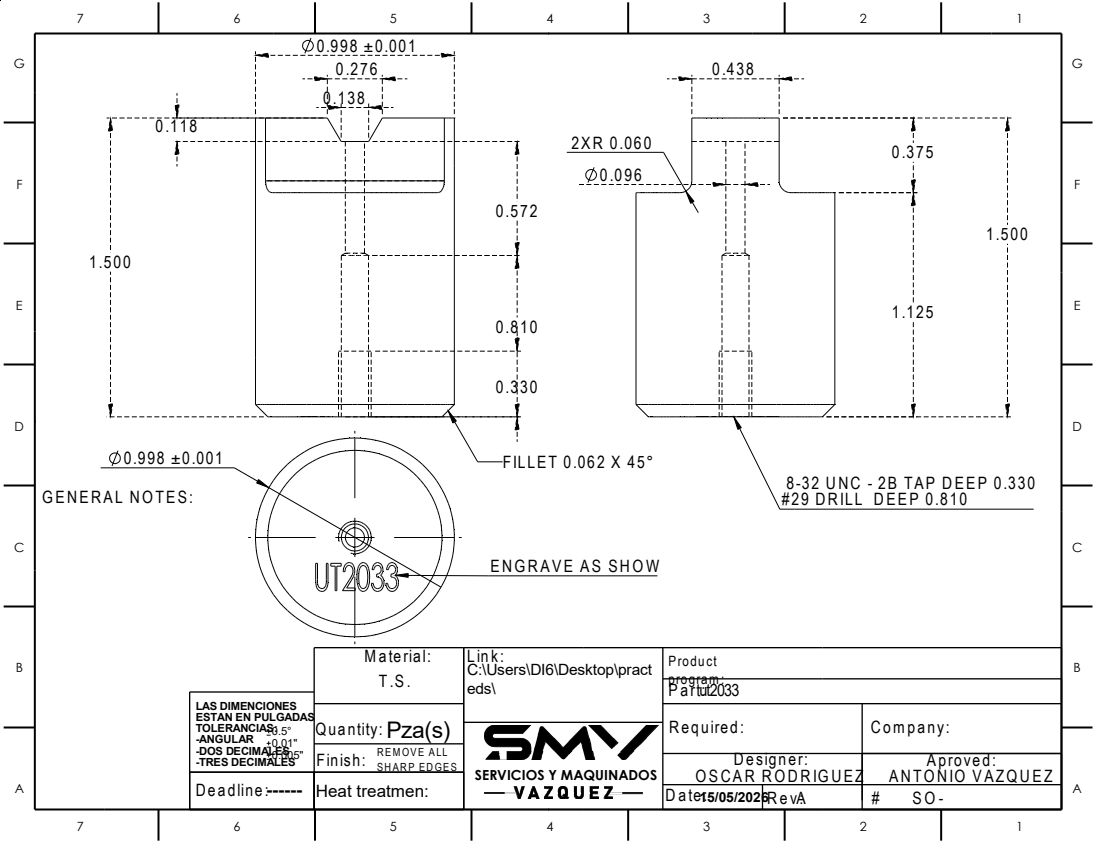
[picture p101: page 1]
M a te ria l:; R e q u ire d :; Pza(s); ut2033 program :; P rodu ct; 15/05/2026 Heat treatmen:; Finish:; Q ua ntity:; SERVICIOS Y MAQUINADOS; FIL LE T 0 .06 2 X 4 5°

C:\Users\DI6\Desktop\pract
eds\

LAS DIMENCIONES
ESTAN EN PULGADAS
TOLERANCIAS:
-ANGULAR
-DOS DECIMALES
-TRES DECIMALES

D e sig n e r: O S C A R R O D R IG U E Z | A p ro ve d : A N T O N IO V A Z Q U E Z
D a te : | R e v : A | # S O -

D e a d line : ------
