jemiliano2001-blip/SMV-VISION/TOOL CRIB/PUNZONES-DE-MARCA_HOT-STAMPS/PUNZONES DE MARCA/punzones-marca.pdf

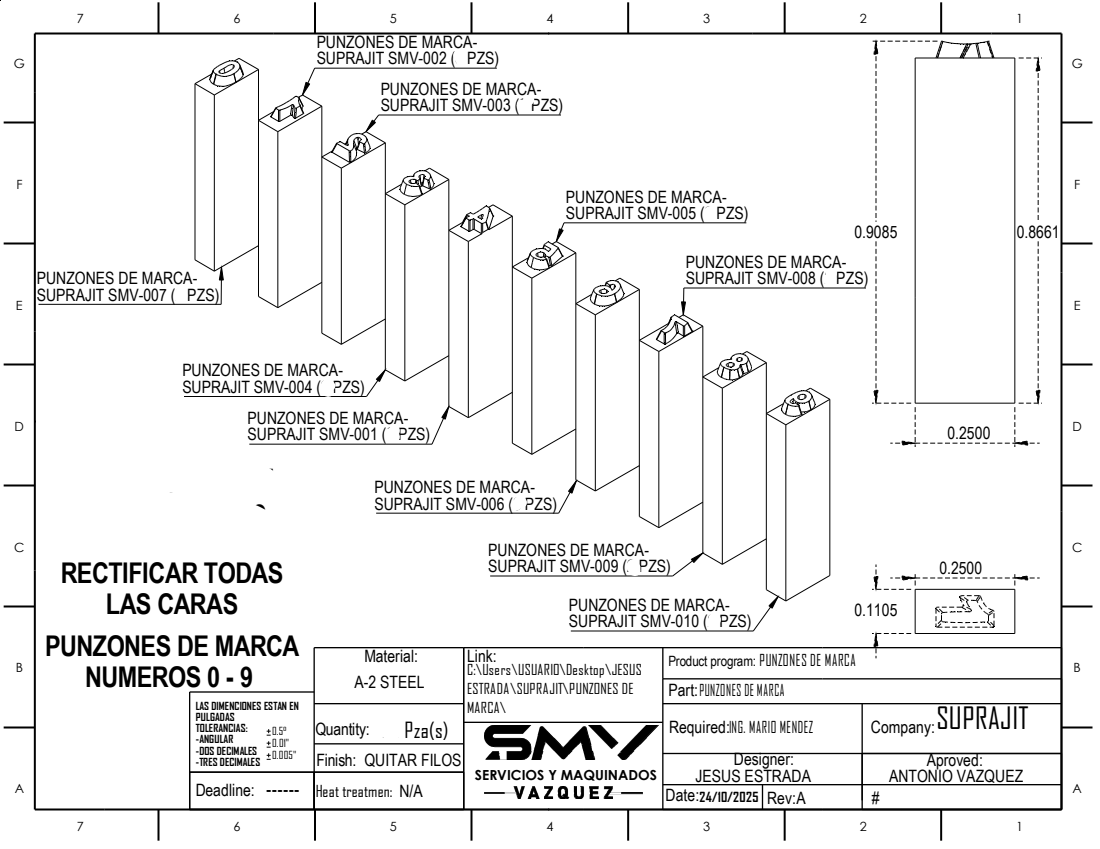
[picture p102: page 1]
QUITAR FILOS; Material:; Company:; SUPRAJIT; Finish:; Quantity:; 26 Pza(s); SERVICIOS Y MAQUINADOS; A-2 STEEL; 6 PZS SO20263; 20 PZS SO20335; LAS CARAS; RECTIFICAR TODAS; NUMEROS 0 - 9; PUNZONES DE MARCA

PUNZONES DE MARCA-
SUPRAJIT SMV-002 (3 PZS)

SUPRAJIT SMV-003 (3 PZS)

SUPRAJIT SMV-005 (3 PZS)

SUPRAJIT SMV-008 (2 PZS)

SUPRAJIT SMV-007 (2 PZS)

SUPRAJIT SMV-004 (3 PZS)

SUPRAJIT SMV-001 (3 PZS)

SUPRAJIT SMV-006 (3 PZS)

SUPRAJIT SMV-009 (2 PZS)

SUPRAJIT SMV-010 (2 PZS)

Link:
C:\Users\USUARIO\Desktop\JESUS
ESTRADA\SUPRAJIT\PUNZONES DE
MARCA\

Product program:
Part:
PUNZONES DE MARCA
Required:

LAS DIMENCIONES ESTAN EN
PULGADAS
TOLERANCIAS:
-ANGULAR
-DOS DECIMALES
-TRES DECIMALES

ING. MARIO MENDEZ

Designer: JESUS ESTRADA | Aproved: ANTONIO VAZQUEZ
Date: 24/10/2025 | Rev: A | #

Deadline: ------ | Heat treatmen: N/A
