jemiliano2001-blip/SMV-VISION/TOOL CRIB/WCD03-1797/WCD03-1797/WCD03-1797-02.PDF

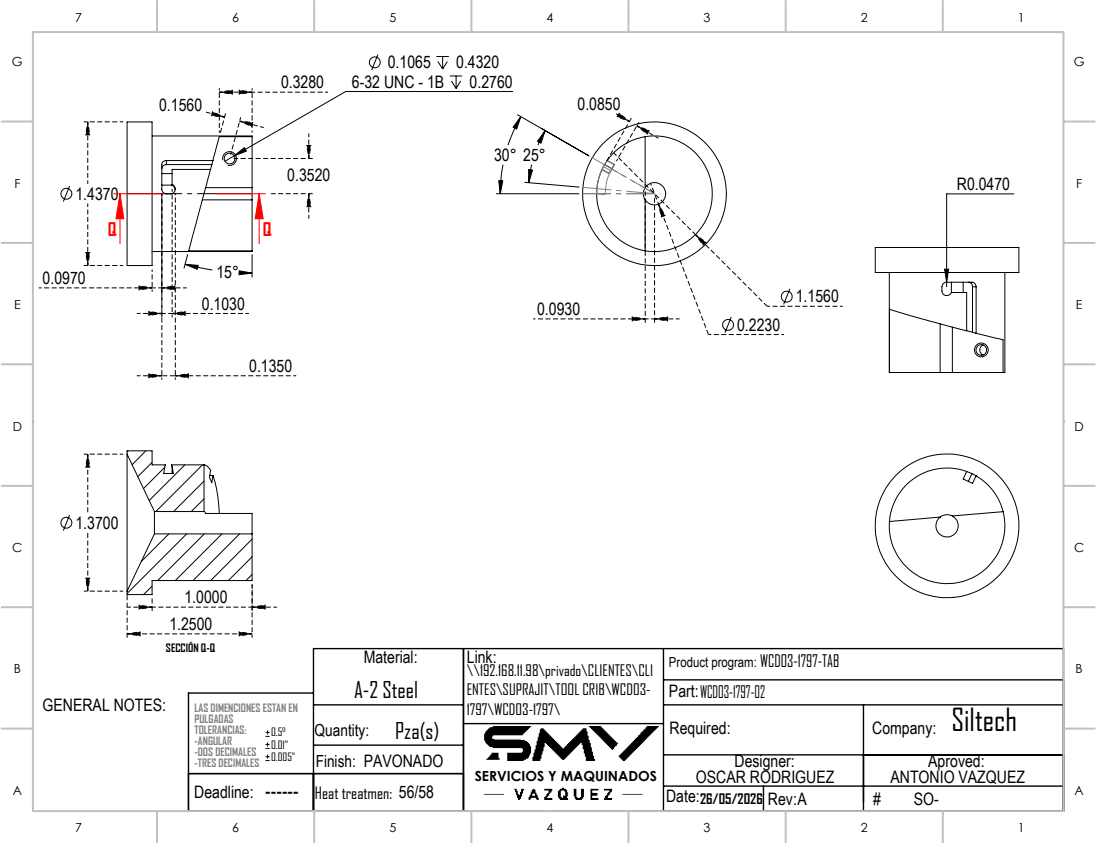
[picture p103: page 1]
0.1065 0.4320 6-32 UNC - 1B 0.2760; SECCIÓN Q-Q; Product program:; SERVICIOS Y MAQUINADOS; GENERAL NOTES:; A-2 Steel

Link:
\\192.168.11.98\privado\CLIENTES\CLI
ENTES\SUPRAJIT\TOOL CRIB\WCD03-
1797\WCD03-1797\
Pza(s)
PAVONADO
Finish:

LAS DIMENCIONES ESTAN EN
PULGADAS
TOLERANCIAS:
-ANGULAR
-DOS DECIMALES
-TRES DECIMALES

Designer: OSCAR RODRIGUEZ | Aproved: ANTONIO VAZQUEZ

26/05/2026 Date: | A Rev: | # SO-

Deadline: ------ | 56/58 Heat treatmen:
