jemiliano2001-blip/SMV-VISION/TOOL CRIB/_SIN-CLASIFICAR/386306/386306.pdf

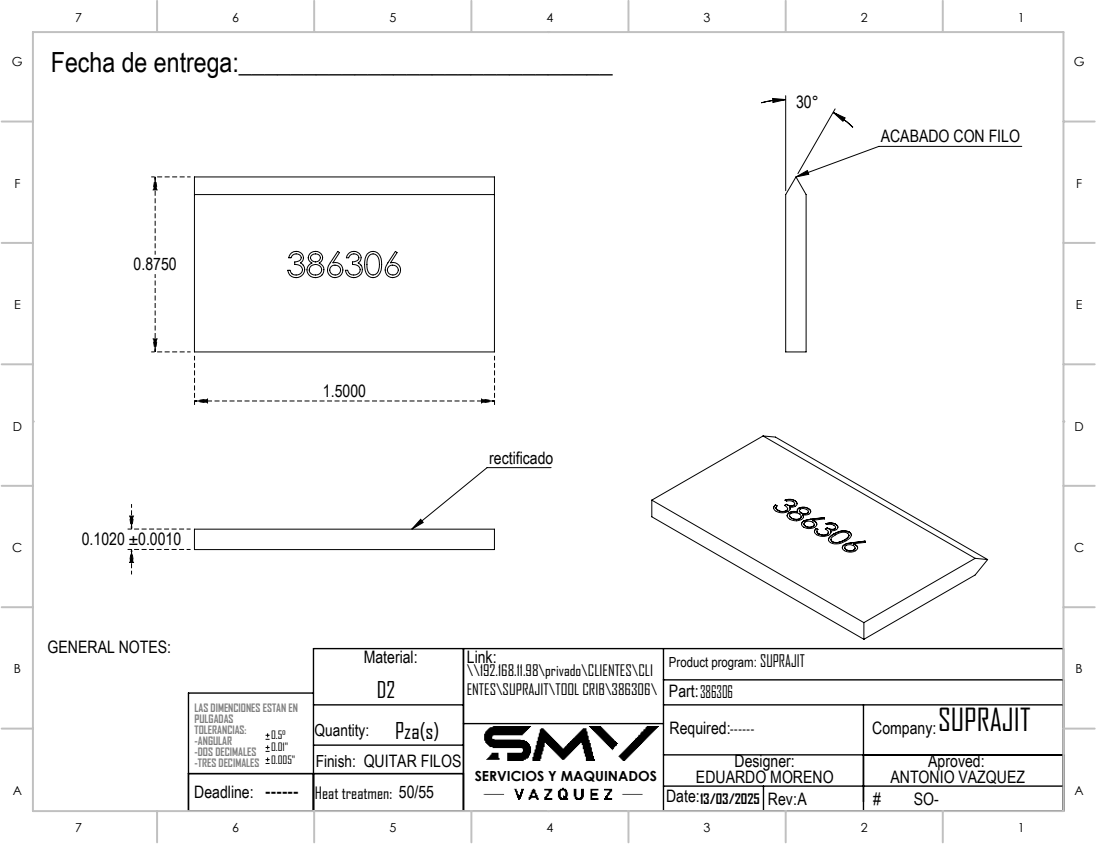
[picture p104: page 1]
Product program:; SERVICIOS Y MAQUINADOS; GENERAL NOTES:

Fecha de entrega:_____________________________

ACABADO CON FILO

Link:
\\192.168.11.98\privado\CLIENTES\CLI
ENTES\SUPRAJIT\TOOL CRIB\386306\
Pza(s)
QUITAR FILOS
Finish:

LAS DIMENCIONES ESTAN EN
PULGADAS
TOLERANCIAS:
-ANGULAR
-DOS DECIMALES
-TRES DECIMALES

Designer: EDUARDO MORENO | Aproved: ANTONIO VAZQUEZ

13/03/2025 Date: | A Rev: | # SO-

Deadline: ------ | 50/55 Heat treatmen:
