jemiliano2001-blip/SMV-VISION/TOOL CRIB/_SIN-CLASIFICAR/90-0710-02/90-0710-02rev4.pdf

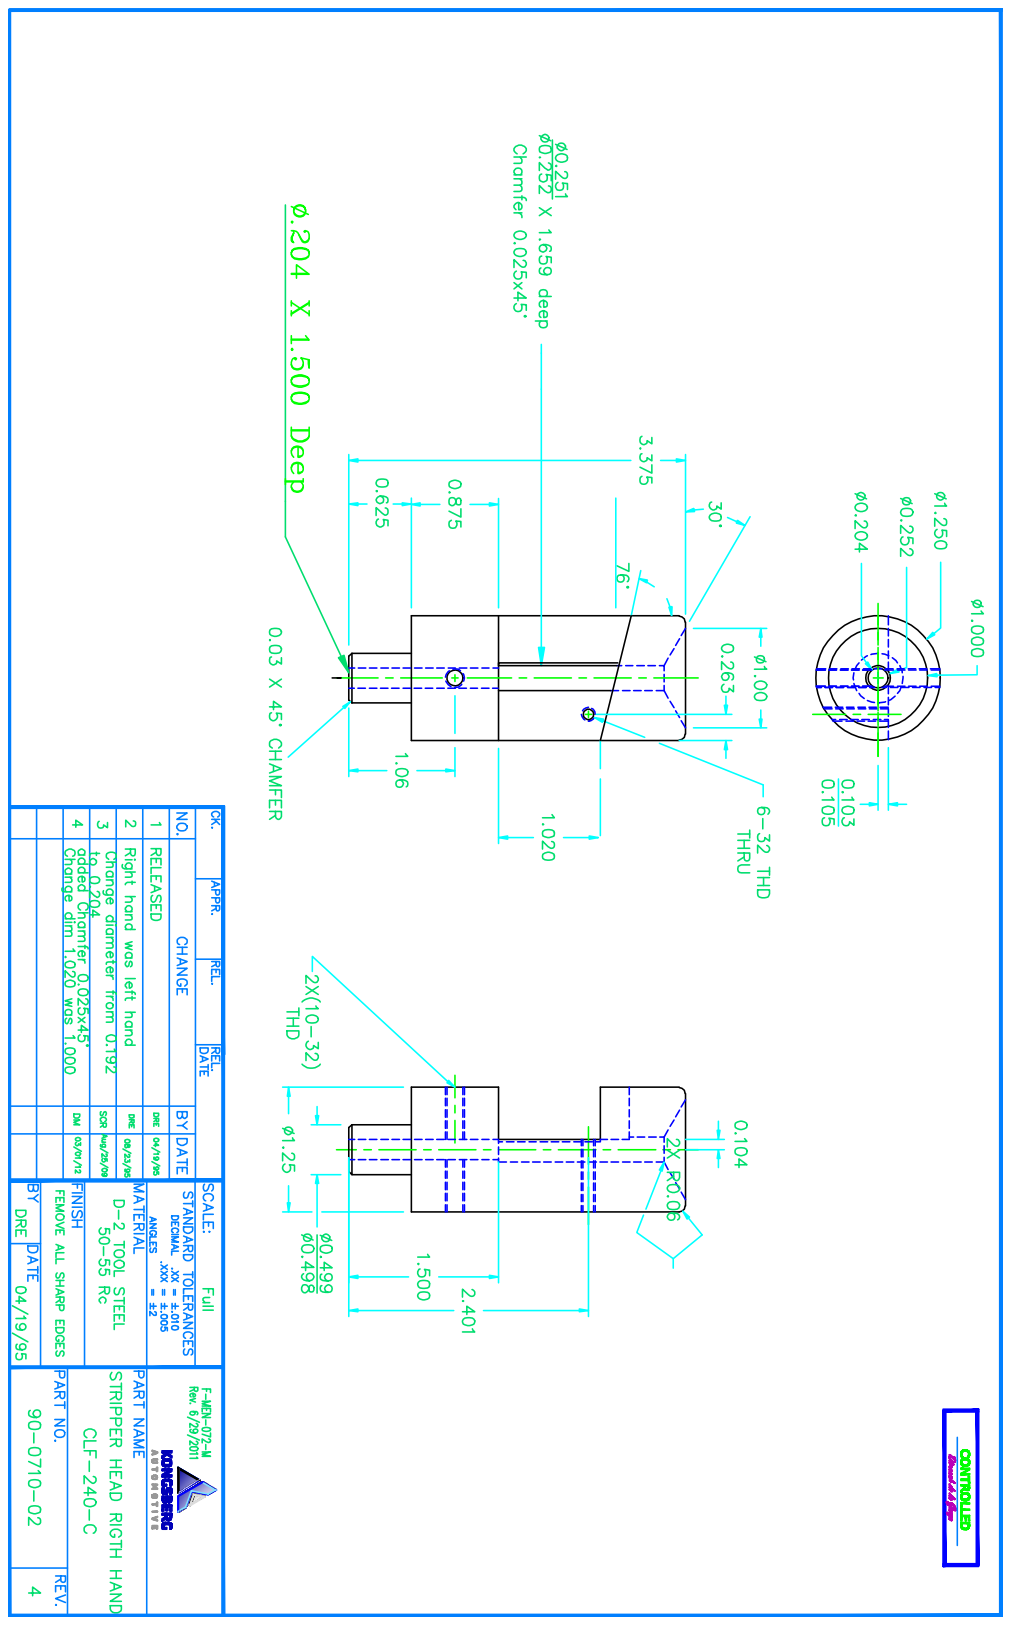
[picture p105: page 1]
