jemiliano2001-blip/SMV-VISION/TOOL CRIB/_SIN-CLASIFICAR/90-0900-01_Rev2/90-0900-01rev2.pdf

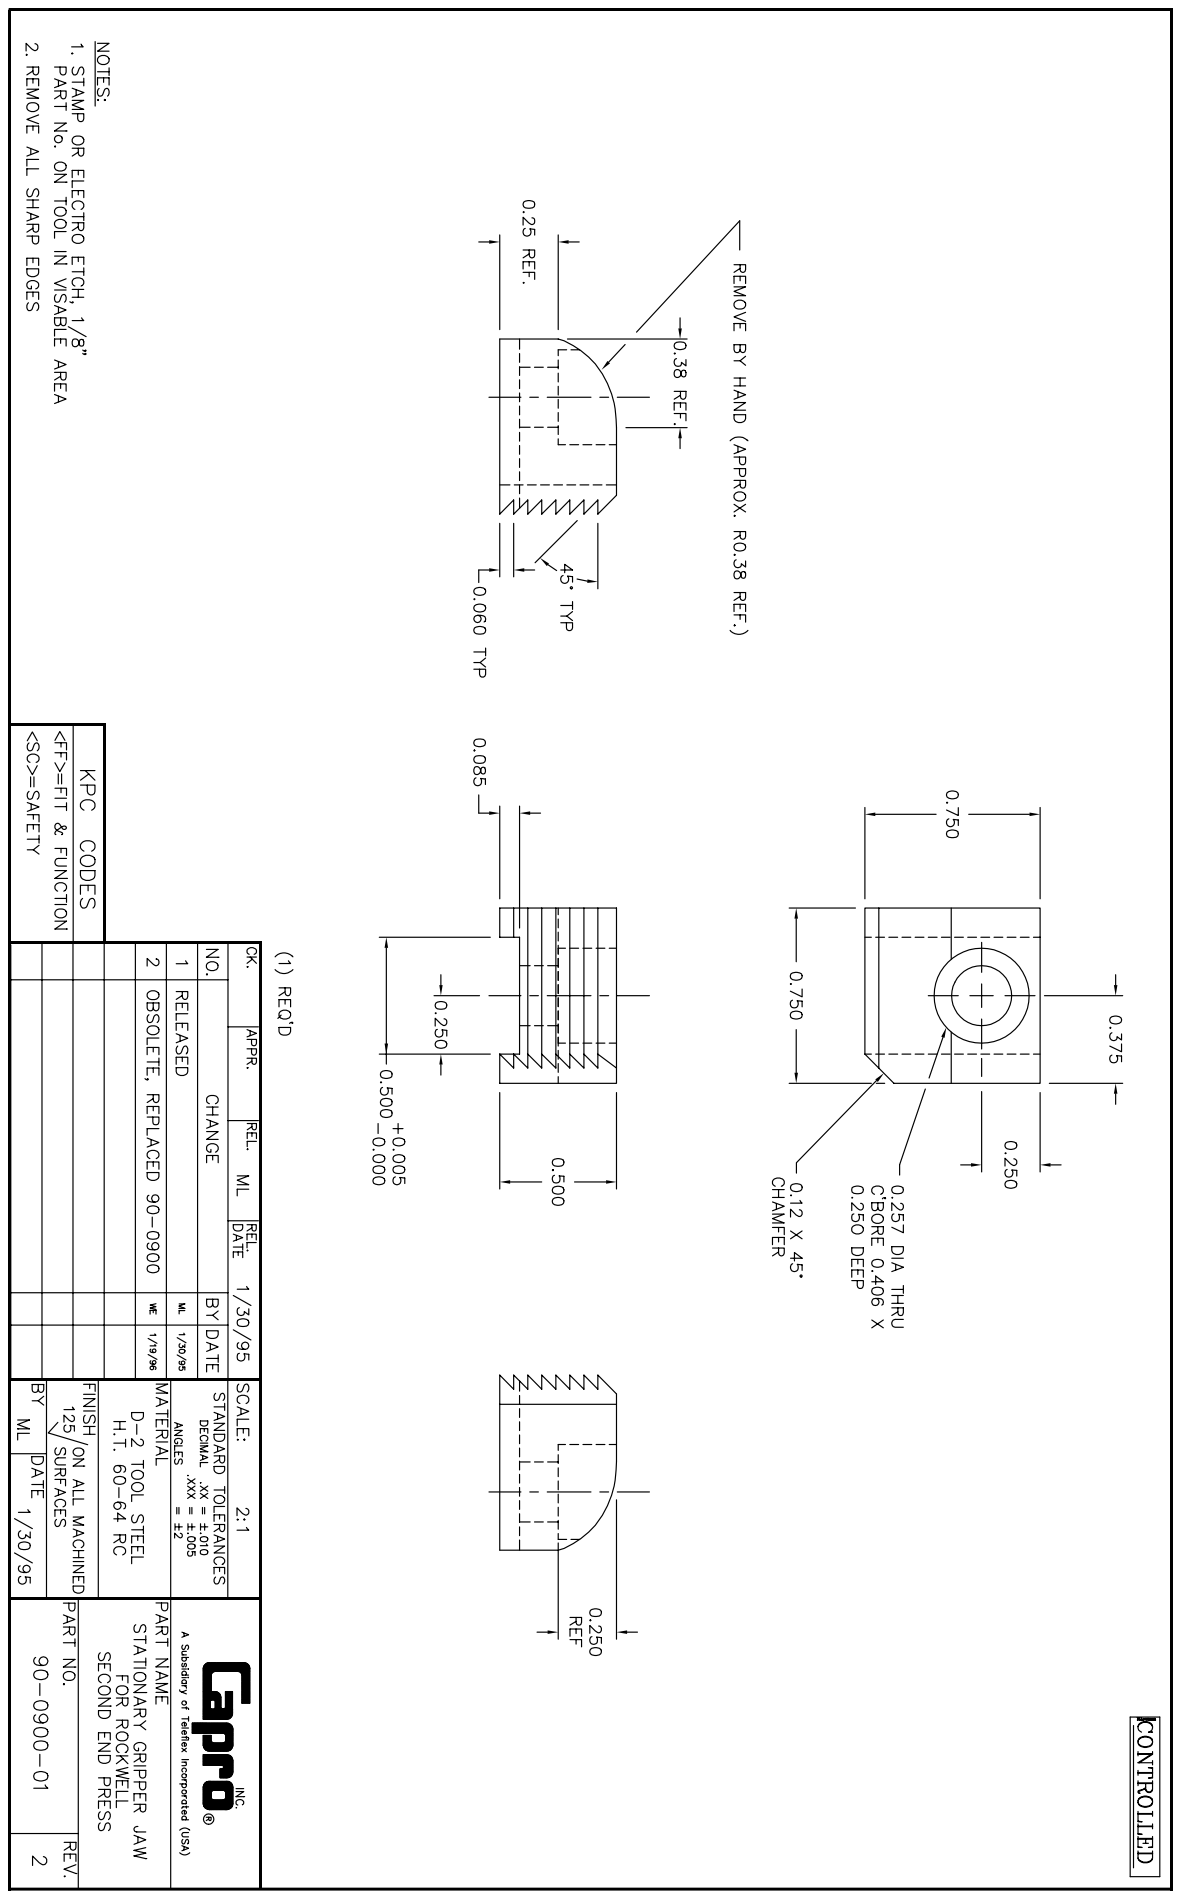
[picture p106: page 1]
