jemiliano2001-blip/SMV-VISION/TOOL CRIB/_SIN-CLASIFICAR/90-3262_Rev4_UPSET-CONDUIT-CLAMP/90-3262-Rev4.pdf

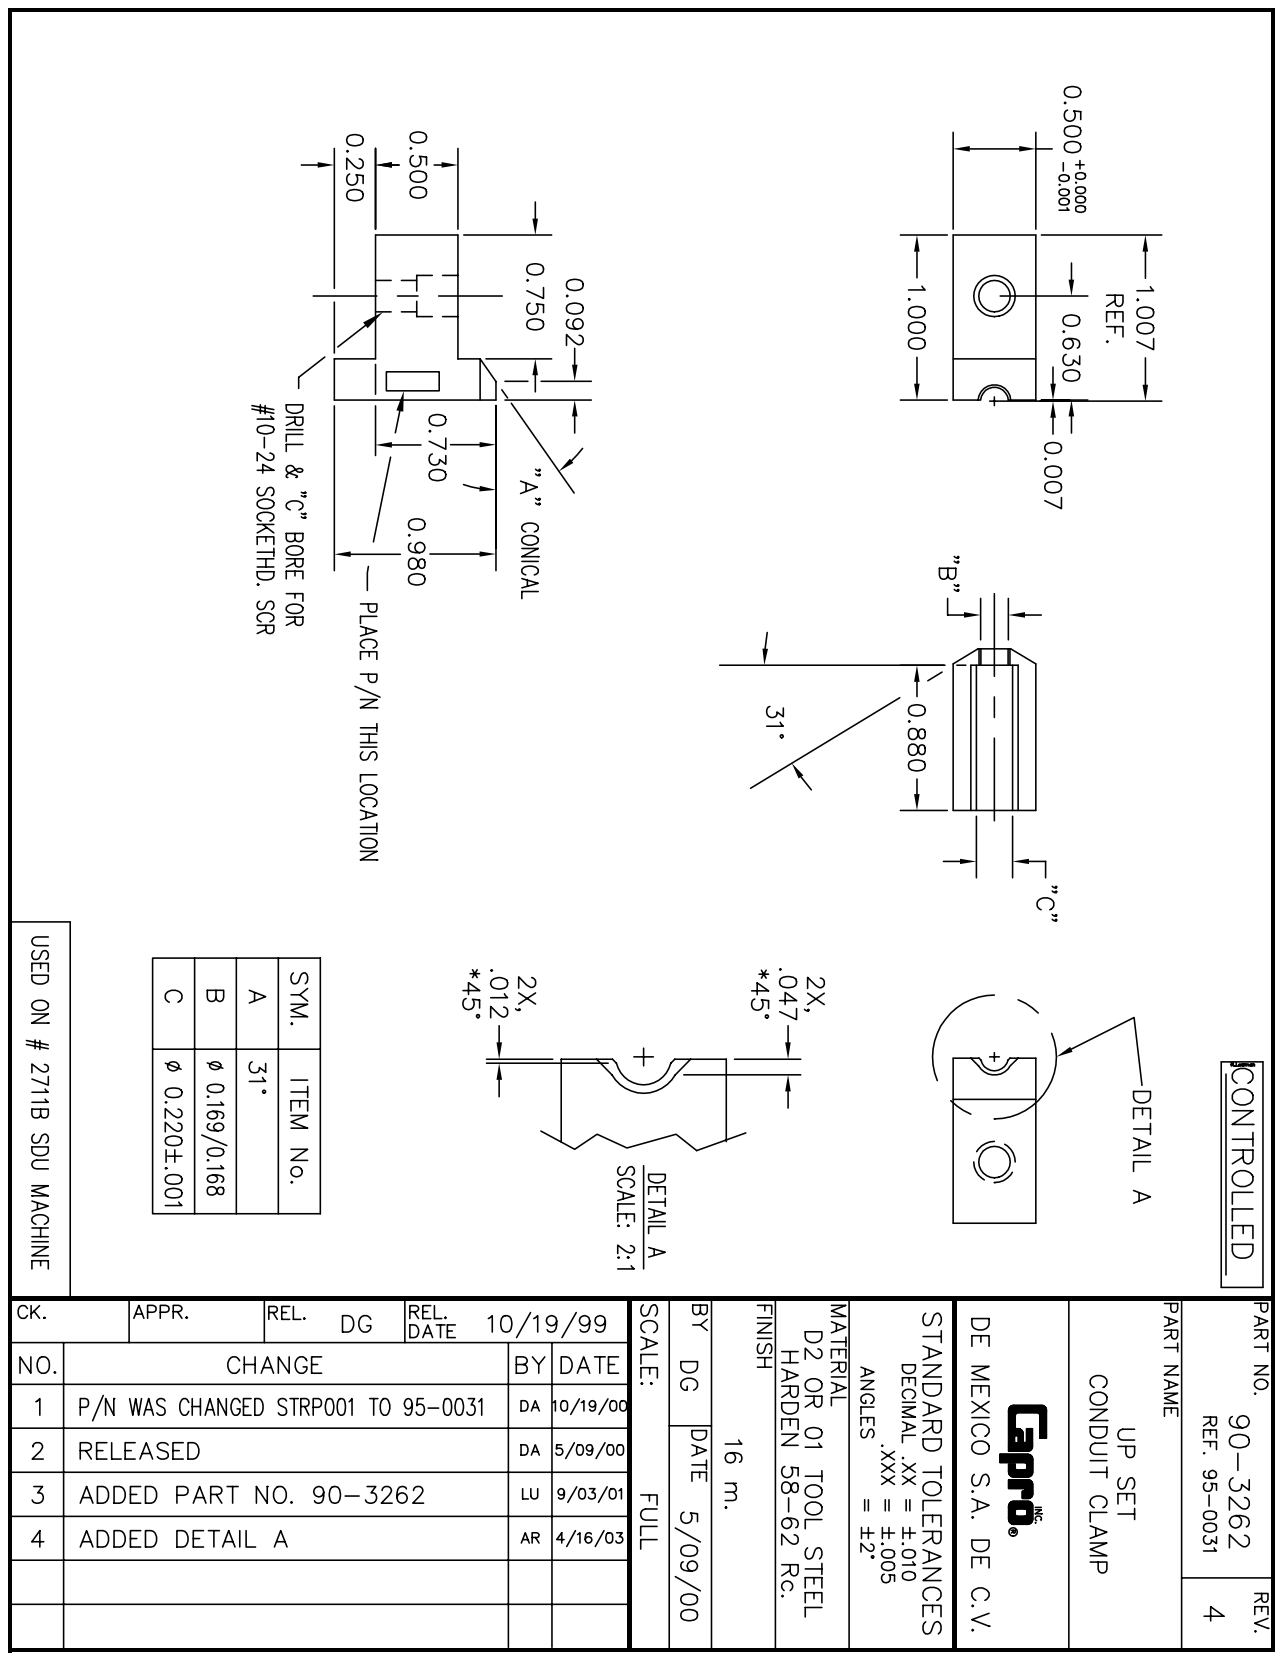
[picture p107: page 1]
