jemiliano2001-blip/SMV-VISION/TOOL CRIB/_SIN-CLASIFICAR/90-3305_Rev1/90-3305rev1.pdf

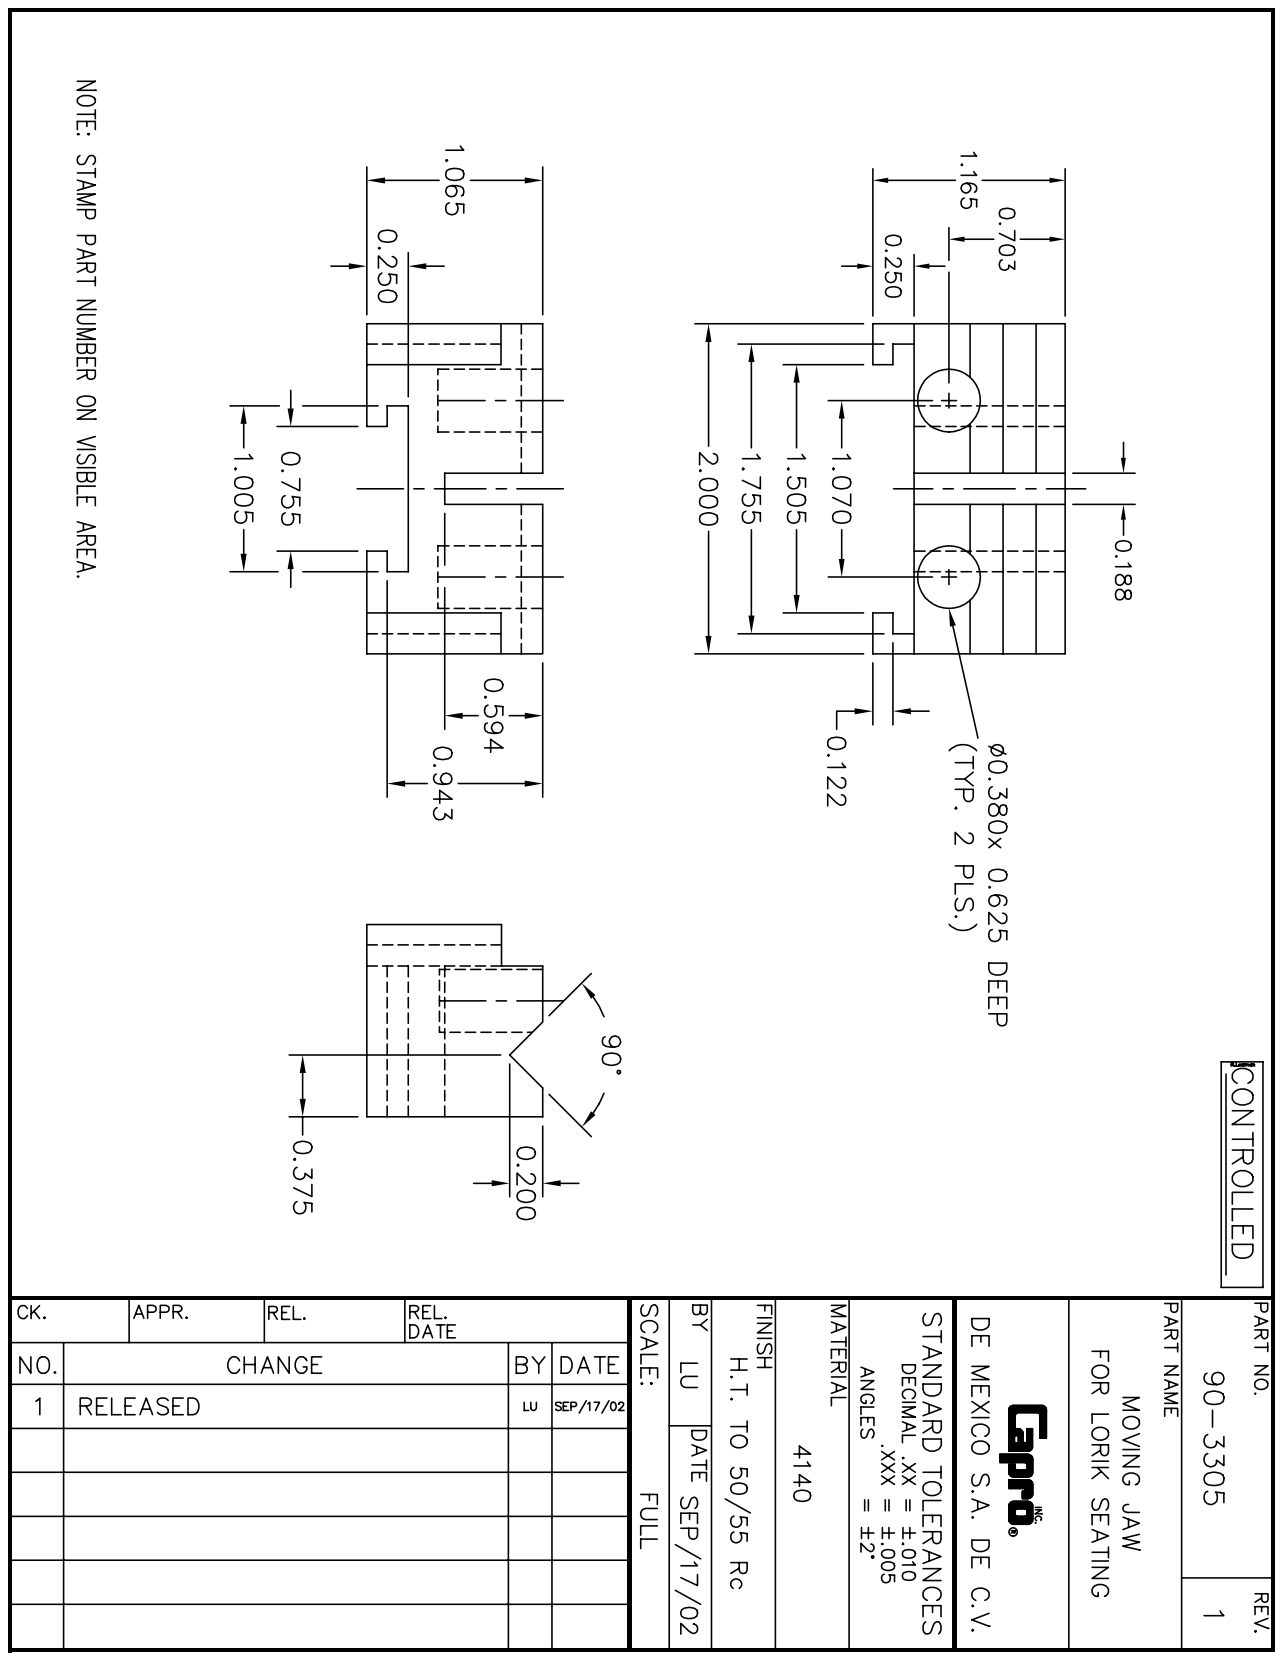
[picture p108: page 1]
