jemiliano2001-blip/SMV-VISION/TOOL CRIB/_SIN-CLASIFICAR/90-3354_Rev2_TORNILLO-HUSILLO/90-3354rev2-tornillo-para-husillo.pdf

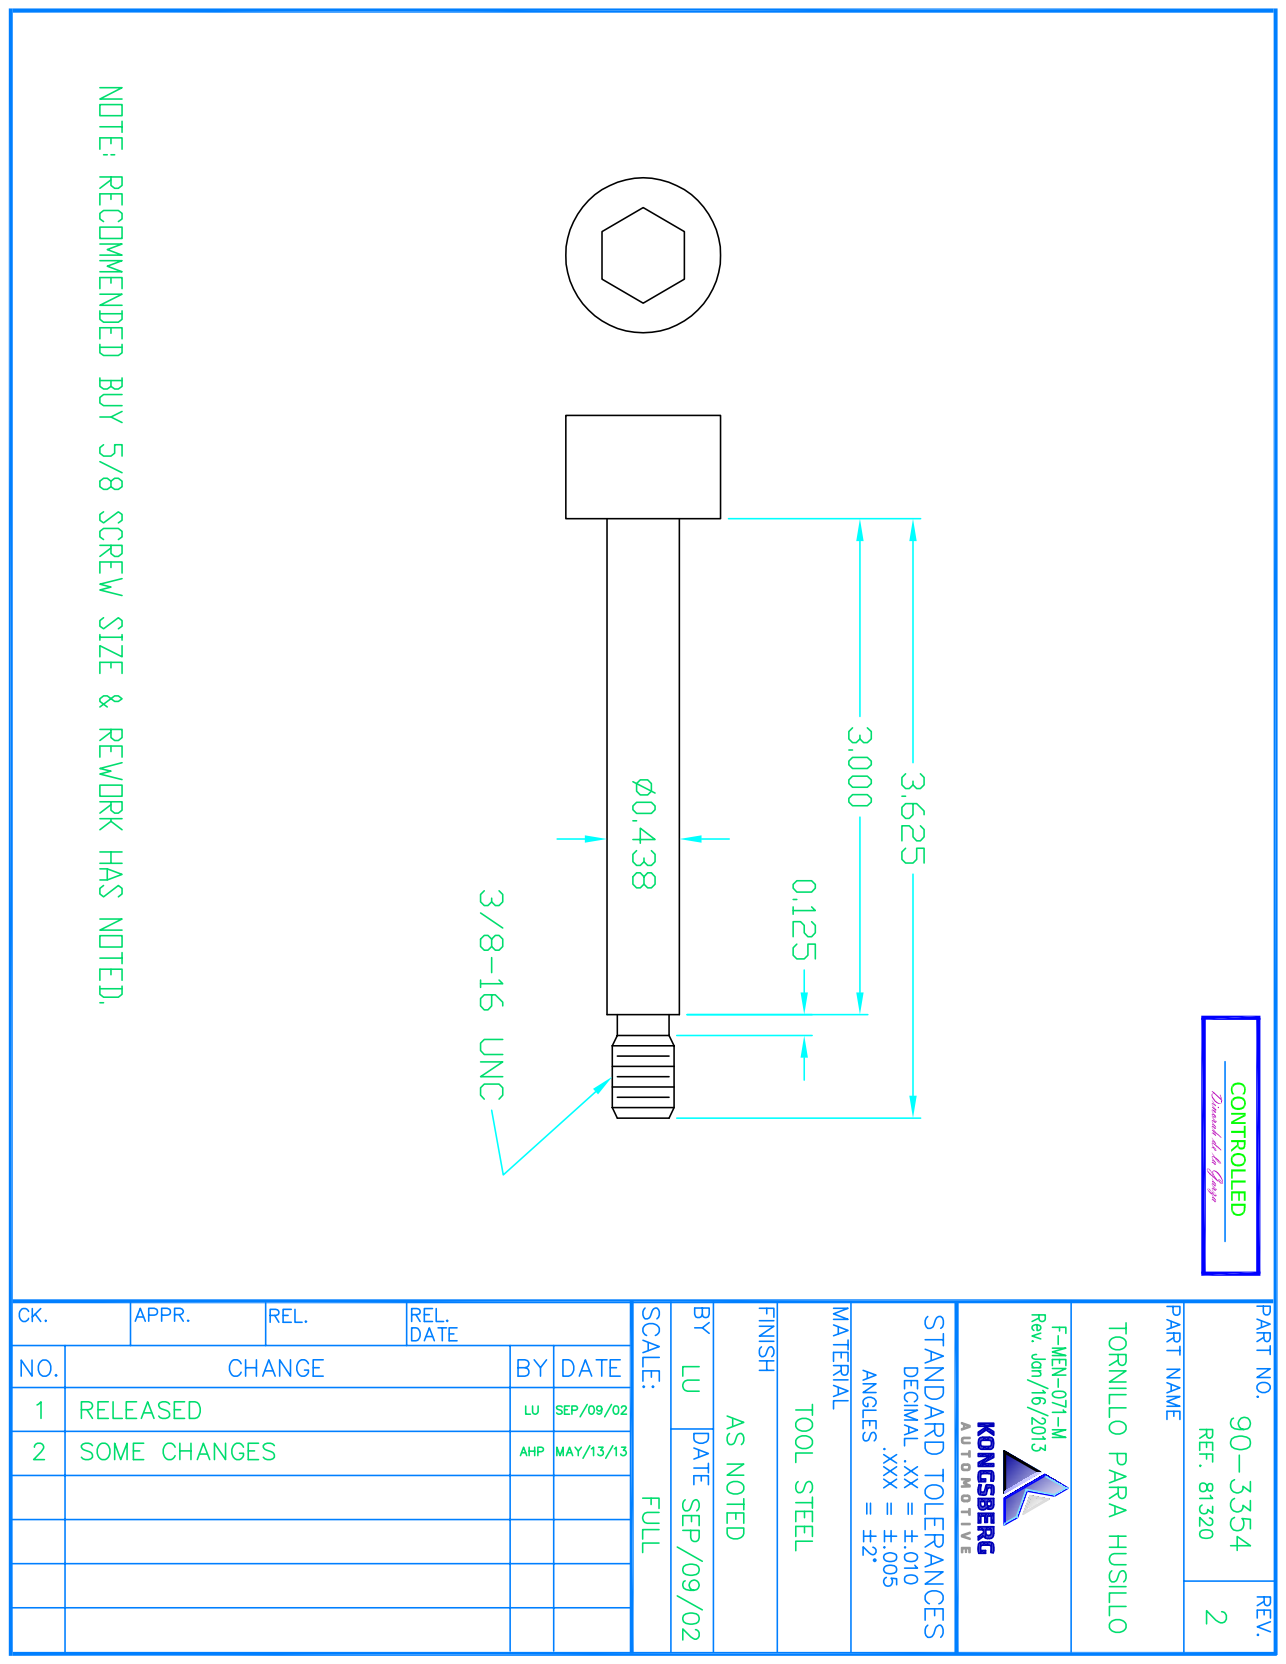
[picture p109: page 1]
