jemiliano2001-blip/SMV-VISION/TOOL CRIB/_SIN-CLASIFICAR/90-5239_Rev2/90-5239rev2.pdf

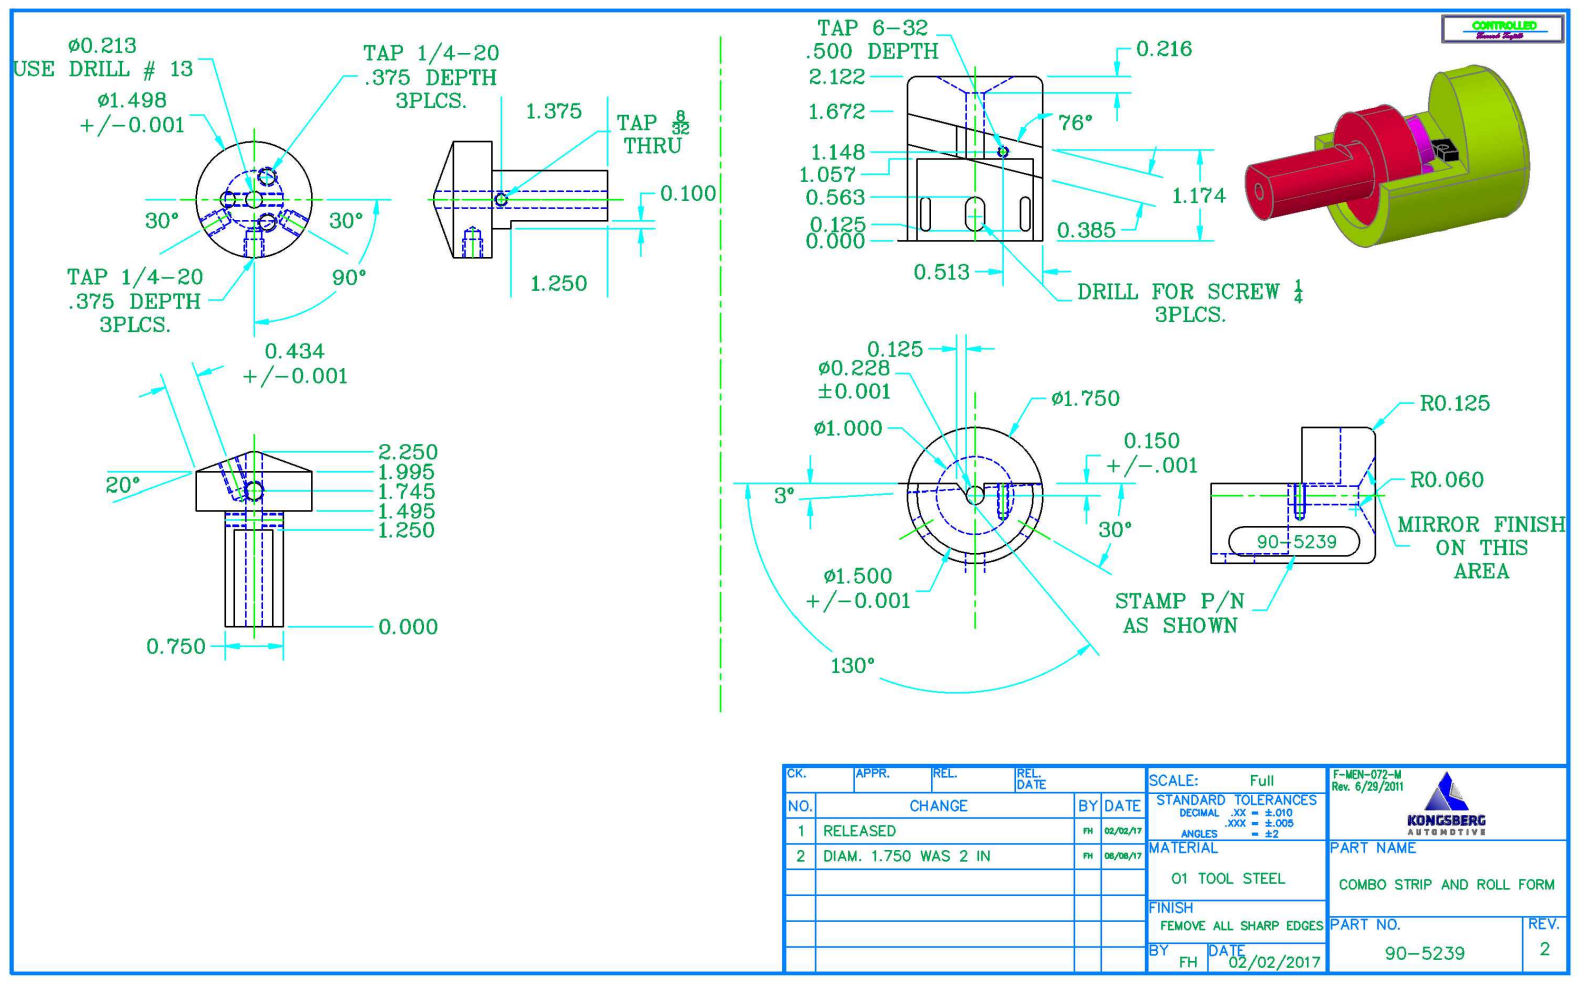
[picture p110: page 1]
