jemiliano2001-blip/SMV-VISION/TOOL CRIB/_SIN-CLASIFICAR/90-5283_Rev1/90-5283rev1.pdf

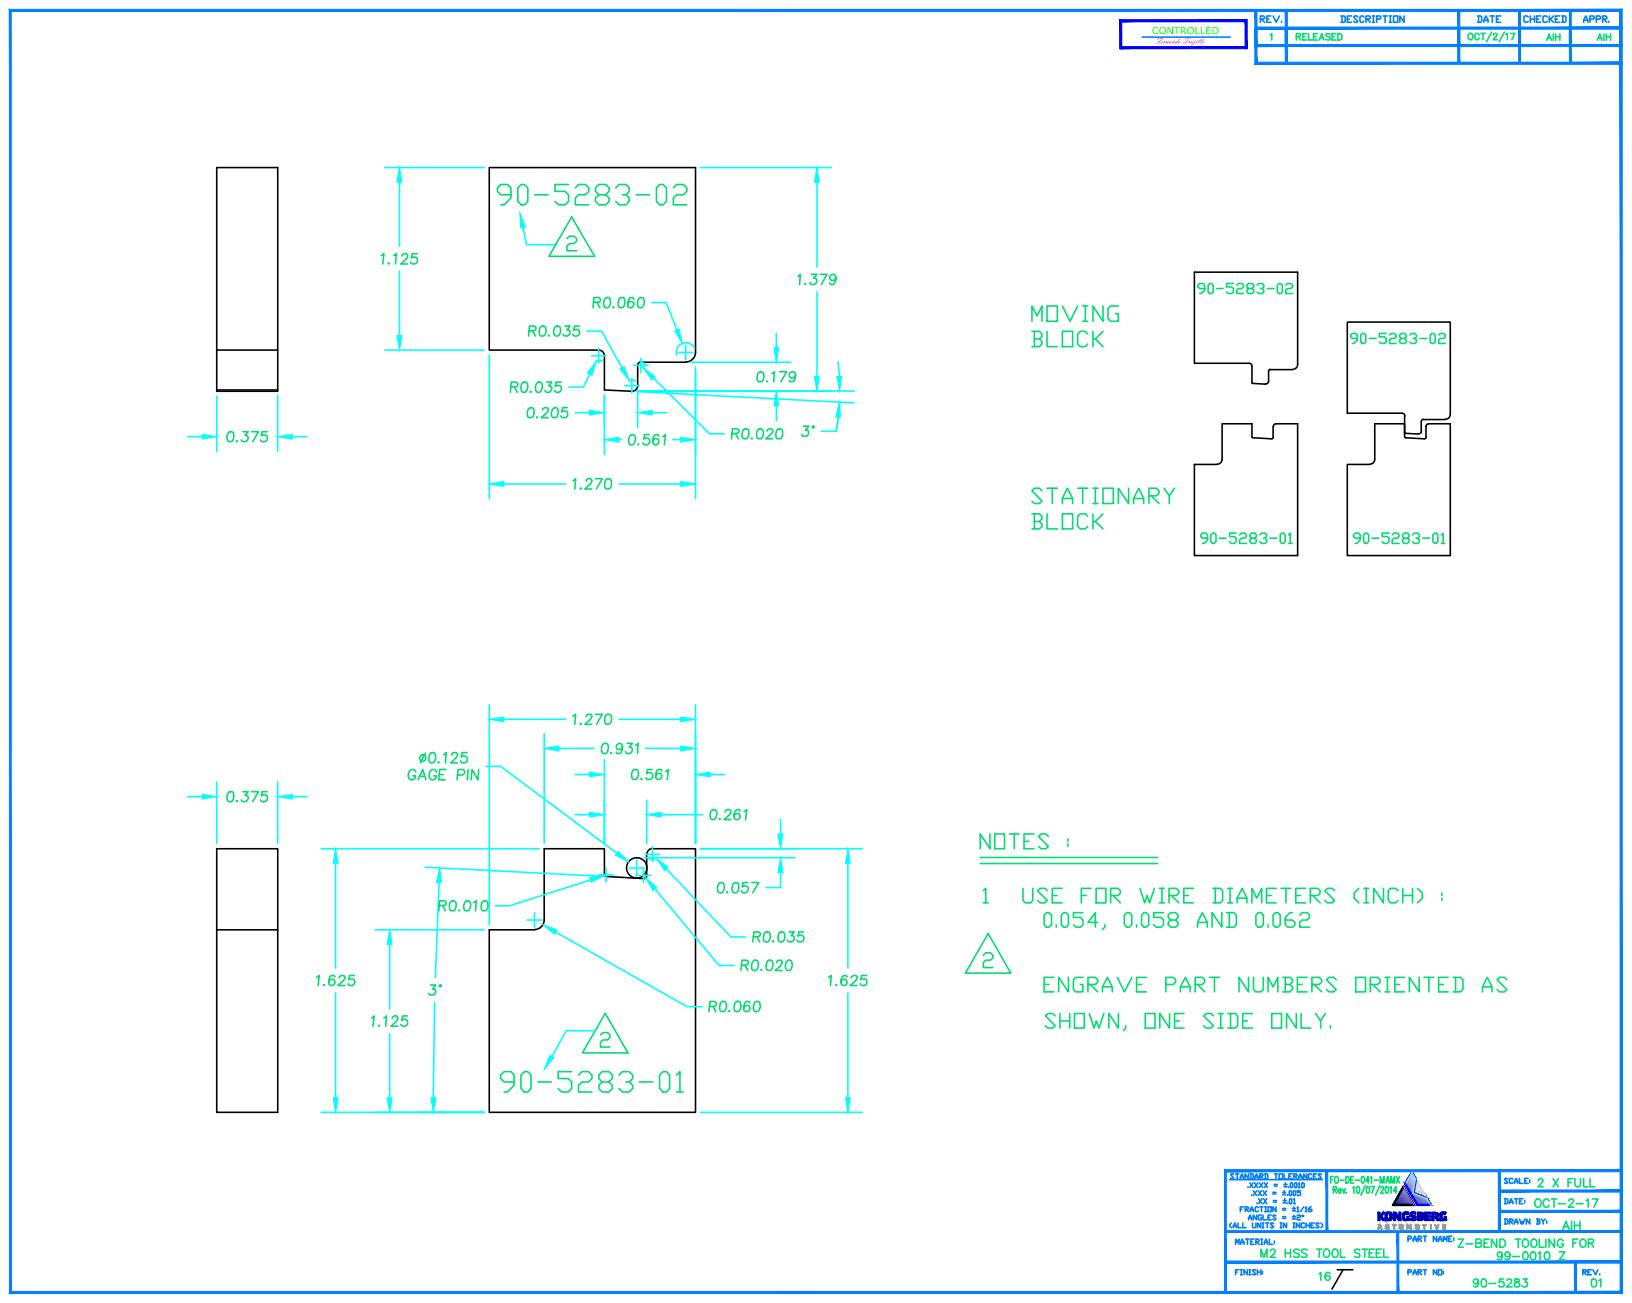
[picture p111: page 1]
