jemiliano2001-blip/SMV-VISION/TOOL CRIB/BIRD-CAGE-BLOCKS/90-1304-17_Rev2_BIRD-CAGE-BLOCK/90-1304-17rev2.pdf

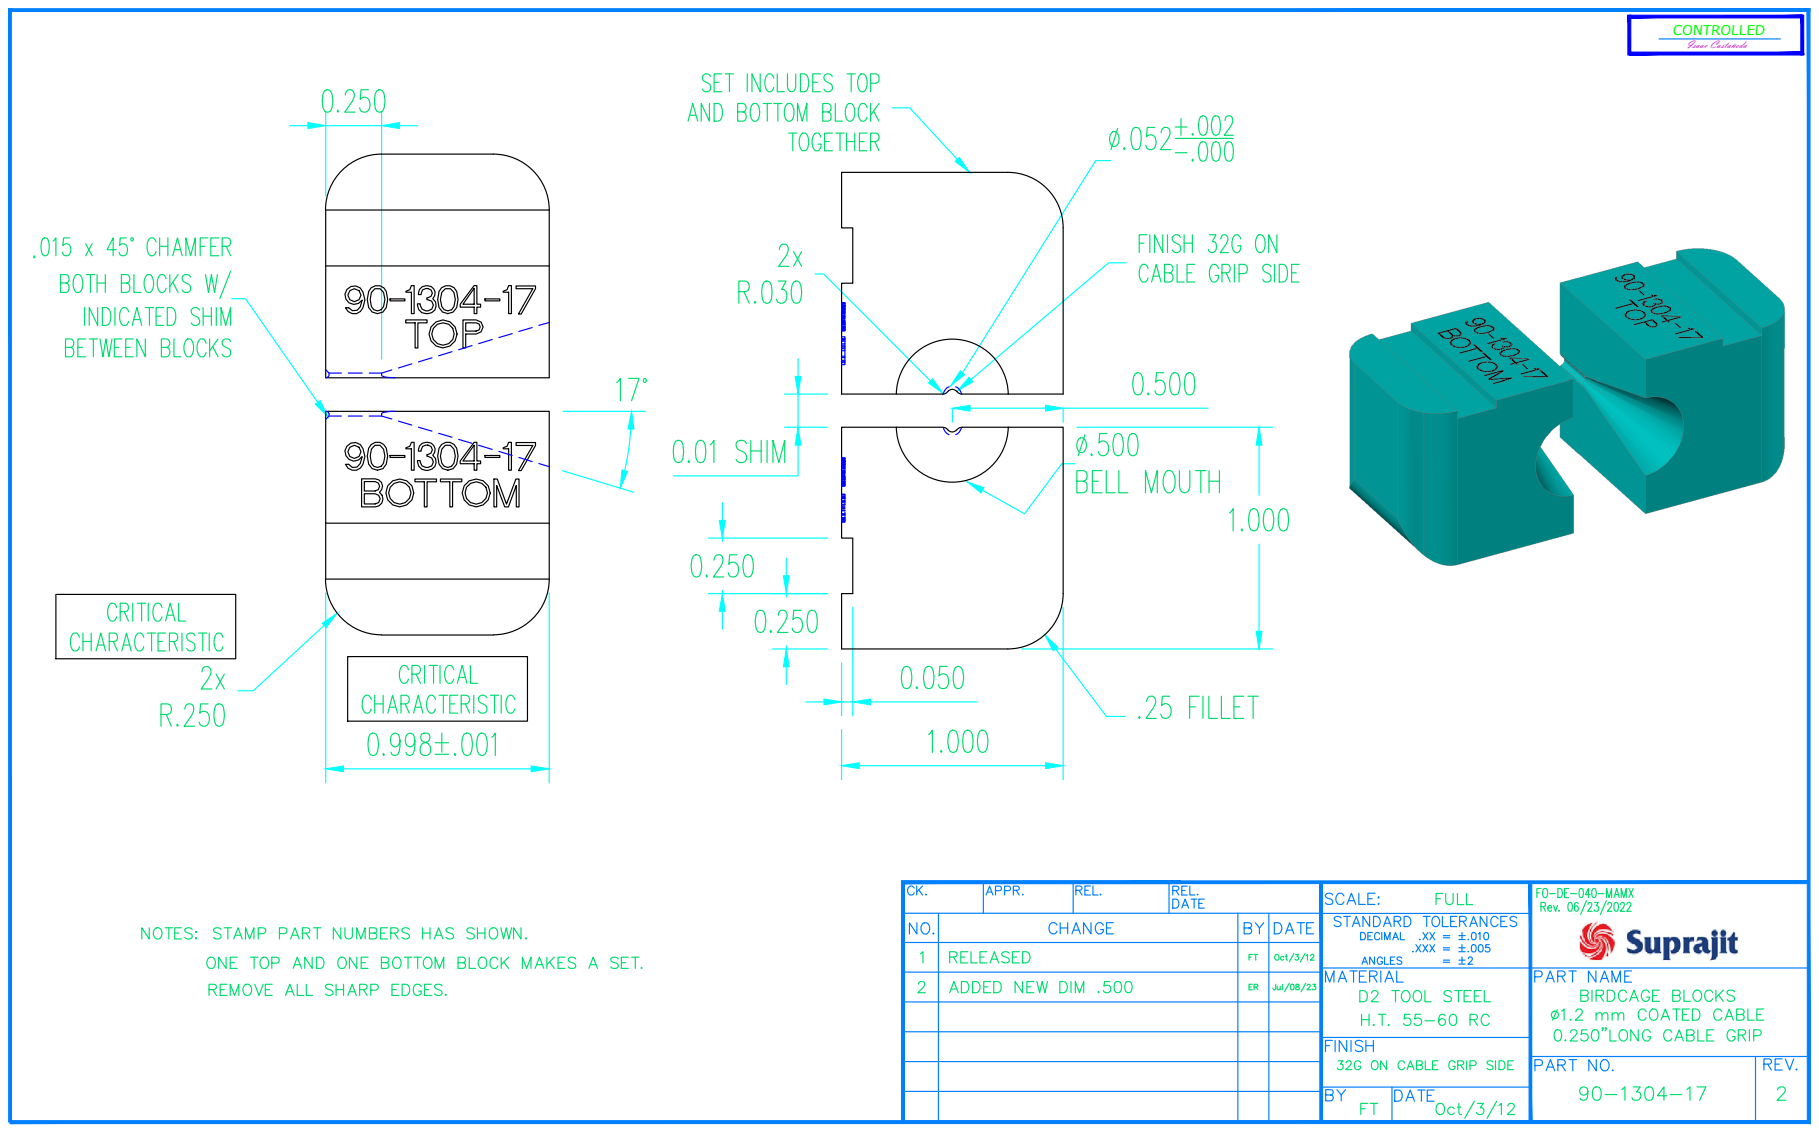
[picture p112: page 1]

Isaac Castañeda CONTROLLED
