jemiliano2001-blip/SMV-VISION/TOOL CRIB/BIRD-CAGE-BLOCKS/90-1304-XX_Rev14_BIRD-CAGE-BLOCK/90-1304-XXrev14.pdf

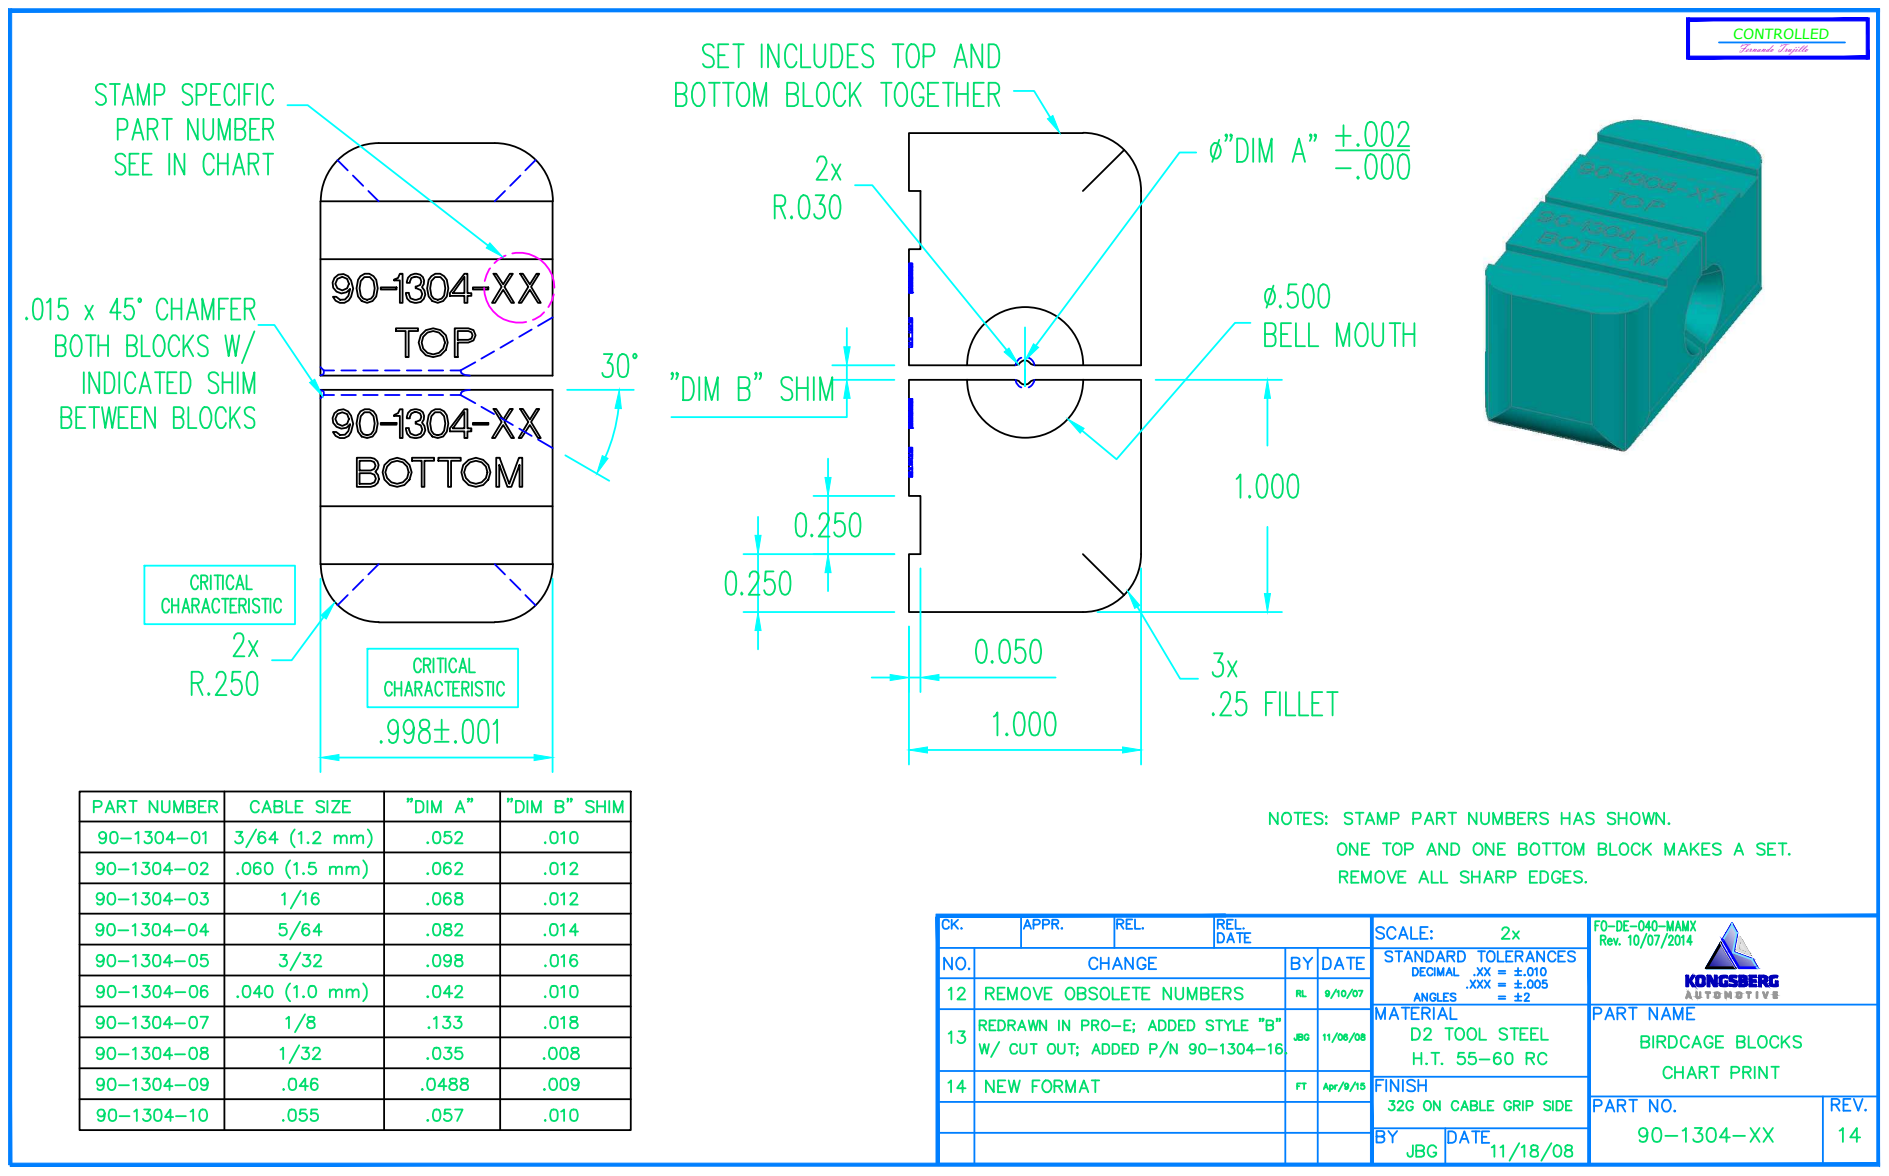
[picture p113: page 1]

Fernando Trujillo CONTROLLED
