jemiliano2001-blip/SMV-VISION/TOOL CRIB/BLOCKS/BLOCK-1135-2/block 1135-2.pdf

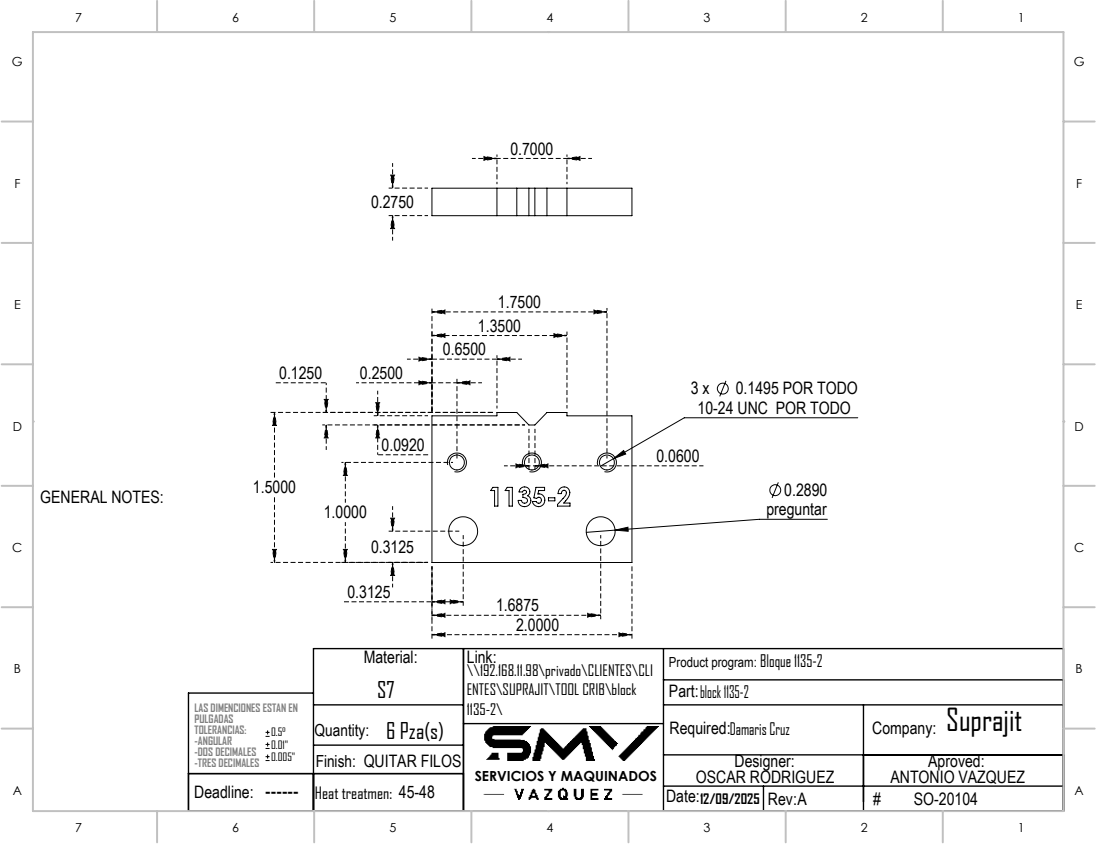
[picture p114: page 1]
Product program:; SERVICIOS Y MAQUINADOS; GENERAL NOTES:; QUITAR FILOS; 6 Pza(s); Bloque 1135-2; block 1135-2; Damaris Cruz

3 x 0.1495 POR TODO
10-24 UNC POR TODO

Link:
\\192.168.11.98\privado\CLIENTES\CLI
ENTES\SUPRAJIT\TOOL CRIB\block

LAS DIMENCIONES ESTAN EN
PULGADAS
TOLERANCIAS:
-ANGULAR
-DOS DECIMALES
-TRES DECIMALES

Designer: OSCAR RODRIGUEZ | Aproved: ANTONIO VAZQUEZ

12/09/2025 Date: | A Rev: | # SO-20104

Deadline: ------ | 45-48 Heat treatmen:
