jemiliano2001-blip/SMV-VISION/TOOL CRIB/BLOCKS/SWAGE-BLOCK/BLOCK-UT2035RB.pdf

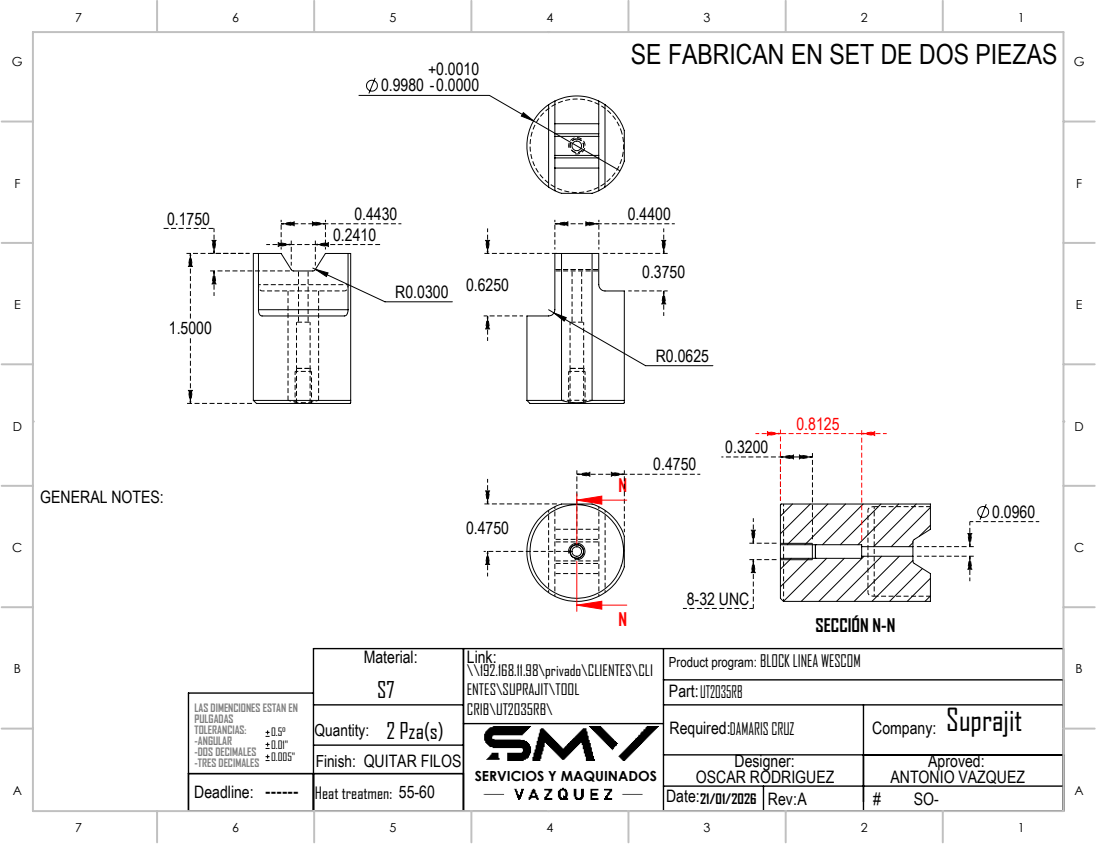
[picture p115: page 1]
8-32 UNC; SECCIÓN N-N; Product program:; SERVICIOS Y MAQUINADOS; GENERAL NOTES:; QUITAR FILOS; 2 Pza(s); DAMARIS CRUZ

SE FABRICAN EN SET DE DOS PIEZAS

Link:
\\192.168.11.98\privado\CLIENTES\CLI
ENTES\SUPRAJIT\TOOL
CRIB\UT2035RB\

BLOCK LINEA WESCOM

LAS DIMENCIONES ESTAN EN
PULGADAS
TOLERANCIAS:
-ANGULAR
-DOS DECIMALES
-TRES DECIMALES

Designer: OSCAR RODRIGUEZ | Aproved: ANTONIO VAZQUEZ

21/01/2026 Date: | A Rev: | # SO-

Deadline: ------ | 55-60 Heat treatmen:
