jemiliano2001-blip/SMV-VISION/TOOL CRIB/BLOCKS/SWAGE-BLOCK/WCD011436SHT1rD.pdf

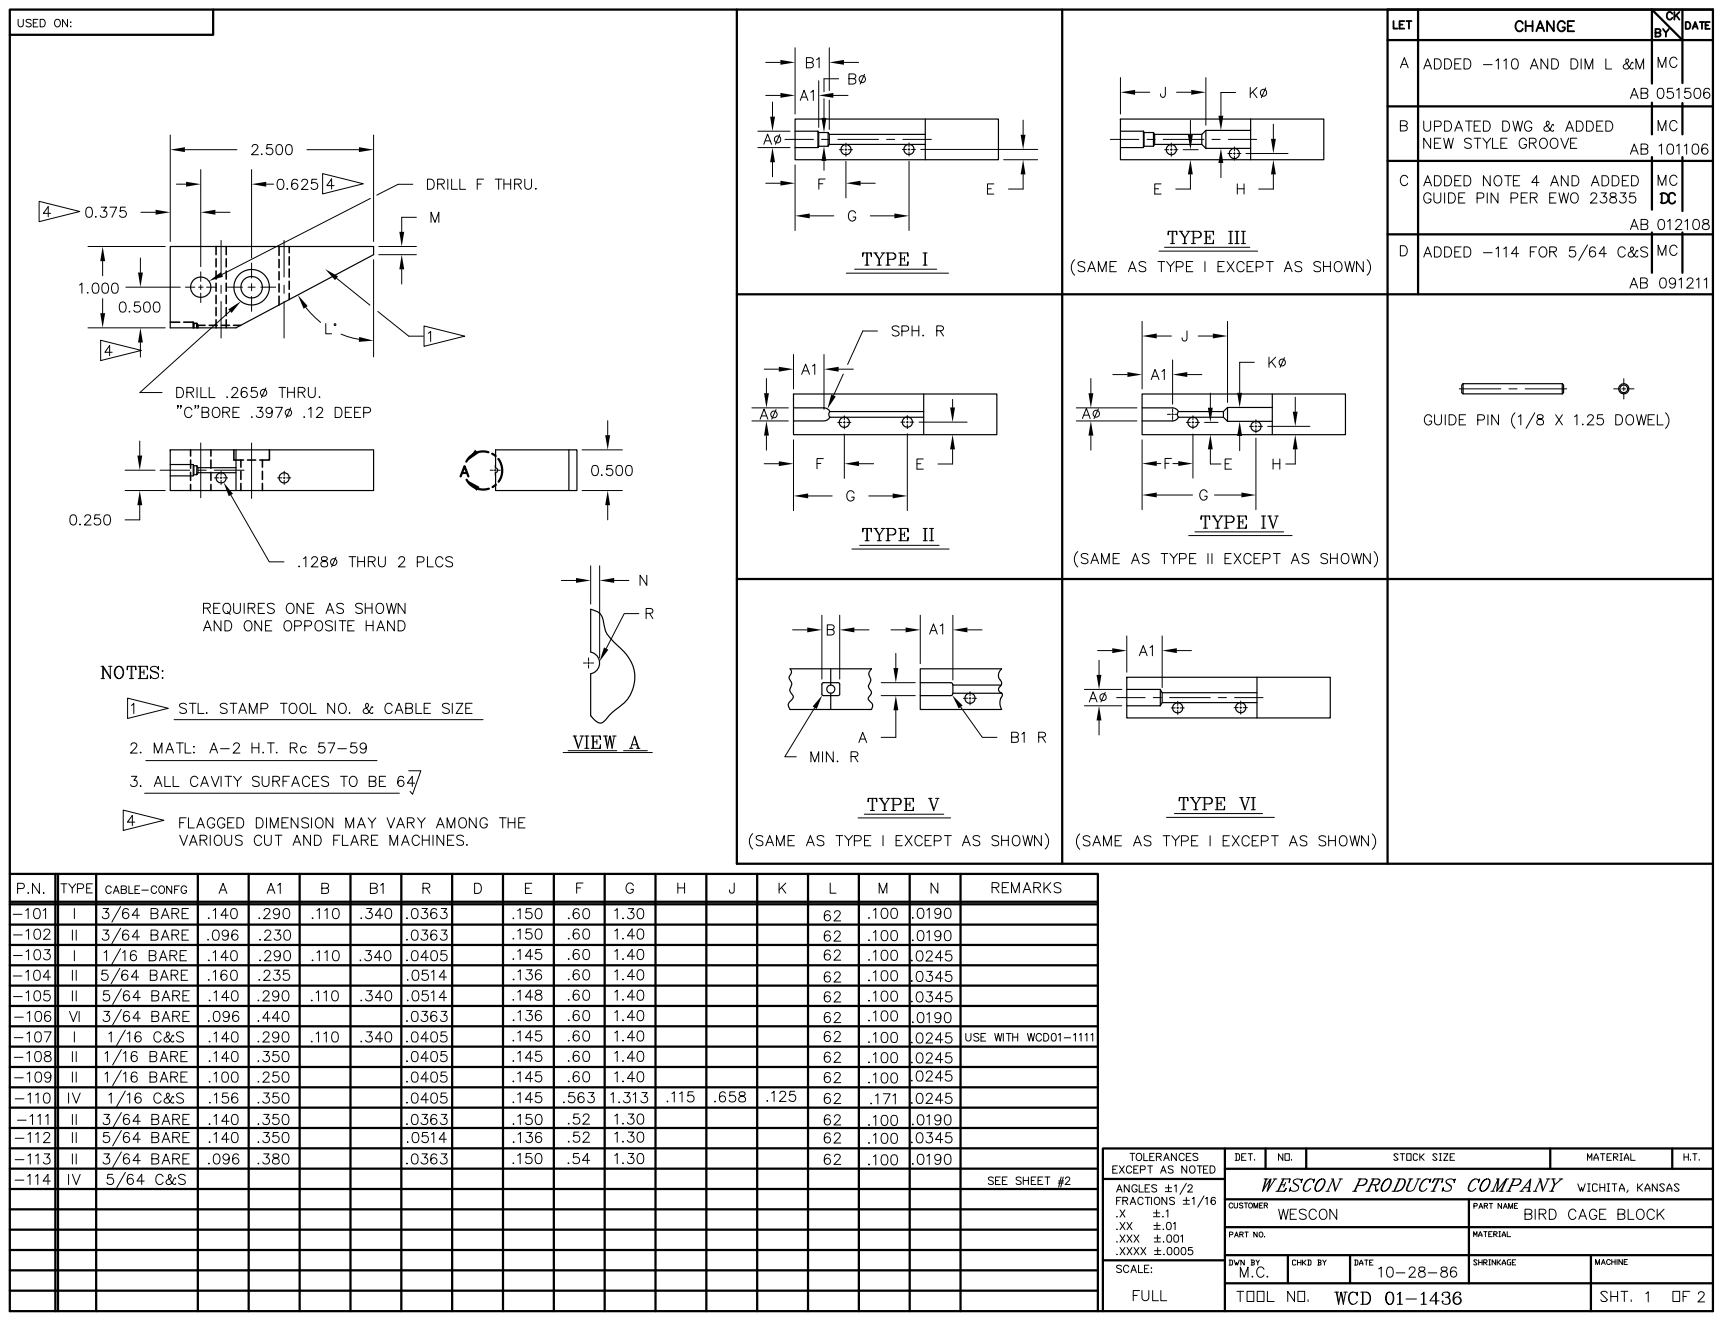
[picture p116: page 1]
