jemiliano2001-blip/SMV-VISION/TOOL CRIB/BLOCKS/SWAGE-BLOCK/WCD011436SHT2rA.pdf

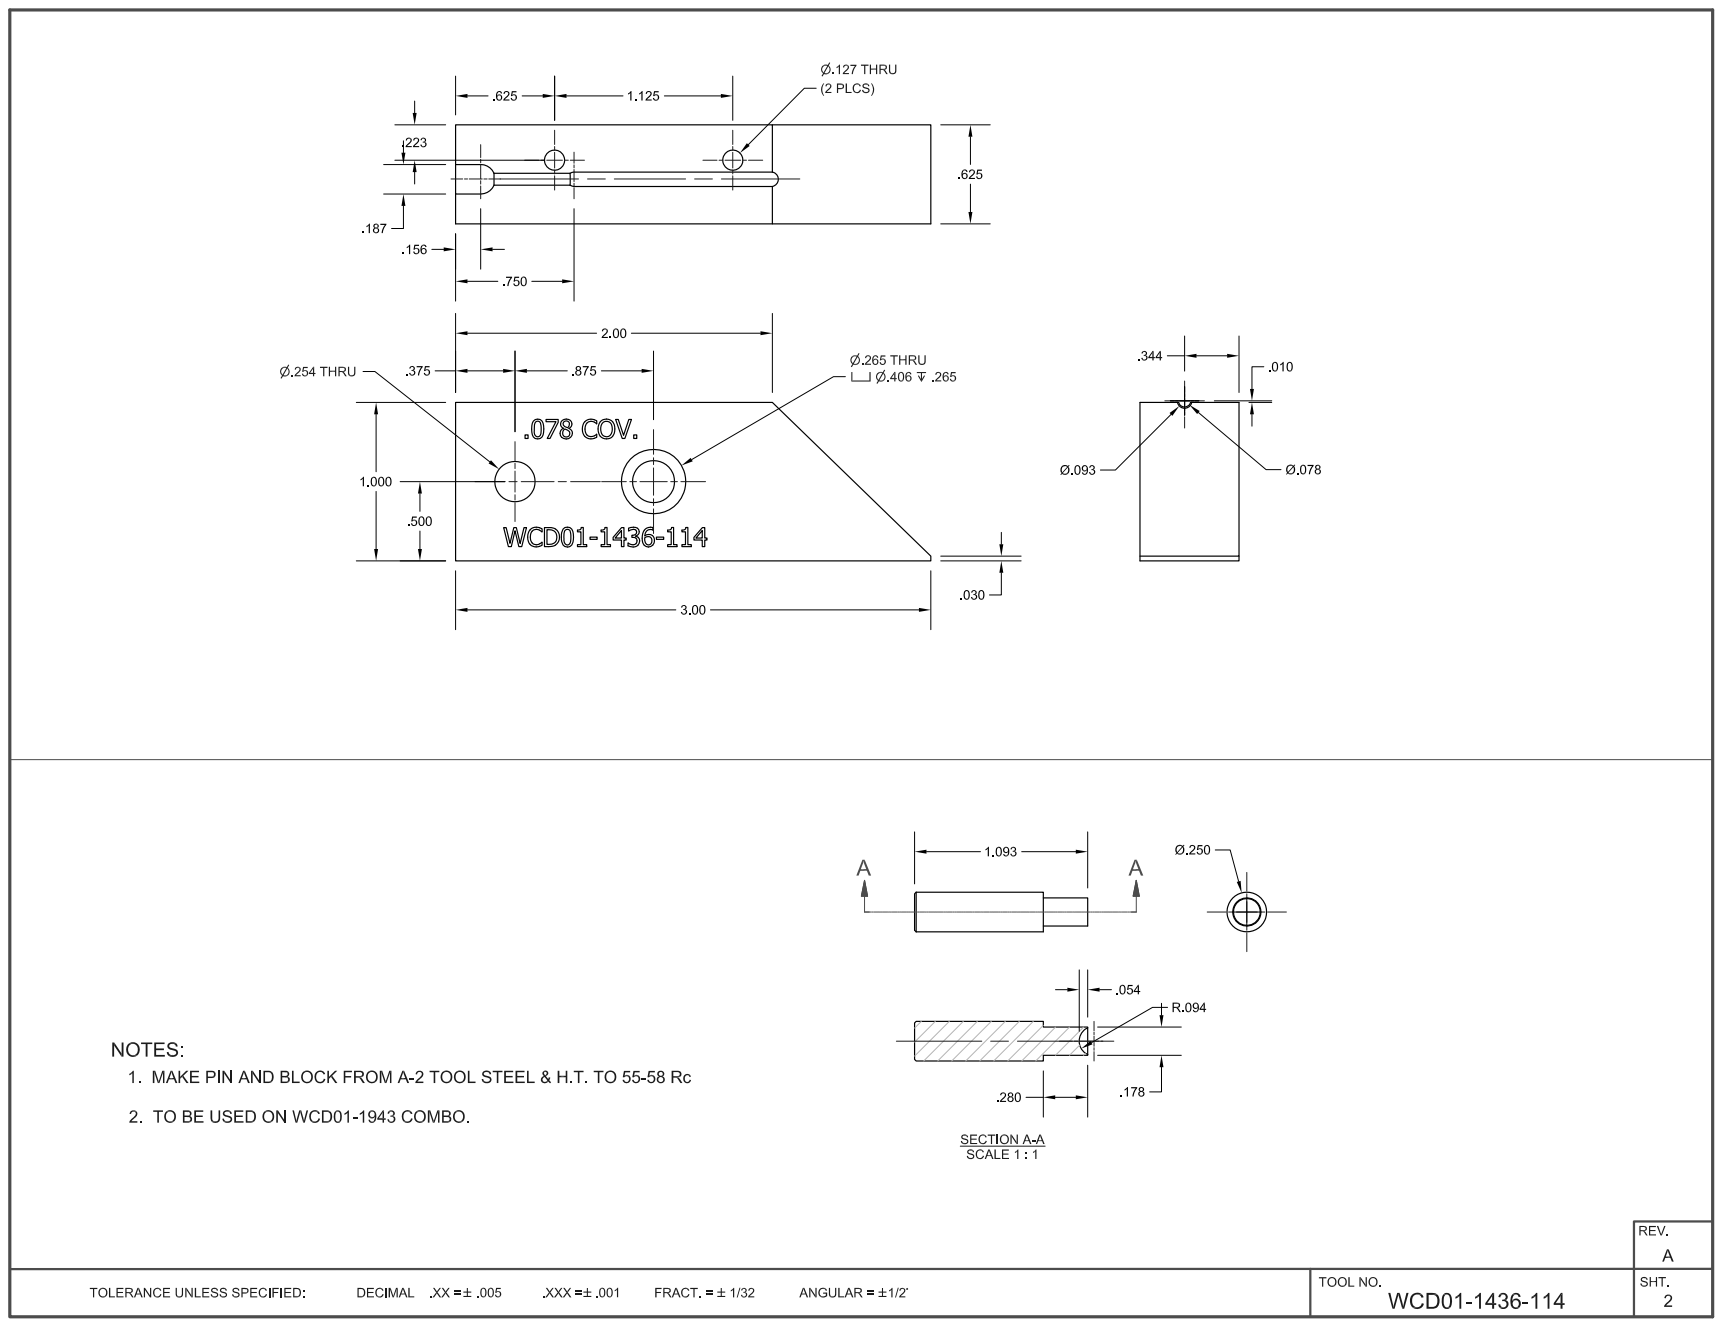
[picture p117: page 1]
