jemiliano2001-blip/SMV-VISION/TOOL CRIB/NAVAJAS-SEGUNDO-CORTE/90-1012-05_Rev3_NAVAJAS-SEGUNDO-CORTE/90-1012-05rev3.pdf

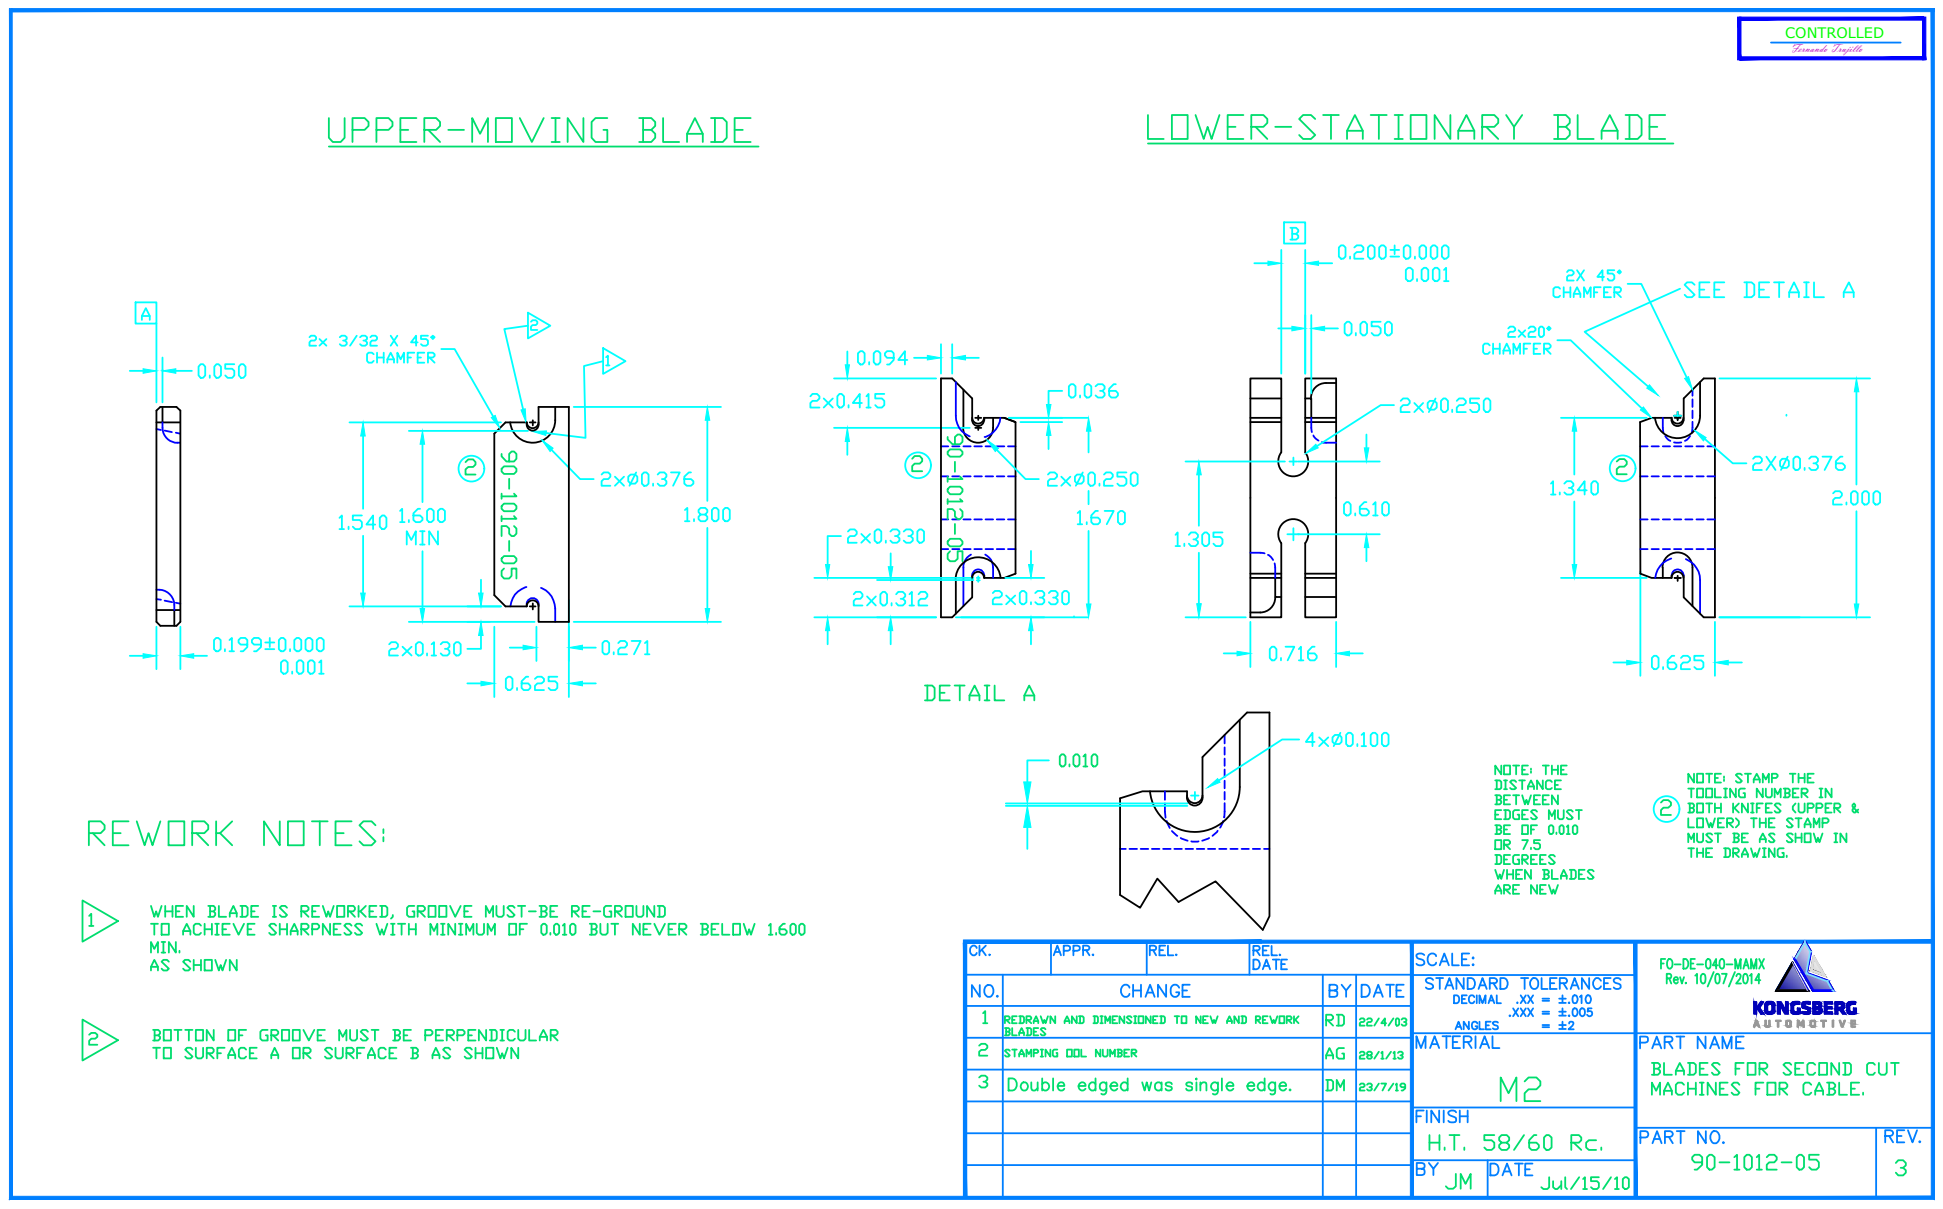
[picture p118: page 1]

Fernando Trujillo CONTROLLED
