jemiliano2001-blip/SMV-VISION/TOOL CRIB/NAVAJAS-SEGUNDO-CORTE/90-1012-06_NAVAJAS-SEGUNDO-CORTE/90-1012-06rev4.pdf

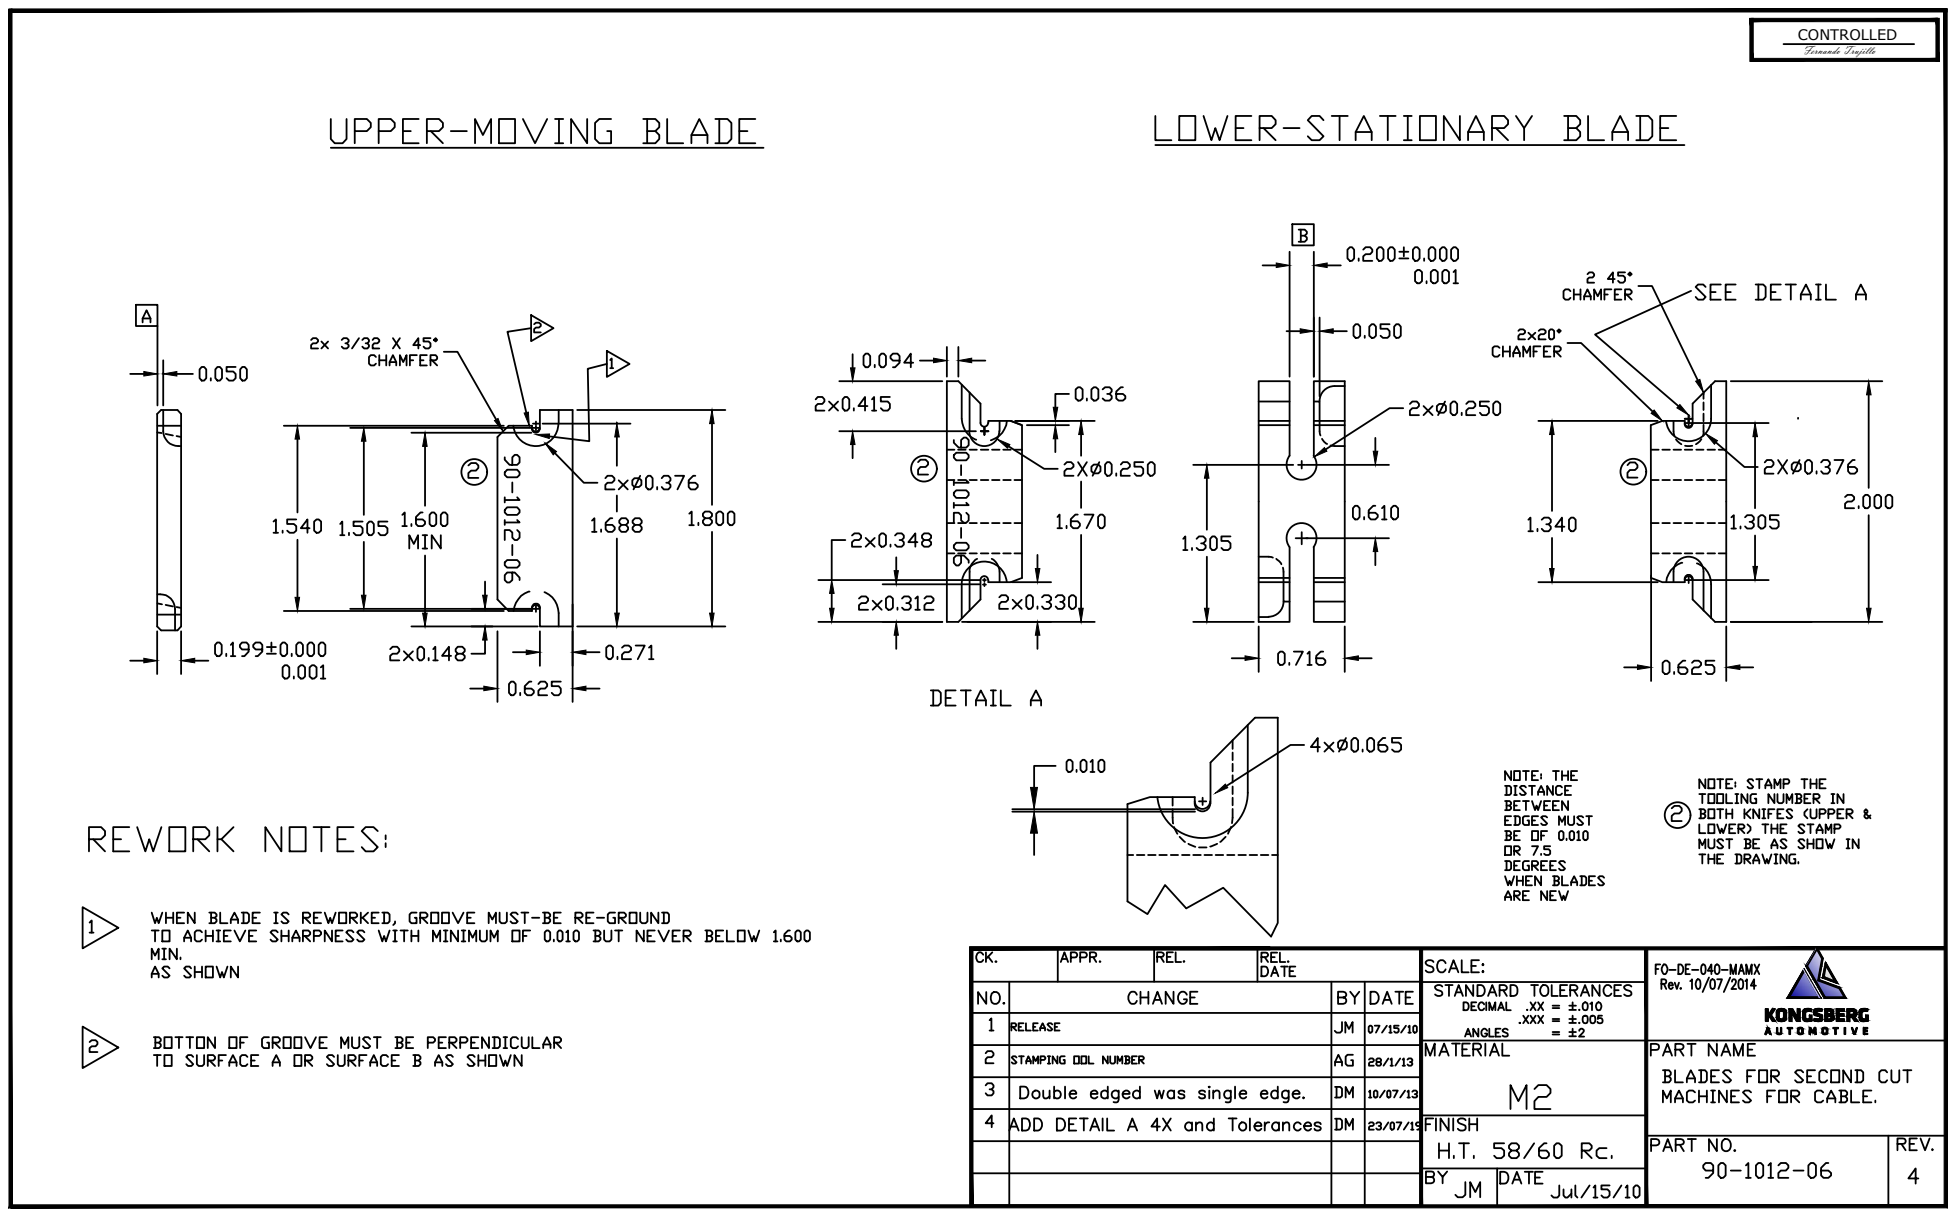
[picture p119: page 1]

Fernando Trujillo CONTROLLED
