jemiliano2001-blip/SMV-VISION/(commit log)

2026-04-16 feat: harden PDF extraction and Gemini env handling
    Improve PDF processing reliability with strict parsing/validation, add typed extraction models, and switch API key wiring to Vite env conventions.
    Made-with: Cursor
2026-04-17 feat: optimize document analysis with worker pipeline
    Move PDF image extraction to a dedicated worker with concurrency controls and caching support, and wire app/build config for pdfjs wasm assets to improve reliability and performance.
    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
2026-04-21 feat: integrate Firebase Tool Crib library and blueprint auto-matching
    - Adds Firebase configuration, AuthGate, and Firestore rules/indexes.
    - Introduces ToolcribLibraryPanel to fetch active drawing views.
    - Implements auto-matching logic in App.tsx to automatically attach library PDFs that match order piece identifiers.
    - Fixes TypeScript build errors and duplicated functions in extraction logic.
    - Adds toolcribBootstrap scripts for seeding the database.
2026-05-04 cambios antigravity
    [14259-63-20-93.SLDDRW, 14259-63-20-93.SLDPRT, 273-17-04167.SLDDRW, 273-17-04167.SLDPRT, 386298.SLDDRW, 386298.SLDPRT, 386306.SLDDRW, 386306.SLDPRT]
2026-05-20 perf: parallelize analysis pipeline for faster blueprint processing
    - Auto-fetch matched library blueprints in parallel (Promise.allSettled)
    instead of sequentially — N fetches now take 1x network latency
    - Two-pass bounding-box refinement now runs concurrently per spec
    (Promise.all) instead of sequentially — multi-part blueprints go from
    N*2s to ~2s per blueprint
    - Pre-compute library and manual-PDF signals once before the matching
    loop, eliminating O(orders*library) redundant signal extractions
    - Cache hits bypass the concurrency pool via a parallel pre-phase so all
    5 concurrency slots are always used for live Gemini calls
    - Deduplicate identical cropIsometricView calls withi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
2026-05-29 docs: spec de Control de Órdenes (capa de trazabilidad)
    Diseño aprobado para la capa de control sobre el generador de reportes:
    - registro persistente de órdenes por pieza-PO en Firestore
    - estados Pendiente -> Entregada (a tornero + fecha, sello del servidor)
    - insumo: PDF multi-hoja, una PO por hoja, con PO + SO + fecha de OT
    - plano-OT = blueprint original con medidas, sellado con SO/cantidad/fecha
2026-05-29 docs: plan de implementación de Control de Órdenes
    Plan por tareas (11) para la capa de control: tipos, dedupe puro,
    validadores + capa de datos Firestore, sello plano-OT con pdf-lib,
    extracción de PO, upsert en el pipeline, pestañas y panel de control.
    Verificación vía tsx (lógica pura) + tsc + checks manuales.
2026-05-29 chore: baseline WIP antes de Control de Órdenes
    Refactor en progreso ya cableado (lib/log, lib/age, lib/matching,
    lib/orderMerge, lib/fetchPdf) + ajustes en App.tsx/types.ts. Se fija
    como punto de partida limpio para implementar Control de Órdenes.
2026-05-29 feat(work-orders): upsert extracted orders into control layer
    Captures the best matched drawing per order (drawingId, partId, score)
    and persists all extracted orders — matched or not — into the Firestore
    workOrders collection via upsertWorkOrders after the auto-match phase,
    so unmatched orders are also tracked as "pendiente sin plano".
2026-05-30 fix(work-orders): narrow upsert result via ok===false idiom
    Reemplaza una aserción de tipo espuria (introducida al implementar el
    upsert) por el idioma de unión discriminada que ya usa la capa de datos
    (workOrders.ts: `if (result.ok === false)`). El truthiness-narrowing
    `if (x.ok) { } else { x.reason }` no estrechaba la rama else; el chequeo
    de igualdad sí. Sin aserción, sin widening.
2026-05-30 feat(ui): Control de Órdenes panel (list, deliver, plano-OT, torneros)
2026-05-30 fix: corrige 5 bugs de lógica/runtime encontrados en revisión de código
    - workOrders: fragmenta WriteBatch en chunks ≤500 para no exceder el límite
    duro de Firestore (antes, un PDF con >500 piezas tiraba todo el lote)
    - workOrders: reemplaza lectura capada (max 2000) por paginación completa
    en loadExistingDedupeKeys, evitando duplicados cuando la colección crece
    - workOrders: markDelivered devuelve { deliveredToTornero } con el nombre
    ya saneado para que el update optimista de la UI sea consistente con lo
    que quedó guardado
    - WorkOrdersPanel: usa res.value.deliveredToTornero en el update optimista
    - App: agrega img.onerror en cropIsometricView y cropToBoxRaw — sin esto
    u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
2026-05-30 feat(control): sistema de control de producción Suprajit v2
    Convierte "Control de Órdenes" en un sistema completo de trazabilidad:
    Datos (aditivos — no rompen documentos existentes):
    - WorkOrderStatus: agrega 'en_proceso' y 'terminada' al ciclo de vida
    - WorkOrder: nuevos campos dueDate, assignedToTornero, assignedAtUTC,
    finishedAtUTC y notes
    - upsertWorkOrders: calcula dueDate automáticamente = otDate + 14 días
    (estándar Suprajit) al crear; nunca sobreescribe si ya existe (preserva
    overrides manuales)
    - updateOrderStatus: transición de estado con timestamps correspondientes
    (assignedAtUTC / finishedAtUTC / deliveredAtUTC) en una sola llamada
    - updateDueDate y updateNotes: e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
2026-06-02 feat: ISO-first matching, hot stamp ISO reference, multi-view shell, new TOOL CRIB blueprints
    Matching:
    - ISO-first: when an ISO candidate scores >= 80, it wins over CAD blueprints unconditionally
    - Applied in both the library auto-match loop and applyBlueprintToResults for manual uploads
    - ISO holds its position against non-ISO in progressive blueprint merging
    Hot stamps:
    - isHotStampCatalogEntry() detects punzones entries in catalog by keyword (PUNZON/HOT STAMP/ESTAMPAD)
    - extractInfo() rasterizes the hot stamp ISO reference without Gemini (full page as reference image)
    - consolidateHotStamps() accepts optional refImage; synthetic row appears in main PDF table with DIBUJO column
    App shel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
    [386298 VERSION OBSOLETA.SLDDRW, 386298 VERSION OBSOLETA.SLDPRT, 90-3262-Rev4.SLDDRW, 90-3262-Rev4.SLDPRT, 90-5317Rev2.SLDDRW, 90-5317Rev2.SLDPRT, 90-5492rev1.SLDDRW, 90-5493rev1.SLDDRW]
2026-06-02 feat(hook): add state, file handlers and export functions to useVisionAnalysis
    Replaces the stub implementation with all useState/useRef declarations,
    cleanup useEffect, file ingestion handlers, drop handlers, toolcrib
    attachment logic, copy/CSV/JSON/PDF export wrappers, and a partial
    return statement. extractInfo remains a placeholder for Task 4.
2026-06-03 feat(hook): complete useVisionAnalysis with edit handlers and derived state
    Add snapshotOriginalOnce, handleEditCantidad, handleExcludeOrder,
    handleRestoreOrder, handleRestoreAll (with findWorkOrderId substitution),
    auditedCount useMemo, and filteredResults useMemo. Replace all stubs
    with real implementations and expand the return statement.
2026-06-03 refactor: wire App.tsx to useVisionAnalysis hook (~772 lines)
    Removes all analysis state, helpers, and logic that moved to
    useVisionAnalysis. App.tsx now holds only shell state (activeView,
    controlAlert), the workOrderByKey/findWorkOrderId wiring, and JSX.
    All analysis references updated to vision.* prefix.
2026-06-04 test: add unit tests for lib/matching.ts
    - Coverage for normalizePieceLabel: accent normalization, whitespace handling, special character removal
    - Coverage for extractPartIdentifiers: segmented part numbers, compact identifiers, deduplication
    - Coverage for descriptiveTokens: stop word filtering, token length/character requirements
    - Coverage for scorePieceMatch: identifier matching, penalty rules, descriptor overlap scoring
    - Coverage for extractOrderSignals and extractLibrarySignals: multi-source signal extraction
    - Coverage for selectBestBlueprintMatch: spec selection, unused spec preference, .iso file boost
    Total: 42 tests covering all public exports of matching.ts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
2026-06-05 fix: add dueDate sort case, remove stale comments in WorkOrdersPanel
    - Add missing dueDate sort case in kanban board column filter
    - Fix Date.now() to Infinity in manual sort mode
    - Remove redundant key prop on OrderCard inside Draggable
    - Remove stale "// Nuevas props" comment from OrderCardProps interface
2026-06-05 feat: wire useDailySnapshot into WorkOrdersContext
2026-06-08 feat: add analytics charts to Inicio view (stage, tornero, on-time trend)
2026-06-08 chore: update codebase, components, scripts, and configuration
    [14259-63-20-93.SLDDRW, 14259-63-20-93.SLDPRT, 273-17-04167.SLDDRW, 273-17-04167.SLDPRT, 386298 VERSION OBSOLETA.SLDDRW, 386298 VERSION OBSOLETA.SLDPRT, 386306.SLDDRW, 386306.SLDPRT]
2026-06-09 fix(functions): port proven Odoo sync into scheduled syncSuprajitOrders
    The scheduled Cloud Function failed on every run (Faltan variables de
    entorno de Odoo) and never synced orders. Root causes:
    - functions/.env.local is emulator-only and was never deployed
    - code read ODOO_USERNAME but the config defines ODOO_USER
    - execute_kw was called with a malformed 5-arg signature (the library
    takes 4 args), so the Odoo call was broken even with valid creds
    - it wrote raw Odoo fields to workOrders without the WorkOrder schema
    (no pieza/archived), so the app never displayed them
    Rewrite the function as the automatic equivalent of scripts/syncOdoo.ts:
    fetch sale.order + lines + pickings + moves,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
2026-06-09 fix(app): close truncated JSX in App.tsx after ReportView extraction
    App.tsx was cut off mid-refactor right after </AppShell>, leaving the
    fragment unterminated (Vite: Unterminated JSX contents). Restore the
    closing tags and drop imports left unused by the extraction (React,
    useEffect, formatAgeDays/getOrderAgeDays) since the report preview now
    lives in ReportView.
    Also lands the in-progress UI decomposition this depends on: the new
    ReportView component, the WorkOrders/ board components extracted from
    WorkOrdersPanel, and the DEV-gated login bypass in AuthGate.
